Supermagnum/SDR-repeater/analog/vco/sch/README.md

# P2.7.1 xschem capture (VCO + D22 amp-cal + D21 LDO)

Generated by `gen_xschem.py` from `step2/out/range.json`, `ampcal/amp_common.py`, and `ldo/run_d21_vrana1.py` `ldo_body`.

## Hierarchy

| Cell | Role |
|---|---|
| `l2n0` | Tapped inductor lumped EM model |
| `vco_core` | XC pair + fixed MIM |
| `vco_bank` | 8-bit bank + trims + bypass |
| `vco_var` | AC-coupled svaricap_fx + bypass |
| `vco_tail_dac` | D22 OTA DAC + tail + D9 filter |
| `ampcal_det` | D22 peak det + SE comparator |
| `vrana1_ldo` | D21 LDO |
| `vco_sim_flat` | Flat VCO for netlist/sim export |

Exports: `exports/*.svg`, `exports/*.pdf`. Netlists: `netlists/`. Summaries: `out/summary_*.txt`.
