Supermagnum/SDR-repeater/reports/sch-rerun-2026-10-31.md

# VACASK SCH re-run before P2.7 — 2026-10-31

Pre-layout check of results that status-2026-10-30 only file-checked. Image `hpretl/iic-osic-tools:2026.10`, PDK `a49358cc`, VACASK `fb8cc20`.

| Block | Command | Result | Verdict |
|---|---|---|---|
| VCO range | `run_step3.py range` | All 15 cases cover; peak V_GS/V_GD ≤ 1.48 V | **pass** |
| VCO PSS root cause | A/B + parts | Off-state **bank** bypass MOS break PSS; tail and varactor OK | `summary_pss_bypass_parts.txt` |
| VCO PN (bank omitted) | `run_pnoise_nobank.py` | tt 3.65: −122.7 dBc/Hz @ 1 MHz (+6.7 dB); ss85 4.20: −119.4 (+3.4 dB) | **pass** — VCO layout may start |
| VCO PN (full MOS bank bypass) | PSS + ZOH transient | PSS abort; ZOH timestep-too-small | — |
| VCO PN (linear bank equiv) | `run_pnoise_banklin.py` + probes | PSS abort (full C/R/Rsh; C-only; bank-only; 0.1×C) | abandoned |
| VCO switch-noise bound | `run_bound_bank_switch.py` | tt 3.65 Δ = +0.591 dB (FAIL); ss85 Δ = +0.006 dB | **STOP** vs ≤0.5 dB |
| LO UHF tt | `lo/step3 corners uhf tt` | divide OK | **pass** |
| PLL 2 µs smoke | `run_p26s3.py tstop=2u` | start-up OK | **smoke pass** |
| UHF LO floor | `run_uhf_floor.py` | **full** ÷2+Johnson chain; −150.1 dBc/Hz @ LO | **pass at −150 limit** (optimistic: noisefmax 5 GHz) |

## UHF LO floor

Full UHF path (buffer + CML ÷2 + AC converter + Johnson ÷4 / retiming). Converges at noisefmax **5 GHz** only (50/20/10 GHz abort). LO-referred **−149.4 / −150.1 / −151.4 dBc/Hz** at 1–3 / 3–10 / 10–30 MHz. Recorded as meeting the −150 dBc/Hz limit; the truncated ÷2+converter figure (−155.7) was a partial-chain method and is not the floor used in totals. Totals: `summary_total.txt` (UHF −145.3 / −143.8 dBc/Hz at 36 MHz). Divider unchanged.

## VCO pnoise

| Bypass devices present | PSS |
|---|---|
| none | PASS |
| tail only | PASS |
| varactor only | PASS |
| bank only | FAIL |
| all (current schematic) | FAIL |

Bank-omitted PN is accepted for starting VCO layout. Linear off-state bank equivalent abandoned (PSS fails). Bound: bank-plate R noisy vs quiet + ρ = (2q·I_leak)/(4kT/R) from DC I_leak (`summary_bound_bank_switch.txt`) — tt 3.65 **FAIL** (+0.591 dB with ff/125 °C I_leak); ss85 PASS. **STOP** vs ≤0.5 dB. Post-layout PN: bank-omitted PEX + this bound until VACASK is fixed (`spec/p27-layout-notes.md`); method not cleared at tt. Draft issue (not posted): `reports/upstream-issues/vacask-pss-off-nmos-tank.md`. Dividers and PLL layout may start.
