Supermagnum/SDR-repeater/reports/status-2026-10-30.md

# Status audit and verify — 2026-10-30

Prompt 01. Tools: host Python 3 + container `hpretl/iic-osic-tools:2026.10`. Image PDK `/foss/pdks/ihp-sg13g2/COMMIT` = `a49358cc0b20635fcb53c0940505e3563763fc7a`. VACASK `fb8cc20`, ngspice 47. No design or spec edits except refreshing `analog/pll/p26/step2/out/summary_total.txt` from a re-run (see mismatches).

---

## Phase 0 — EM / process setup

| Step | Status in the spec | Files that prove it | Re-run OK? | Open points |
|---|---|---|---|---|
| Matched-mesh tank EM (L2n0) | Accepted 2026-10-20; Q 14.2 / 15.3 / 16.9 | `spec/provisional-tank-q.md`, `reports/phase2-review/p20-stage*.md` | not re-run (EM hours; stack pin unchanged) | — |
| Flicker / pnoise method | Validated | `analog/pn-validation/`, `reports/phase2-review/p20-flicker.md` | not re-run | — |

## Phase 1 — digital back end

| Step | Status in the spec | Files that prove it | Re-run OK? | Open points |
|---|---|---|---|---|
| `phase1l` sign-off | Signed off; area 339 617 / 340 000 µm² | `decisions.md` 2026-10-19; `rtl/digital/runs/`; `reports/phase1-review/` | not re-run (layout hours) | No area left; `rx_on`/`tx_on` expose deferred |
| cocotb / gate | Suites recorded pass | `rtl/digital/` | not re-run this session | — |

## Phase 2 — LO / synthesizer

| Step | Status in the spec | Files that prove it | Re-run OK? | Open points |
|---|---|---|---|---|
| P2.0 tank Q | Done, accepted | `spec/provisional-tank-q.md` | see Phase 0 | — |
| P2.1 D1–D7 | Accepted | `decisions.md` | N/A (decisions) | — |
| P2.2 system model | First run; later superseded by D19 | `analog/pll-model/` | model still runs; D19 values live in p26 | Spec still says “draft”; plan §3 more current |
| P2.3 VCO (D20 8-bit) | Schematic done; result review done | `analog/vco/step1–3/out/summary_*.txt`, `spec/vco-topology.md` §9 | SCH not re-run (VACASK hours); svaricap pin checked | Amplitude cal, supply pushing, HBT compare, real CML load |
| P2.4 LO dividers | Accepted 2026-10-21 | `analog/lo/step3/out/`, `spec/lo-divider-topology.md` §9 | SCH not re-run | Layout P2.7; UHF floor method |
| P2.5 PFD/CP/MMD/RTL | Complete, accepted | `analog/pll/step1–4/`, `rtl/afe/` | RTL re-run pass; SCH not re-run | — |
| P2.6 closed loop | Steps 1–4 done; **owner review next** | `analog/pll/p26/`, `spec/pll-topology.md` §13 | Models re-run pass; SCH closed-loop / LO UHF not re-run | Open points 1–4 in §13; no acceptance in `decisions.md` yet |
| P2.7 layout | Not started | — | — | Blocked on P2.6 acceptance |

## Board / host (existing)

| Step | Status in the spec | Files that prove it | Re-run OK? | Open points |
|---|---|---|---|---|
| VHF harmonic LPF | Decided; scripted | `tools/vhf_lpf_check.py`, `docs/rf-switches-and-filters.md` | **pass** this session | Layout parasitics not in script |
| RF switch survey | Survey | `docs/rf-switches-and-filters.md` | N/A | Parts not final; PDF not in repo (link only) |

---

## Step 2 — verify vs limits

Legend: **pass** = re-ran this session and meets limit (or within ≤ 0.5 dB / ≤ 2 % of recorded). **file-ok** = recorded `out/summary_*.txt` meets limit; transistor VACASK not re-run this session. **not-re-run** = blocked or not applicable yet. **fail** = none this session.

### Phase 2 LO / synthesizer

| Item | Limit | Recorded | This session | Verdict |
|---|---|---|---|---|
| Tank Q | — | 14.2 / 15.3 / 16.9 | files only | file-ok / not-re-run EM |
| VCO range 8-bit, 15 cases | covers 3.12–4.20 GHz ±3 % L | 2.77–4.55 GHz, all cover | `summary_8bit.txt` | file-ok |
| VCO band steps | even; V_tune window | 0.94–1.07×; 0.24–0.29 V | `summary_steps.txt` | file-ok |
| VCO PN @ 1 MHz | ≤ −116 / −115 | −124.4 … −119.9; +3.9 dB worst | same | file-ok |
| K_VCO | 14–47 MHz/V | 13.1–38.8 | same (bottom slightly under D8 floor) | file-ok (known from review) |
| Peak V_GS / V_GD | ≤ 1.5 V | ≤ 1.48 V | same | file-ok |
| Tail current | ≤ 4 mA | 3.4–4.0 mA | same | file-ok |
| LO dividers corners / MC | divide | all pass (ss −40 °C needs real swing); 100/100 | files | file-ok |
| UHF I/Q / VHF 8-phase / duty | image / HR / ≈25 % | σ 0.47°/0.77°; 0.17°/0.28°; 22.6–25.8 % | files | file-ok |
| Divider noise floor | ≤ −150 dBc/Hz | VHF −154.9/−154.0/−155.5; UHF ≈ −150 `[HAND]` | VHF file; **UHF no convergence** | VHF file-ok; UHF **not-re-run** (method) |
| LO / PLL current | ≤ 10 mA typ; PLL ≤ 1.8 mA | ≈ 9.65 mA; PLL ≈ 1.0 mA | files | file-ok |
| Loop D19 | 60 kHz / 55° | C1 30.8 pF, C2 465 pF, R1 22.9 kΩ, R3 108 kΩ, C3 3.1 pF | confirmed in `closed_loop.py` re-run | **pass** |
| Total PN duplex `[MODEL]` | ≤ −136 dBc/Hz | VHF worst −138.8 (+2.8); UHF −145.2 / −143.7 | `run_p26s2.py total` matches after refresh | **pass** |
| Wake | ≤ 150 µs | 83–120 µs; cal 38.8 µs | `closed_loop.py` full re-run: wake 83–120 µs | **pass** |
| V_tune after cal | 0.25–0.95 V | 0.34–0.82 V | `land` + closed loop | **pass** |
| PFD / CP | no dead zone; INL | ≤ 3.9 ps MC; ≤ 2.1 ps with bias | files | file-ok |
| CP noise FoM | accepted as-is | −203.8 … −205.6; 1/f 79–141 kHz | json inputs to total | file-ok (FoM used) |
| Bias / lock window / hold D19 | I_cp ±2 %; 5–12 ns; ≤ 10 mV | within 2 %; 5.5–10 ns; ≤ 7.6 mV | files | file-ok |
| AFE RTL cocotb | all pass; Σ-Δ bit-exact | recorded pass | `run_afe.py` all PASS | **pass** |
| MMD first 2/3 cell | ≥ 1.3 × 2.2 GHz ss | 2.9 GHz; 10/10 | files | file-ok |
| Closed loop step 3 | locks from power-on | locks, 5× filter, ≤ 7 ppm from 16 µs | `summary_s5.txt` | file-ok |
| Ref / frac spurs `[MODEL]` | ≤ −67 / −95 dBc | −109.3; −123 / −126 | `spurs.py` re-run identical | **pass** |

### Other

| Item | Limit | Recorded | This session | Verdict |
|---|---|---|---|---|
| Digital `phase1l` | signed off | 339 617 µm² | files / decisions | file-ok / not-re-run |
| VHF LPF | ~0.5 dB / ≥ 70 dB | 0.37–0.94; ≥ 70.6; MC ≥ 65.4 | script match | **pass** |

---

## Prompt 02 “Results to re-check” — disposition

| # | Item | Disposition |
|---|---|---|
| 1 | UHF LO-chain noise floor | **Cleared as unverified method limit**, not as a SCH pass. Still ≈ −150 `[HAND]`; transient noise does not converge. Closes “waiting for re-check” for prompt 06 gate: no tool update will fix it (IHP #1047 class / wontfix). Close open point 3 only via a new method (prompt 06 item 2(c)). |
| 2 | First KLayout LVS SVaricap | **not-re-run** — no layout yet; #861 / #753 open |
| 3 | First KLayout LVS `cap_rfcmim` | **not-re-run** — no layout; #512 open |
| 4 | Maximal DRC SVaricap `w=3.74u` | **not-re-run** — P2.7 |
| 5 | HBT local-mismatch MC | **not-re-run** — not used for LO core today; #1112 |
| 6 | Full-chip ngspice with IO | **not-re-run** — no pad-level deck yet; #921 |
| 7 | Magic stdcell spice mix | **not-re-run** — not used; #810 |
| 8 | VCO/PLL with `sg13_hv_svaricap_fx` | **pass (pin check)**: in image PDK, `rwellvw`/`rwellwvw`/`rwellnxvw` still 0; `dsubw` `vj=0.3357`; `svaricap_fixed()` regenerates `out/svaricap_fx.lib` with `v(2,4)` terms replaced by 0. Full VCO/PLL VACASK not re-run (runtime); prior SCH files remain the evidence. |

For prompt 06: **no failed re-run**. Unverified SCH rows are file-backed; the only open “result” that blocks a numeric claim is UHF LO floor, already called out as open point 3 / method change — not a gate stop for the P2.6 review summary.

---

## Mismatches (spec / files / this re-run)

1. **`analog/pll/p26/step2/out/summary_total.txt` was stale.** Committed copy used UHF LO floor −157 dBc/Hz and totals −146.6 / −144.6 (32 MHz). Spec §13 and the current `total` path use ≈ −150 and −145.2 / −143.7. **Refreshed this session** from `run_p26s2.py total`. VHF rows were already correct.
2. **`spec/phase2-plan.md` header** still reads “draft … Nothing in this plan has been designed…” while §3 shows P2.0–P2.6 progress. Finding only — not edited (prompt 01).
3. **K_VCO recorded 13.1 MHz/V** at the bottom vs D8 “14–47 MHz/V”. Already known from P2.3 review; still in the files.
4. **`docs/pe42820ds.pdf`** was untracked locally. Vendor datasheet should stay out of git; link remains in `docs/rf-switches-and-filters.md`.
5. **PCB KiCad** (`PCB/sdr-repeater/*.kicad_*`) dirty in the working tree — owner-owned; not touched.

---

## VACASK upstream (Codeberg, hand look)

Repo: https://codeberg.org/arpadbuermen/VACASK

| Topic | Finding |
|---|---|
| Svaricap / `v(2,4)` expression | No matching issue found. Gap remains IHP model conversion + local `_fx` draft (`reports/upstream-issues/ihp-svaricap-vacask-v24.md`), not a VACASK ticket. |
| Transient / timestep / stiff sims | Historical timestep demos (#1, #2); open **#83** Tolerance limitations. No fix that would make UHF LO noisy transient converge. |
| pnoise feature | Open **#20** “Enable Pnoise analysis” (feature request). Does not change the UHF floor situation for our existing pss/pnoise + transient path. |

---

## Environment note

Container PDK is shipped as a tree with `COMMIT` file (not a live `.git`). Pin matches `a49358cc…`.
