Supermagnum/SDR-repeater/decisions.md

# Decisions

Human decisions for the SG13G2 VHF/UHF RFIC. An entry is added only after a person approves it.

## 2026-10-17 — Phase 0 review

Approved:

- Container `hpretl/iic-osic-tools:2026.10`.
- PDK commit `a49358cc0b20635fcb53c0940505e3563763fc7a`, the commit named in that image. It contains the RF MOSFET LVS change (pull request 1246, merge `f7bca326`) and is 26 hours before `dev` `89d42ee`. `89d42ee` is not pinned. The two commits have diverged: 43 commits are only on `dev`, and 48 commits are only in the image, mostly the `sg13g2_stdcell_hv` library.
- KLayout DRC flag `--minimum_drc`.
- EM workflows `gds2palace` `v0.8.2` (`ed063dc9`) and `gds2openEMS` `v0.5.0` (`99d8bd18`). Stack-up XML is taken from the pinned PDK commit.
- CACE `fossi-foundation/cace` 2.13.0.
- cocotb 2.1.0 from the image. No project venv.
- Rejections: `efabless/cace`, `AliSahafi/Analog_OpenSource_ihp`, QUCS-COPEN.
- ngspice 47 experimental PSS is allowed. Phase-noise results stay lower confidence.
- Supply assumption replaced by regulated host rails, with buck ripple and spur tolerance required. See `spec/baseline-decisions.md`.
- PLL references 32 MHz and 36 MHz. Spur map: `spec/integer-boundary-spurs.md`.
- I2S slot width 16 or 32 bits, MSB-justified, 16-bit baseline.
- LinHT facts stay provisional. USB-A part numbers wait.

Recorded after those approvals, not a new topology decision: `SG13_Octagon_L2n0` L and Q at 2.4 GHz and 3.5 GHz are in `reports/phase0-review/em-l2n0.md`. That file is a regression baseline. It is not a pass or fail against a specification.

Not approved at that point: any analog topology, and any push.

## 2026-10-17 — Phase 0 EM review

Approved:

- Stay on PDK `a49358cc`. Do not follow `dev`. Reconsider the PDK pin only at a phase review gate.
- The image commit does contain the RF MOSFET LVS change. `rfmos_extraction.lvs` extracts `rfnmos`. `rfmos_model_mapping.lvs` is not in the image.
- Both EM solvers use the pinned-PDK openEMS stack-up `SG13G2_200um.xml`, sha256 `5d452943`. The Palace workflow XML in the same commit is a different stack and is not used. Hashes are in `reports/phase0-review/em-l2n0.md`.
- Matched mesh, shared port de-embedding, and a comparison to a compact model or IHP measured data are required before Phase 2. They are not a Phase 1 blocker. No compact model and no `L2n0` measured file were found in this PDK commit.
- Provisional tank Q is the openEMS value: 11.8 at 2.4 GHz and 14.9 at 3.5 GHz. See `spec/provisional-tank-q.md`.
- Phase 1 digital back end may start. Analog topology is still not approved.

## 2026-10-17 — Phase 1 review, not approved

The first Phase 1 submission was not approved. The resubmission is on `phase1/digital` and is waiting for review. It is not an approval and it is not a topology decision.

Recorded in `reports/phase1-review/summary.md`:

- SPI frame approved. Register map frozen at this gate, addresses `0x00` through `0x13`.
- I2S master by default, and the b14/b15 direction change, approved as a proposal. 16-bit slots at 500 kHz are the repeater recommendation. The 36 MHz three-clock BCLK cells miss the i.MX93 S12 pulse-width window. The K3 datasheet publishes no slave pulse-width limit.
- Proposed signoff junction temperature is 100 °C. The PDK liberty has no 85 °C or 100 °C corner. The 125 °C slow corner is reported from the post-CTS database.
- The 45 dB alias limit stays provisional pending Phase 3 modulator co-design.
- LinHT IQ stays provisional.
- Placed area is above the 0.25 mm² target. See the review for the measured core and cell area.
- The matched-mesh inductor study may run in parallel. It has not been started. Phase 2 has not been started and still needs approval.

## 2026-10-18 — Hold clock uncertainty
Setup uncertainty stays at CLOCK_UNCERTAINTY_CONSTRAINT (0.25 ns). Hold uncertainty is 0.05 ns
(`set_clock_uncertainty -hold 0.05`), because clocks are propagated after CTS and the
TCXO/VCTCXO reference jitter is in the picosecond range. The previous 0.25 ns on hold, plus
the 0.1 ns resizer margin and 5 % derate, drove 6,449 hold buffers.

## 2026-10-18 — SPI mode 0 and power-up reset
MISO changes on the SCLK falling edge; the host samples on the rising edge (mode 0).
Previously MISO changed on the rising edge, which would have shifted every read by one
bit on a real host. Board requirement: rst_n must be held low at power-up until the
supplies and the reference clock are stable (asynchronous reset, level-sensitive).

## 2026-10-18 — CACE version and maximum IQ rate
CACE: use 2.11.0, the version in hpretl/iic-osic-tools:2026.10 (manifest updated).
Maximum RFIC IQ sample rate: 500 kHz (25/50/100/200/500 kHz). README updated from 1 MHz /
32 MHz BCLK to 500 kHz / about 16 MHz BCLK. Matches the LinHT 500 kHz target, keeps BCLK
within the i.MX93 SAI slave limits, and keeps the Sigma-Delta oversampling ratio at 64/72.

## 2026-10-18 — I2S format: Philips (standard I2S)
Master and slave use Philips I2S: LRCLK low = left (I), high = right (Q), changing one bit
before each MSB; data and LRCLK change on the BCLK falling edge, sampled on the rising edge.
Previously data changed on the rising edge (the host's sampling edge) in both modes.
Reset: clk domain released through a 2-flop synchroniser; SCLK must stay idle >= 1 us after rst_n rises.
Test note: logic on gated clocks updates after clk's rising edge in RTL simulation, so
testbenches drive inputs on clk's falling edge.

## 2026-10-18 — Continuous I2S BCLK
BCLK runs without gaps at every rate: frame = 2 * slot * bit_cell reference clocks.
36 MHz / 500 kHz enabled (BCLK 18 MHz: over the 16 MHz repeater-backplane cap, which applies
to the 32 MHz repeater modules, but within the i.MX93 SAI slave limits for LinHT).
36 MHz / 200 kHz: no 50 % split exists (180 = 2*18*5); 40/60 duty, exactly on the i.MX93 limit.
Accepted and documented; LinHT should prefer 100 kHz or 500 kHz.

## 2026-10-18 — Frequency coverage 130–175 MHz + 400–480 MHz; duplexer confirmed

- **Decision:** the RFIC tunes 130–175 MHz and 400–480 MHz, covering amateur bands, land mobile and PMR446. This replaces the amateur-only baseline (README 11.1).
- **Owner input:** repeater sites share one antenna between RX and TX through a duplexer on 2 m and on 70 cm.
- **Norwegian offsets:** 600 kHz (2 m) and 2 MHz (70 cm), taken from the repeater list.
- **Limits:** derived in `spec/derived-limits.md` and replace the provisional ones.
- **Consequences, Phase 3 analog:**
  - harmonic-reject VHF mixer and/or preselector;
  - LO plan with a VCO at 3.12–4.20 GHz, ÷8 for UHF and ÷24 for VHF (as `band_sel` in the RTL);
  - analog anti-alias of ≥ 40 dB at ±8/9 MHz and ≥ 70 dB at ±32/36 MHz;
  - selectable TX reconstruction filter.
- **Consequences, system:**
  - the host picks the 32 or 36 MHz clock per channel by the harmonic table;
  - 500 kHz TX is for simplex use only.
- **Digital backend:** unchanged.

## 2026-10-18 — Area: calibration moved to the host, target ≤ 0.34 mm²

- **Metric.** Real cell area = `design__instance__area__stdcell` + `design__instance__area__macros` (no filler). Phase1i: 0.434 mm². The earlier 0.708 mm² figure included 0.274 mm² of filler cells. Checked by `tools/check_area.py` (limit 340 000 µm²).
- **Decision (a).** DC and IQ correction for RX and TX are done by the host software. The digital chain is linear, so host-side correction is equivalent. Removed: `iq_cal`, `dc_offset`, the TX calibration stage, and registers 0x04–0x07 and 0x0D–0x12 (now reserved, read 0). `BLOCK_PD[2:1]` and `CLK_GATE[2]` are reserved. `CHIP_ID` 0x11 → 0x12. All other addresses keep their numbers.
- **Other reductions.** `sample_fifo` depth 8 → 4. TX integrators and the shared `cic4` adders 40 → 28 bits (maximum value 32767 × 720 < 2²⁵). One RAM address generator in `fir_seq` (bit-identical: 0 mismatches over 120 000 random cycles against the old module). `relock_cnt` sized from `RELOCK_CYCLES`.
- **Not done.** 0.30 mm² is not reachable without removing functions. CIC1 narrowing (bypass path uses 16-bit input) and reserved-bit trimming were judged not worth the risk.
- **Tests.** `phase_cross_term` and `dc_retained_across_sleep` removed with the blocks they tested. `filter_response_limits` now also checks the duplex-offset (≥ 100 dB) and on-channel (≥ 65 dB) alias limits; `tx_image_and_noise` checks the bitstream noise at 600 kHz and 2 MHz against `spec/derived-limits.md`.

## 2026-10-19 — Timing-driven placement and post-route setup repair

- Phase1j missed setup by 0.050 ns (slow corner, 4 endpoints: SRAM `A_DOUT` → half-band MAC). The same path had +0.80 ns in phase1i; the difference is placement and routing, not the RTL. Everything else in phase1j passed (LVS, DRC, antenna, max-cap 0; gate-level 5/5; Magic 7 818, all inside the SRAM).
- Setup was never repaired with real routing loads (`RUN_POST_GRT_RESIZER_TIMING` false, `PL_TIMING_DRIVEN` false). Both are now on, with a 0.1 ns setup margin and a 0.1 ns post-route hold margin (keeps the 0.08 ns hold guard).

## 2026-10-19 — RF front end: SX1255-compatible drop-in, repeater RX default, phase-noise tool

- **Option P:** the RFIC is pin-compatible with the SX1255 (MLPQ-W 5 × 5 mm, 32 leads), so the LinHT can take it without a respin for UHF. The SPI frame is already identical (mode 0, write bit + 7-bit address + data). IQ uses the SX1255 "mode B2" I2S pins. Not register-compatible: the host driver changes.
- **LinHT Rev C facts (schematic, 2026-07-14):** 32 MHz TCXO; the 2× PE4312 attenuators are in the RX path, TX power is set inside the transceiver; the SX1255 TX output is used single-ended. IQ is 500 kSa/s, 16-bit I/Q as left/right audio (M17 project).
- **Reset:** the SX1255 RESET pin is active-high and floats in normal operation. The RFIC needs an internal pull-down and an on-chip power-on reset.
- **Repeater RX front end:** the 2× PE4312 attenuators are the default (system NF ≈ 8 dB); an external LNA is a module-designer option (≈ 5 dB). Limits re-derived in `spec/derived-limits.md` §8.
- **TX output:** −5 dBm nominal into the existing GRF5604 match; ≥ 30 dB analogue gain control after the reconstruction filter (digital scaling would break the duplex-noise budget).
- **Phase noise:** VACASK `pnoise` validated (`analog/pn-validation/`); use `pss_minpts` ≥ 8000 for close-in offsets.
- Requirements: `spec/rf-frontend.md` (draft for human review).

## 2026-10-19 — Interface pins, duplex module, five slots, VHF filter, 100 W parts
- **`ref_36`:** strap on SX1255 pin 11 (CLK_IN), sampled while RESET is active, internal pull-down: open = 32 MHz (LinHT unchanged), high = 36 MHz. Readable in a status bit. Changing it needs a reset, consistent with the static false path.
- **Backplane c2 (PTT) → RFIC DIO3:** hardware PTT gate with pull-down, ignored unless `ptt_pin_en` is set (default: SPI-only TX, as the SX1255 and the LinHT). **Backplane c1 (IRQ) ← RFIC DIO1:** active-low IRQ, enabled by register; open-drain buffer on the module. RTL change together with the other Option P pin-map changes (Phase 5).
- **LinHT I2S format confirmed** (read-only, `meta-linht-hardware` `sbc-mcm-imx93.dtsi`): `format = "i2s"`, SX1255 is bit-clock and frame master on both links. Matches the chip default.
- **Same-band repeater = one duplex module in one slot:** two RFICs, shared reference; RX RFIC is I2S master, TX RFIC is slave on the same port; TX RFIC chip select on b5 (SWR ADC then I²C); two front-panel ports to the cavity duplexer; no T/R switch. EEPROM types 0x0005 (2 m duplex), 0x0006 (70 cm duplex).
- **Five slots, A–E** (README is canonical): `iq_E` / `tx_E` and `module_id` 4 added in `zeromq-messages.md`, `ht-module-daemon.md` and `RF-modules.md`.
- **VHF harmonic filter covers 130–175 MHz (owner decision):** 7th-order elliptic-type ladder with traps at about 263 / 309 / 511 MHz, ≥ 70 dB from 256 MHz; values and part stress in `docs/rf-switches-and-filters.md`; check with `tools/vhf_lpf_check.py`.
- **100 W parts:** MACOM MSW2040-204 (symmetrical) for band switching, MSW2050-205 (asymmetrical) for T/R; 125 V reverse bias needed at VHF; orderable, quote needed. ATC 100B: 3 W dissipation limit; two in parallel (or 100C/100E) at the 100 W shunt positions until the ESR chart is read.

## 2026-10-19 — Pin-map RTL (block level)
- `ref_36` is latched while the reset synchroniser is in reset (pin-11 strap); `INFO[0]` reads it back.
- `CTRL[3]` (was reserved) enables the hardware PTT gate: in TX mode the core holds standby unless `ptt_pin` (DIO3) is high. Default off.
- `IRQ_EN` (0x14) masks FIFO overflow, FIFO underflow, clk_error and PLL-not-locked onto `irq_n` (DIO1), a registered active-low level. New input `pll_lock` from the analogue PLL.
- `INFO` (0x15, read only): latched `ref_36`, synchronised `ptt_pin` and `pll_lock`.
- CHIP_ID 0x12 → 0x13. New ports: `ptt_pin`, `pll_lock` (in), `irq_n` (out); SDC false paths added for them.
- Chip-top items unchanged in this block: active-high RESET with pull-down and power-on reset, I2S word select on DIO2, `clk_req` on DIO0.
- Tests: RTL suite 14/14 on Icarus (new `pinmap_ref36_ptt_irq`, also in the gate-level list); `master_frame_lengths` now resets after changing `ref_36`. `verilator -Wall` clean. Needs a new layout run (`phase1l`).

## 2026-10-19 — PLL spur limits; 100B capacitors at 100 W
- Spur limits in `spec/derived-limits.md` §9: duplex offset ≤ −95 dBc (25 W) / −88 dBc (5 W) for RX LO and TX; TX elsewhere −67 dBc design target (regulatory −57 dBc); RX elsewhere −84 dBc and adjacent channels −65 dBc as proposals to confirm against the applicable standard.
- Integer-boundary spurs on the duplex offset (**corrected the same day**: the first count divided the spur offset by N; division keeps the offset and only lowers the level). With both references: 2 of 161 2 m channels (144.0125, 144.025 MHz) and 5 of 801 70 cm channels (431.750, 431.875, 432.125, 432.250, 436.250 MHz). Whether the PLL meets the limit there is decided by the Phase 2 model (`spec/phase2-plan.md` P2.2).
- ATC 100B ESR read from the datasheet chart: two 100B in parallel at C3 and C5 of the VHF filter at 100 W; single parts elsewhere and at 5–20 W.

## 2026-10-19 — phase1l signed off; Phase 2 plan drafted
- `phase1l` (pin-map RTL): sign-off pass — setup +3.99 ns, hold +0.089 ns (guard 0.08), LVS match, antenna 0, KLayout DRC 0, Magic DRC 7 815 (unchanged, inside the SRAM, waived), real area 339 617 µm² of 340 000. Gate level 6/6. The digital back end has no area left.
- `spec/phase2-plan.md`: LO budgets (VCO ≤ −116 / −115 dBc/Hz at 1 MHz), loop proposal (100–150 kHz, MASH 1-1-1, fPFD = reference), steps P2.0–P2.7, decisions D1–D7 for the owner.

## 2026-10-19 — Phase 2 owner decisions D1–D7; P2.2 model
Accepted as proposed in `spec/phase2-plan.md` §5:
- D1 VCO core: NMOS cross-coupled (the validated case), SiGe HBT version as comparison.
- D2 one wide-range VCO with a 5–6-bit capacitor bank.
- D3 the Σ-Δ modulator goes in a separate small digital PLL block; the back end stays at 0.34 mm².
- D4 VHF LO: 8 phases (÷3, then 8-phase ÷8) for the harmonic-reject mixer.
- D5 loop bandwidth 100–150 kHz.
- D6 the integer-boundary channels must meet the spur limit in the PLL; host avoidance only if the model shows it cannot.
- D7 LO current ≤ 10 mA of the 25 mA RX budget.

P2.2 linear model (`analog/pll-model/`, all inputs `[PROP]`): passes at 150 kHz (lock 125 µs; 100 kHz needs 187 µs, so 150 kHz is chosen within D5). Duplex-offset phase noise −137.2 dBc/Hz (VHF) and −139.4 (UHF); the VCO term dominates and L(1 MHz) must stay ≤ −115 dBc/Hz. Boundary spurs on the hit channels pass if the raw spur is ≤ −35 dBc (VHF) / −20 dBc (UHF), so D6 holds on this model. Loop filter ≈ 400 pF.
- `phase1l`: IHP full KLayout DRC (maximum rule set, antenna, no density) 0 violations (2026-10-19). Phase 1 is complete pending the human review gate.

## 2026-10-19 — Analogue–digital interface (draft)
- `spec/analog-digital-interface.md`: the signed-off back end keeps its converter, `band_sel` and `pll_lock` interface; the analogue enables, RX/TX gain words, filter selects, PLL frequency word, frac-N Σ-Δ and VCO band calibration go in a new AFE/LO control block (D3) on the same SPI bus at 0x20–0x3F, MISO ORed at chip top.
- Proposed small back-end change for the next layout run: expose `rx_on` / `tx_on` so the enable sequencer follows the effective mode (PTT gate, duty cycling).

## 2026-10-19 — P2.0 stage 1 (EM tank Q)
- Palace (surface conductors) converged at 2 µm: L 1.672 nH, Q 19.70 at 3.65 GHz. openEMS not converged (Q 14.60 → 15.26 from 2 to 1 µm; extrapolated 15.5–15.9).
- The upstream L6n2 measured-vs-simulated data (gds2palace v0.8.2) shows this Palace setup (surface conductors, merged vias without fill-factor correction) reading Q 24 % high at 3.5 GHz; scaled, L2n0 Q ≈ 15.6–15.9, matching openEMS. Provisional design Q 14.9 kept until stage 2 (filled metals + via correction, openEMS 0.7 µm).

## 2026-10-20 — P2.0 EM result accepted (tank Q)
- Design tank Q and L of SG13_Octagon_L2n0 from P2.0 stage 2 (`reports/phase2-review/p20-stage2.md`): Palace, filled metals + via fill-factor correction, 1 µm (converged), de-embedded. Q 14.2 / 15.3 / 15.5 / 16.9 at 3.12 / 3.5 / 3.65 / 4.2 GHz; L 1.69 nH. Replaces the provisional 14.9 (`spec/provisional-tank-q.md`).
- openEMS 0.7 µm agrees within 1.6 % in Q; L differs by a constant 3 %, carried as ±3 % L uncertainty for VCO tuning (P2.3).
- Stage 3 not run (not needed for the decision). The flicker-region pnoise check remains open in P2.0.

## 2026-10-20 — VCO topology (P2.3), D8–D10
Accepted as proposed in `spec/vco-topology.md` §5, after a comparison with common industry practice:
- D8 capacitor bank 7 bits instead of D2's 5–6: KVCO 14–47 MHz/V instead of 29–94; at 94 MHz/V the loop-filter resistor noise failed the VHF duplex limit (P2.2 rerun: −135.3 against −136 dBc/Hz) unless the loop filter grew to about 950 pF. `VCO_BAND` becomes [6:0].
- D9 VCO tail: NMOS current source, RC-filtered bias (pole ≤ 10 kHz), tail capacitor 5–10 pF; class-C biasing evaluated as a variant in P2.3. New register `VCO_BIAS` (0x2C) for the tail-current DAC.
- D10 dedicated LDO for the VCO, voltage set by the LV device limits (about 1.0–1.2 V).
- Core as D1 (NMOS cross-coupled, HBT comparison); varactor `sg13_hv_svaricap`; CML buffer before the dividers. Next: device checks (`spec/vco-topology.md` §6).

## 2026-10-20 — VCO step 1 results; D11 varactor bias
- Step 1 device checks (`spec/vco-topology.md` §8): 1.5 V differential swing at a 1.1 V centre tap (LV oxide limit with 10 % margin); bank cell about 100 µm of switch per 60 fF with 200 kΩ bias resistors (bank keeps 0.89–0.97 of tank Q, +226 fF budget margin); tail LV NMOS ≥ 160/4 µm; L2n0 lumped model within 0.71 %.
- D11: **AC-coupled varactor** (option A): `sg13_hv_svaricap` behind coupling MIMs of about 5×, gates biased through ≥ 200 kΩ, so the steep part of the C–V curve falls in the 1.2 V charge-pump range. Option B (charge pump and loop filter on the 2.7–3.6 V supply) not chosen: about twice the loop-filter area.

## 2026-10-20 — P2.3 VCO result review
- Accepted: about 5 % more switched capacitance in the bank (`spec/vco-topology.md` §9, point 2), so the bottom edge keeps margin below 3.12 GHz at the MIM best-case corner with the ± 3 % inductance uncertainty. Step 2 sizing target 955 → 1003 fF; steps 2–3 to be rerun.
- Not chosen at this review: the 4 mA cap on the tail current (the bottom bands keep 5 mA; the LO current budget D7 is checked again with the dividers in P2.4) and an amplitude calibration. The remaining items of §9 (supply pushing, real buffer and divider load, HBT comparison, tapped-inductor EM) stay open.
- Rerun after the review (2026-10-20): range 2.90–4.41 GHz; bottom edge at the MIM best-case corner 3.036–3.047 GHz (73–84 MHz margin); phase noise unchanged within 1 dB, worst margin +3.6 dB (4.20 GHz, slow corner, 85 °C). P2.3 schematic phase closed; open points in `spec/vco-topology.md` §9.

## 2026-10-20 — P2.4 divider topology, D12–D14
- Topology as proposed in `spec/lo-divider-topology.md`: CML buffer after the VCO; UHF CML ÷2 then a Johnson ÷4 (quadrature); VHF CML ÷3 then a Johnson ÷8 (8 phases, D4); one chain powered per band.
- D12: the LO current budget stays ≤ 10 mA (D7); the **VCO tail current is capped at 4 mA** (this reverses the P2.3 review, where the cap was not chosen). Bottom-band phase noise about 2 dB worse, expected margin still about 6 dB; VCO step 3 to be rerun.
- D13: UHF LO as **four phases at 25 % duty**.
- D14: flip-flops after the first stage in **CMOS TSPC**; CML only if step 1 shows less than 1.3× speed margin at the slow corner, 1.08 V, 125 °C.

## 2026-10-20 — P2.4 step 2: divider start-up, D15
- Finding: with the dividers on while the VCO starts up, the CML ÷3 free-runs and at the slow corner stays there (VHF 4.20 GHz failed in the full chain; stand-alone `div3s` fails at 4.41 GHz with any clock ramp, also with 0.6–0.75 V final swing). Clock shape, duty cycle, load and latch current were ruled out (`div3x`).
- D15: **sequenced divider enable** — the AFE sequencer raises `en_lodiv` about 1 µs after `en_vco` and pulses it low again after a band change or a failed PLL lock; both chains. With the divider enabled after start-up the VHF slow 4.20 GHz case divides correctly (8 phases, errors ≤ 0.12°). Circuit-level removal of the free-running state was not chosen.

## 2026-10-20 — VCO rerun with the 4 mA cap; P2.4 step 2 done
- VCO step 3 rerun with D12 (`analog/vco/step3/out/summary_4ma.txt`): range and corners unchanged (2.90–4.44 GHz typical, bottom edge 3.040–3.050 GHz at the MIM best case); bottom-band phase noise 0.3–0.7 dB worse than with 5 mA, worst margin still +3.6 dB (4.20 GHz, slow, 85 °C).
- P2.4 step 2: all 8 cases (UHF / VHF, typical / slow, two frequencies) divide correctly with D15; phase errors ≤ 0.46° (UHF), ≤ 0.12° (VHF); UHF retiming output PMOS 2× for the 25 % duty (22.6–25.0 % at slow); LO current about 9.7–10.1 mA at VHF worst case, at the D7 limit.

## 2026-10-21 — P2.4 step 3: circuit fixes from corners and Monte Carlo
- VHF ÷3 could lock into a low-swing ÷2 mode (ff 125 °C; slow corner with mismatch). Fixed by a 1.5× regenerative pair and 0.5 V CML swing (reference tracking the swing); more latch current did not help.
- UHF counter failures traced to the CML-to-CMOS converter's duty (23–37 % at 1.92 GHz, slow); converter rebuilt as AC-coupled self-biased inverters (duty 47–52 %, slightly less current).
- Buffer middle stage AC-coupled and self-biased (bottom-band margin at 125 °C).
- Result: all corners divide (the ss −40 °C bottom-band case needs 0.33 V tank swing per side, the VCO gives about 0.43 V); 100/100 Monte Carlo samples; UHF raw image rejection 35.4–39.5 dB at 3σ; VHF phase σ ≤ 0.28°. LO total ≈ 9.65 mA typical, ≈ 10.3 mA at ff 1.32 V — for the result review. Noise floor still open.

## 2026-10-21 — D7 reading (LO current)
- Accepted (owner): D7 (LO ≤ 10 mA) is a **typical** figure, like the RX budget it is part of (≤ 25 mA against the SX1255's 18 mA typ, `spec/rf-frontend.md` §6). The LO meets it at typical (≈ 9.65 mA, VHF 4.20 GHz). The ±10 % supply corners are robustness checks; the LO runs from the on-chip regulator `VR_ANA1`, so the 1.32 V figure (≈ 10.3 mA) is recorded as a maximum, not held against D7. The margin depends on the PLL's hand estimate (1.5 mA) and is checked again with the real PLL in P2.5; above about 1.8 mA the LO buffer or converter has to give back current.

## 2026-10-21 — P2.4 step 3: noise floor
- Driven pss/pnoise on the divider edge path gave flat, corner-inverted results (−107 to −130 dBc/Hz) at both a floating and a driven node: method not usable for dynamic CMOS logic. Hand estimate used: σ ≈ 0.1 ps → ≈ −157 dBc/Hz (UHF, 480 MHz) and ≈ −161 dBc/Hz (VHF, 175 MHz) at the LO output, target ≤ −150. Simulation of the floor moves to P2.6.

## 2026-10-21 — P2.4 accepted; P2.5 topology proposed
- P2.4 (LO dividers and phase generation) accepted by the owner as in `spec/lo-divider-topology.md` §9. Carried forward: divider noise-floor simulation (P2.6), the −40 °C bottom-band swing margin (relies on the VCO's cold swing), layout (P2.7).
- P2.5 topology memo `spec/pll-topology.md` with proposals D16 (feedback divider clocked from the LO chain's first CML stage), D17 (MOS loop-filter capacitors C1/C2, MIM C3), D18 (charge-pump offset current and replica matching); estimated PLL current 0.8–1.3 mA.

## 2026-10-21 — P2.5 topology, D16–D18
Accepted as proposed (the owner accepted them as common industry practice):
- D16: the PLL's multi-modulus divider takes its clock from the LO chain's first CML stage (÷2 UHF / ÷3 VHF); MMD in CMOS. Σ-Δ quantisation noise +6 / +9.5 dB, still ≥ 17 dB below the total (`pll_model.py --presc`); the first divider stage runs whenever the PLL runs. Fallback: own CML prescaler (+1–1.5 mA).
- D17: loop-filter C1 and C2 as MOS capacitors, C3 as MIM (≈ 0.06 mm²).
- D18: charge pump with an offset current of about 5–10 % of I_cp and replica-feedback up/down matching.
Next: step 1 device and block checks (`analog/pll/step1/`).

## 2026-10-21 — P2.5 step 1 results
- Tuning window corrected to 0.25–0.95 V (one bank step is 0.45–0.52 V of V_tune).
- Charge pump: cascoded sources do not reach the window on 1.2 V; plain long-channel (L = 2 µm) sources do at typical and fast (slow 1.08 V: up side to 0.80–0.85 V → wider PMOS source in step 2, regulated supply). Replica amplifier must correct up to ±30 % mismatch.
- Loop-filter C1/C2 as complementary thin-oxide MOS pairs (within D17); leakage a few µA at 125 °C, reference spur ≤ −102 dBc (model).
- MMD first 2/3 cell in TSPC passes (÷3 to 2.9 GHz at the slow corner; 10/10 mismatch samples).

## 2026-10-22 — P2.5 step 2a: PFD and charge pump core
- Transistor-level PFD (static flip-flops, power-on reset) and charge pump (long-channel sources, current steering with matched complementary switch drivers, Miller-compensated replica loop, offset-current sink) pass at tt / ss / ff: no dead zone, INL ≤ 1 ps over a 4 ns range on the locked side, lock point 2.9–4.0 ns with a 10–16 µA offset current.
- Lessons from the eight runs: switch pairs must be driven by complementary signals of equal delay; an ideal fast replica amplifier makes the loop oscillate (needs Miller compensation); the PFD needs a power-on reset.

## 2026-10-25 — P2.5 step 2a done
- Replica amplifier and dummy-node buffer at transistor level as rail-to-rail symmetric transconductors; a matching offset-current source into the dummy node; all mirror devices built from unit fingers (ratios as finger counts).
- Result: INL 0.2–3.6 ps on the locked side at tt / ss / ff over 0.25–0.95 V, except slow corner at 0.95 V (19 ps; the up source runs short of headroom at 1.08 V). Recorded as the window limit at the slow corner (about 0.85 V); not fixed, since the calibration centres V_tune near 0.6 V and the pump supply is regulated. Bias currents of the amplifiers are still ideal (bias generator to come).

## 2026-10-25 — P2.5 step 2b: MMD structure
- The multi-modulus divider is a pulse-swallow divider (divide-by-4/5 prescaler from two 2/3 cells + program and swallow counters at ≤ 550 MHz) instead of a six-cell Vaucher chain with range extension: the chain mixed program bits of two ratios when the ratio changes every cycle and the chain length changes within the operating range. D16 (clocking from the LO chain's first stage) is unchanged. RTL `rtl/afe/mmd.sv`; every ratio 16–127 and 786 cycles with a new ratio each cycle pass.

## 2026-10-25 — P2.5 step 2c: Σ-Δ, lock detector, band calibration (RTL)
- Σ-Δ MASH 1-1-1 with dither, including the division of {N_INT, N_FRAC} by P (D16); bit-exact against the Python reference model.
- Lock detector with a sampling window of about 6.5 ns (covers the D18 locked UP pulse plus Σ-Δ wander).
- Band calibration counts the prescaler output (not the MMD output) for 128 reference cycles per step: 29 µs in total; with the 125 µs lock this is at the 150 µs wake budget (K = 64 is the reserve).

## 2026-10-25 — Repository contents
- All files needed to build the chip go on GitHub: schematics (xschem `.sch` with an SVG/PDF export each, from P2.7), netlists, simulation decks, run summaries (`out/summary_*.txt`), layouts (`.gds.gz`), DRC/LVS reports and rendered chip pictures (PNG/SVG from the GDS with KLayout). Regenerable bulk output (waveforms, raw data, build directories) stays out. A full-chip GDS too large for a normal commit goes to a GitHub Release.
- Chip art on the die: deferred until the owner has chosen the graphic (Phase 5).

## 2026-10-25 — P2.5 step 3: Monte Carlo, spurs, current
- Charge pump with full transistor mismatch (10 samples, tt 0.25 / 0.6 / 0.95 V and ss 0.6 V): INL ≤ 3.9 ps, lock point within ±0.09 ns, loop-gain spread ≤ 0.6 %.
- Boundary spur from the measured nonlinearity in a cycle-by-cycle PLL model with the real Σ-Δ sequence: ≤ −117 dBc VHF, ≤ −122 dBc UHF at RF against −95 dBc.
- PLL current ≈ 1.0 mA (0.43 mA schematic, rest estimated) of the 1.8 mA left in the LO budget.

## 2026-10-25 — P2.5 accepted; step 4
- P2.5 result review: accepted by the owner, with a step 4 before P2.6 for the blocks still ideal or missing: amplifier and I_cp bias generator, lock-detector window delay cell, V_tune hold switch.
- Found while designing the delay cell: the step-2c lock detector sampled DN only at the reference strobe and missed an early divider below ≈ 21 ns; now two-sided (DN sampled at divider + window, a second identical delay cell).
- Band calibration: first trial settles 64 reference cycles (hold switch), 30.5 µs in total; counting resolution corrected to 0.08–0.11 % at P = 3.

## 2026-10-25 — P2.5 step 4 results
- Bias generator (V_REF / R_B master current, I_cp DAC 25–200 µA, amplifier tails): I_cp within 2 % of V_REF / R_B over corners and ±10 % supply; start-up within 0.6 µs. First run's start-up circuit did not turn off (fixed).
- Window delay cell 5.5–10.0 ns over corners, MIM corners, R_B ±20 % and supply (allowed 5–12 ns).
- V_tune hold switch: time constant 0.4 µs, V_tune within 2.2 mV during the first count, leakage ≤ 8 nA at fast-hot; held voltage 0.50–0.64 V depending on corner.
- Pump linearity with the real bias as with ideal sources (INL ≤ 2.1 ps). P2.5 complete; next P2.6.

## 2026-10-25 — P2.6 step 1: D19, D20
Findings of the behavioural closed loop (`spec/pll-topology.md` §13): the P2.2 loop filter was sized with a 2π error (the built loop is about 42 kHz with 35° phase margin, not 150 kHz / 55°); a true 150 kHz loop fails the VHF phase noise at 600 kHz; with the 7-bit bank and the calibration as designed V_tune lands outside its window on 9–32 % of channels. Accepted by the owner as proposed:
- D19: loop filter, corrected design at 60 kHz, 55° actual (C1 30.8 pF, C2 465 pF, R1 22.9 kΩ, R3 108 kΩ, C3 3.1 pF; 499 pF). Model: VHF phase noise −137.0 dBc/Hz at 600 kHz with the planned VCO (−140 with the simulated one); wake 83–120 µs.
- D20: 8-bit capacitor bank, calibration counter on f_VCO / P, nearest-code rule (38.8 µs), V_tune window monitor. Model: V_tune lands in 0.34–0.82 V at all corners.
- The divider starts in phase with the reference when the hold is released (MMD `run`).

## 2026-10-25 — P2.6 step 2: noise from the circuits
- Charge-pump noise FoM −204 dBc/Hz (P2.2 assumed −218): half from the bias generator copied up by the I_cp DAC, half from the pump's sources. Accepted as it is (duplex-offset margin −0.8 dB, no in-band requirement); options recorded in `spec/pll-topology.md` §13.
- LO-chain floor by transient noise: VHF −154 dBc/Hz (P2.4 estimate −161); UHF does not converge, taken as about −150 dBc/Hz.
- Total phase noise at the duplex offset meets −136 dBc/Hz at all band edges; worst +2.8 dB at VHF 175 MHz.

## 2026-10-31 — P2.6 accepted

P2.6 (steps 1–4, `spec/pll-topology.md` §13; review `reports/phase2-review/p26-result-review.md`) accepted by the owner.

Before P2.7 layout:
1. Open point **2** first: start-up bypass on all VCO bias resistors, plus the wake sequence in the sequencer (`spec/analog-digital-interface.md` §6). One prompt-06 run.
2. Open point **1** next: V_tune window monitor comparators (D20). One prompt-06 run.
3. Open point **3** (UHF LO floor): one attempt with another method after (1) and (2). Does **not** block P2.7; must be closed or recorded as a known gap before the Phase 2 review gate.
4. Open point **4** (charge-pump in-band noise): no action unless an in-band requirement appears.

P2.7 may start with open IHP LVS issues #861, #753 and #512: document a workaround for each in the P2.7 notes and re-check when the PDK pin moves. Before the first P2.7 run, re-run the VACASK VCO, LO and PLL schematic results that prompt 01 only checked against their files (`reports/status-2026-10-30.md`).

## 2026-10-31 — Pre-P2.7 SCH re-run and open points 1–3

Open points 2, 1, then 3 closed (bypass; V_tune monitor option B 0.28/0.775 V; UHF LO floor **−150.1 dBc/Hz full chain** ÷2+Johnson at noisefmax 5 GHz — at the −150 limit, optimistic because noisefmax is only 5 GHz). VACASK SCH re-run (`reports/sch-rerun-2026-10-31.md`): VCO range, LO, PLL smoke, UHF floor pass. VCO PSS broken by off-state **bank** bypass MOS; bank-omitted PN (tt −122.7 / ss85 4.20 −119.4 dBc/Hz @ 1 MHz) accepted to start VCO layout. Linear off-state bank equivalent abandoned (PSS fails). Switch-noise bound vs bank bias R (`summary_bound_bank_switch.txt`): **closed 2026-11-01** under owner gate (positive margin everywhere; worst point ss85 4.20 moves < 0.5 dB). tt recorded as **+0.59 dB** worst-case bound (margin **+6.1 dB**); ss85 Δ = +0.006 dB, margin +3.4 dB. Draft VACASK issue (not posted): `reports/upstream-issues/vacask-pss-off-nmos-tank.md`. **P2.7:** layout may start; post-layout PN = bank-omitted PEX + this bound.

## 2026-11-01 — D21 VR_ANA1 filtered LO rail

Owner decision after the D10 LDO noise STOP (`analog/vco/ldo/out/summary_ldo_analyse.txt`, `summary_opt2_vrana1.txt`, `summary_d21_vrana1.txt`):

- **D21:** Pin 3 **VR_ANA1** is the filtered **VCO + LO + charge-pump** rail: one on-chip LDO → **R = 10 Ω** → pad → bond → board **100 nF**. VCO, LO dividers/buffer and charge pump are fed from the **pad** (chip side of the bond). **No Kelvin sense** — the LDO regulates its own output (before R). Set V_LDO so V_pad ≈ **1.2 V** at typical LO current (VHF 4.20 GHz ≈ 9.65 mA) → V_LDO ≈ **1.297 V** (IR ≈ 96.5 mV). **RX moves to VR_ANA2** (pin 25, with TX/DAC). Pins 12 and 14 stay n.c. (LinHT drop-in). **No option (1)** (no bare-LDO feedback-R cut).
- Supersedes the isolation reading of D10 only in so far as the VCO no longer has a private filtered node: the dedicated LDO remains, but its quiet node is the shared VR_ANA1 pad after R.
- Pad voltage [HAND]: UHF→VHF ΔV_pad ≈ **13.5 mV**; within VHF ≈ **1.5 mV**. Worst-case V_pad with ±5% LDO and ±20% R at I_max 10.3 mA ≈ **1.108 V** ≥ 1.08 V (PASS). Tighter ±5%/±30% still ≈ 1.098 V.
- Noise [SCH]: earlier S_v(pad) ≈ **9.5 nV/√Hz** was taken on an OP that **did not hold in transient** — mark that figure **UNVERIFIED**. After the compensation fix below, re-run: S_v(pad) @ 1 MHz, R=10 Ω, I=10 mA ≈ **3.0 nV/√Hz** (PASS vs ≤ 11); typ 9.65 mA ≈ **2.95 nV/√Hz**. `analog/vco/ldo/out/summary_ldo_verify.txt`.
- Stability [SCH]: open-loop DC polarity was already correct for the PMOS pass (mid↑→vg↑; VACASK W∠≈0° = NEG-FB in 1/(1+W)). Drift to Vin was **not** a second stable state — it was the Miller-to-mid compensation path. Fix: replace `cc(vg,mid)` with **Rz=500 Ω + Cg=100 pF to gnd**. Transient HOLD from OP; soft-start from 0 V and from Vin both settle ≈ 1.295 V. stb PM ≥ 60° with R=10/bond/100 nF (**64.4°**) and with C missing (**61.4°**). Load +1 mA and VBAT +0.3 V steps damped. Board 100 nF remains mandatory for the noise filter. **Cg area:** ≈ 0.0125 mm² MOS (8 fF/µm²) or ≈ 0.067 mm² MIM (1.5 fF/µm²) — prefer MOS; see `spec/p27-layout-notes.md`.

## 2026-11-02 — D22 VCO amplitude control

Accepted as proposed in `spec/vco-amplitude-cal.md` (option C), with two changes:

- **D22:** peak detector + comparator on the tank and a digital search over `VCO_BIAS`, run with the band calibration (**start-up bypass closed during the search**) and held during operation. Target **1.25 V ± 0.10 V** differential, hard limit **1.40 V**. Re-run with every band calibration (wake, band change, V_tune-monitor flag).
- `VCO_BIAS` DAC with an offset: **I_tail = 1.52 mA + code × 0.08 mA** (1.52–4.00 mA, 5 bits; D12 cap at code 31) instead of code/31 × 4 mA.
- Bottom bands: where 4 mA does not reach the target, the search ends at the top code and sets a **"target not reached"** flag; expected, not a fault (D12 unchanged).
- Interim until C is designed: option **A2** (per-band table, top bands derated for margin to 1.5 V).

## 2026-11-11 — D22 step 1c results

- Amplitude limit clarified: ≤ 1.40 V differential in steady state; ≤ 1.50 V for transients
  during the amplitude search (≈ 1 µs per step, calibration only). Step 1c peaks of
  1.402–1.448 V on four hot top-band cases accepted on that basis.
- VCO_BIAS DAC (V_DS-matched OTA, wide mirror) accepted: code 31 within ±3 % of 4.0 mA at all
  corners, INL ≤ 0.43 LSB, monotonic in MC; ss major-carry DNL 0.84 LSB noted.
- Bottom bands end at code 31 with tnr = 1 (0.85–1.09 V, above the LO minimum): expected.
- Detector phase noise: [HAND] ≈ 0 dB powered down; SCH check deferred to post-layout (PSS does
  not converge with the detector devices), like the bank-bypass bound.
- Interim A2 retired once the on-chip search runs on the single-ended comparator (step 1d).

## 2026-11-11 — P2.3 real LO load (open point 6) closed
- Accepted closed on: band shift ≤ 0.285 %, bottom margin 63.3 MHz (3.057 GHz), carries even,
  divider pull ≤ 55 ppm, kick-back ≤ −107 dBc, reverse isolation 67.8 dB [SCH]; ΔL(1 MHz)
  ≤ +0.14 dB buffer [SCH] + ≤ 0.3 dB dividers [HAND] ≤ 0.5 dB.
- PSS with the CML dividers attached does not converge in VACASK; confirmation by post-layout
  phase noise with the extracted load (P2.7), with the bank-switch and detector bounds.

## 2026-11-11 — HBT core comparison (D1): keep NMOS
- Owner confirms the NMOS core (D1 unchanged). HBT at 1.2 V / 4 mA: amplitude 0.99 V vs 1.16 V,
  L(1 MHz) ≈ equal by fair Leeson [HAND], band top 4.10 GHz misses 4.20 GHz [SCH]. The paper
  ≈ 5 dB gain needs ≈ 1.6 V swing and ≈ 1.8–2.5 V centre tap, which conflicts with D21 (1.2 V
  VR_ANA1) and exceeds BV_CEO margins [DS].
- VACASK VBIC PSS ≈ 35 dB optimistic against Leeson: not used for the decision. P2.3 open items
  closed; next is P2.7 layout.

## 2026-11-11 — D23 synthesizer floorplan
- D23: Option A of spec/p27-floorplan.md — tapped L2n0 in the NW corner next to pin 3
  (VR_ANA1, D21); VCO east of it; LO buffer and dividers south; PLL, loop filter and monitors
  NE; AFE digital SE. ≈ 0.50 mm² [HAND]. Chosen for the inductor-to-digital / charge-pump
  spacing (integer-boundary target ≤ −35 dBc VHF / −15 dBc UHF) and the short VR_ANA1 path.
- P2.7 sub-step order and pass numbers as in spec/p27-layout-notes.md.
- To add to the floorplan memo: a rough whole-die area tally (synthesizer, digital, RX, TX,
  LDOs, pads) against the package, so a squeeze shows before Phase 5.

## 2026-11-11 — P2.7.1 results
- xschem capture of VCO, D22 detector/comparator and D21 LDO accepted (3f116aa); LDO DC and
  D22 search reproduce from the xschem netlist.
- VCO range from the current deck misses range.json (25 Oct) — also with plain run_step2, so
  it is a deck change since then, not the xschem capture. Before P2.7.2: find the cause,
  re-baseline range.json from the current circuit, and re-run the 15-corner range and the
  band steps. Layout only if 3.12–4.20 GHz is still covered at every corner.
- Die size: the whole-die tally (spec/p27-floorplan.md §8) needs ≈ 3.5 mm²; a 1.6 × 1.6 mm
  core does not fit, ≈ 2.5 × 2.5 mm does and fits the QFN-32 5 × 5 mm package. Die outline
  decided in Phase 5 with refined RX/TX areas; P2.7 block layout proceeds.

## 2026-11-11 — P2.7.1b results; bank bypass sizing
- Cause of the VCO range shift: off-state capacitance of the start-up bypass switches on the
  bank plates (−14.5 MHz at code 0) and varactor bias (−3.4 MHz); PDK pinned a49358cc.
  range.json re-baselined (old kept as range_2026-10-25.json); 15 corners cover 3.12–4.20 GHz
  (top margin 39 MHz, bottom 186 MHz).
- Band steps fail with equal-size bank bypass switches (127→128: 1.06 V of V_tune). Fix: bank
  bypass switches sized in proportion to their bit (minimum width for the small bits), wake
  charging still ≥ 6–7 τ within 1 µs; then re-trim. D20 window unchanged.
- Amplitude +0.06 V against the archive noted; D22 sets the amplitude in operation.

## 2026-11-11 — P2.7.1c results
- Bank bypass switches binary-sized (W = max(0.15 µm, 5 µm × 2^(k−7))), re-trimmed: tt carries
  0.97–1.02×, steps ≤ 0.296 V of V_tune — accepted (inside D20's 0.23–0.30 V). 15 corners cover
  3.12–4.20 GHz (top margin 140 MHz, bottom 77 MHz), peak V_GS / V_GD ≤ 1.48 V.
- ss 85 °C carry 127→128 ratio 1.52: accepted only if the D20 landing with corner-specific steps
  keeps V_tune inside the window (checked at the start of P2.7.2).
- Amplitude +0.06 V against the archive: not from the bypass; D22 sets the amplitude. Open note.

## 2026-11-11 — P2.7.2 gate finding (no layout)
- Gate [SCH]+[MODEL] (`analog/vco/step3/out/summary_p272_gate.txt`): ss85 127→128 ratio 1.52,
  ΔV 0.542 V; ff−40 127→128 ratio 0.56, ΔV 0.117 V.
- D20 nearest landing with corner banks/holds: tt PASS (0.333–0.919 V); ss FAIL
  (0.206–0.860 vs 0.25–0.85); ff FAIL (0.456–0.962 vs 0.25–0.95). Layout blocked.
- Owner decision open: re-trim at ss85, amend D20 window/hold, or exclude edge channels.

## 2026-11-12 — D24 segmented capacitor bank
- P2.7.2 gate failed (analog/vco/step3/out/summary_p272_gate.txt): the 127→128 carry is
  corner-dependent (ratio 1.52 at ss 85 °C, 0.56 at ff −40 °C), so the D20 landing leaves the
  window at ss (0.206–0.860 V) and ff (up to 0.962 V). A trim at one corner cannot fix both.
- D24: the 8-bit bank becomes segmented — the 3 MSBs as 7 identical thermometer unit cells
  (32 LSB each) plus 5 binary LSB cells — with a 3→7 decoder in the AFE digital. 8-bit code,
  VCO_BAND register and D20 unchanged. Supersedes the "binary" in D8 for the MSBs.
- The D18 offset current is switched off during the V_tune hold, so the hold voltage sits
  closer to mid-window.
- The P2.7.2 gate (all carries at ss 85 °C / ff −40 °C, D20 landing inside the window at every
  corner) must pass before layout.

## 2026-11-12 — P2.7.2b gate finding (D24 implemented; no layout)
- D24 bank + offset-off hold implemented. Holds [SCH]: tt 0.577 / ss 0.512 / ff 0.649 V.
- tt steps: max 0.298 V PASS; 95→96 ratio 0.90 sole miss vs 0.94–1.07.
- Landing [MODEL] (`summary_p272b_gate.txt`): tt PASS (0.355–0.942 V); **ss FAIL**
  (max 0.882 vs 0.85); **ff FAIL** (max 0.997 vs 0.95). ss85 127→128 now ratio 1.01.
- Owner decision open: widen ss/ff high window slightly, host-exclude edge channels, or
  further bank/hold work. Layout still blocked.

## 2026-11-12 — P2.7.2b results; gate corners after D21
- D24 works: ss 85 °C 127→128 ratio 1.01 (was 1.52); RTL decoder and offset-off-in-hold pass.
- Remaining gate misses are high-side only (ss −32 mV, ff −47 mV). The gate corners still use
  1.08 / 1.32 V supplies; since D21 the VCO, LO and charge pump are on VR_ANA1 (≈ 1.2 V at the
  pad, worst ≥ 1.108 V, high end from the LDO tolerance). The gate is re-run with VR_ANA1
  corners: window edges (pump compliance) and hold voltages at those supplies.
- If it still fails: (a) a fixed signed bias on the calibration target to centre the landing
  in the window (varactor curvature), (b) a longer count (K = 512) for the final nearest-code
  decision only, wake ≤ 150 µs. No window widening, no channel exclusion.

## 2026-11-12 — P2.7.2c gate PASS (VR_ANA1 pad supplies)
- Pad corners [HAND]: ss 1.108 / tt 1.200 / ff 1.295 V (`summary_vrana1_pad_corners.txt`).
- Compliance 10 % [SCH]: tt 0.265–1.150, ss 0.202–1.050, ff 0.341–1.250 V.
- Holds offset-off [SCH]: tt 0.577 / ss 0.524 / ff 0.636 V.
- D20 landing [MODEL]: PASS all corners (tt 0.361–0.936, ss 0.244–0.897, ff 0.457–0.970 V).
  No cal-target bias, no K=512. Layout unblocked → P2.7.2 VCO layout.

## 2026-11-12 — P2.7.2c results; VR_ANA1 corners
- Gate re-run on VR_ANA1 pad supplies (ss 1.108 / tt 1.200 / ff 1.295 V): landing tt 0.361–0.936,
  ss 0.244–0.897, ff 0.457–0.970 V; 15 corners cover; D22 search passes. No target bias, no K=512.
- Window definition for the landing gate: the charge pump at the locked V_tune must keep
  INL ≤ 30 ps (boundary spur ≥ 10 dB inside −95 dBc), I_cp within 10 %, and the D18 lock point
  on the UP side — not only a 10 % current drop. Checked at the landing extremes before layout.
- Recorded results on 1.08 / 1.32 V for VR_ANA1 blocks stay valid as conservative bounds (the
  pad range lies inside); re-run with pad corners only post-layout.

## 2026-11-12 — P2.7.2 pump-linearity finding (no layout)
- Landing-extreme lin gate (`summary_p272_lin.txt`): INL / ΔI_cp / UP lock PASS everywhere.
- **FAIL:** ss 1.108 V / 85 °C / V_tune 0.897 V — VHF boundary spur **−102.9 dBc** [MODEL]
  vs ≤ −105 dBc (still 7.9 dB inside −95). Layout not started.
- Owner decision open: accept the −102.9 figure, improve the pump at ss high V_tune, or
  pull the ss landing high extreme down before layout.

## 2026-11-12 — P2.7.2 pump-linearity gate
- Accepted: boundary spur −102.9 dBc (VHF) at ss 1.108 V / 85 °C, V_tune 0.897 V (landing top
  extreme), INL 18.1 ps [SCH/MODEL] — 7.9 dB inside the −95 dBc limit. The 30 ps / −105 dBc gate
  was a margin target. All other cases ≤ −117.9 dBc; INL ≤ 3.1 ps; ΔI_cp ≤ 8.1 %; lock point UP.
- Re-check post-layout with pump mismatch at that point (target ≤ −100 dBc).
- VCO layout (P2.7.2) may start.

## 2026-11-12 — P2.7.2 layout finding
- Placement-only layout (d4284fc) not accepted for PEX: no partial tank PEX; P2.7.3 needs a
  routed, DRC- and LVS-clean VCO.
- DRC: metal-density violations waived at block level (fill at chip level, Phase 5). TV2.a on
  the EM inductor is not waived: replace with PDK-legal via arrays and confirm L / Q change
  < 1 % by EM. Cnt.b / M1.b / M5.b are fixed in the routed respin.
- P2.7.2 is split into smaller runs: (a) LVS flow (netgen IHP setup, full vco_top.sch hierarchy)
  proven on small cells, inductor via fix, area breakdown; (b) routed sub-blocks one per run
  (core + tank, D24 bank, tail / DAC / OTA, varactor, D22 detector), each DRC / LVS clean;
  (c) VCO top assembly, DRC / LVS clean.
- VCO island 0.4457 mm² against the D23 budget 0.15–0.20 mm²: (a) gives an area breakdown and a
  plan to meet the budget, or a finding for D23 and the die-size tally.

## 2026-11-12 — P2.7.2a result
- D23 amended: VCO island budget raised from 0.15–0.20 mm² to ≤ 0.30 mm² (P2.7.2a compact
  estimate 0.22–0.28 mm²). The tank / inductor is not redesigned. Die-size tally
  (spec/p27-floorplan.md §8) is updated to match and must still fit the die.
- Inductor via fix: ΔL ≤ 0.02 % accepted. The Q change (−3.3 to −3.8 %, one EM run) is not yet
  accepted: confirm with a second EM run and try wider via arrays. Accept if the remaining
  Q loss is < 2 %, or, if it is larger, if the bottom-band swing (ff, MIM worst, 85 °C) stays
  ≥ 0.54 V differential and the worst-corner VCO phase-noise margin stays positive, both with
  the new Q.
- LVS flow accepted for MOS cells (dac_unit). bank_unit (MIM + switch + resistors + bypass) and
  dac_unit DRC must be clean before P2.7.2b; use PDK pcells and via generators, not hand
  via stacks.

## 2026-11-12 — P2.7.2a2 result
- Area: VCO island ≤ 0.30 mm² and die re-total ≈ 3.6–3.7 mm² on ≈ 2.5 × 2.5 mm accepted.
- Order kept: bank_unit DRC / LVS clean and the inductor Q gate (2026-11-12 "P2.7.2a result")
  come before P2.7.2b. Finished in P2.7.2a3.
- If the finer-mesh EM does not finish within the run, the Q gate is decided by the swing /
  phase-noise check using the worst recorded Q loss (−3.8 %).

## 2026-11-12 — P2.7.2a3 result, inductor Q gate
- LVS flow proven on dac_unit and bank_unit (DRC clean, KLayout LVS and netgen topology clean).
  netgen property warnings (AS / AD / ng) are resolved or explained before sign-off; W / L / ng
  must be compared, not only topology.
- Inductor via fix accepted: ΔQ −3.5 to −3.6 % [EM, mesh1], ΔL negligible, |V_CT / V_diff| pass.
  Bottom-band swing at ff / MIM worst / 85 °C / 4 mA = 0.6435 V ≥ 0.54 V [SCH]. VCO phase-noise
  margin ≈ +3.3 dB [HAND, Leeson from ΔQ]; schematic PSS did not converge.
- The simulated phase-noise confirmation with the new Q moves to P2.7.3 (post-layout VCO PN).
  Wider via arrays are not pursued.
- Next: P2.7.2b, first routed sub-block (core + tank).

## 2026-11-12 — P2.7.2b core + tank, first attempt
- Not accepted: DRC (M1.b, M2.b, V1.a) and LVS fail; tn and tp are shorted, so the pair
  extracts as one W = 64 device. The D24 bank sub-block waits.
- Re-spin core + tank built bottom-up: the cross-coupled pair with dummies as its own cell,
  LVS clean first, then the inductor, tank capacitance and guard ring added one at a time
  with LVS after each.
- Area 0.107 mm² and the tank RC (C_add ≈ 15–25 fF / side, Rs ≈ 0.2 Ω [HAND]) accepted as
  reported.
- Metal current limits: take them from the IHP SG13G2 process specification if it gives
  them; otherwise [HAND] with the source stated.

## 2026-11-12 — P2.7.2b core + tank, re-spin
- Pair cell and stage a (L2n0 + centre tap) accepted: DRC, KLayout LVS and netgen clean.
- Stage b (fixed tank capacitance) and later not accepted: MINUS merged with TIE / gnd, right
  PLUS open, rhigh tied to gnd at both ends. Re-spin stage b, then c / d, before the D24 bank.
- MIM type follows the schematic: keep rfcmim if the design needs it; otherwise schematic and
  layout move to cmim (as in bank_unit), with a check that tank frequency and swing do not
  change.
- Inductor in LVS: use the PDK inductor recognition if the deck has it; otherwise pin-only, plus
  a scripted check that fab GDS and LVS GDS differ only in the inductor's own shapes.
- Current density [HAND]: 5 mA/µm on TM1 (no table found in the process specification); tank
  1.0 mA/µm, centre tap 0.50 mA/µm at 4 mA accepted.
- ng not extracted: accepted when total W matches and the finger count is checked in the
  layout.

## 2026-11-12 — P2.7.2b core + tank accepted
- Core + tank accepted: stages a–d DRC clean (density waived), KLayout LVS and netgen clean;
  pair 2 × W = 32; area 0.1102 mm² [GDS]; fab / LVS GDS differ only in l2n0_em [TOOL].
- Fixed tank capacitance stays rfcmim (its M1 shield is TIE; fx routed on M2, M1 drops only
  outside the shield).
- Open for P2.7.2c: the centre tap is not checked by LVS today (pin-only inductor, ct not
  extracted). The top assembly must make ct a labelled, LVS-checked pin.
- Next: P2.7.2b, D24 bank sub-block.

## 2026-11-12 — P2.7.2b D24 bank
- Bank connectivity, centroid order [0,1,2,D,3,4,5,6] and binary row accepted: DRC clean,
  KLayout LVS and netgen clean (property noise as core + tank). Decoder stays in AFE RTL.
- Before the next sub-block, a short bank fix run:
  - finger count: schematic and layout must agree (ng ≤ 100 per device, or the switch split),
    then re-check band range at the worst corner;
  - dummy cell in the empty centroid slot, tied to gnd and in the schematic;
  - area forecast for the remaining VCO sub-blocks against ≤ 0.30 mm² (core + tank + bank =
    0.2611 mm²): denser bank packing, or a D23 finding.
- P2.7.3 gate: extracted thermometer / binary boundary step ≤ ½ LSB from ideal and monotonic
  codes (today 0.69 LSB step [SCH / HAND]).

## 2026-11-12 — P2.7.2b bank fix
- Bank fix accepted: ng = 100 in schematic and layout; band range at least-margin corners
  pass (top +130 MHz, bottom +76 MHz [SCH]); centroid dummy tied to gnd; DRC, KLayout LVS and
  netgen clean; bank 0.1514 mm² [GDS].
- Island forecast ≈ 0.29 mm² of ≤ 0.30 mm² accepted, subject to the D9 50 pF filter capacitor
  being counted at its real type and area (checked first in the tail / DAC / OTA run).
- Full 15-corner band-coverage re-run moves to P2.7.3.

## 2026-11-12 — P2.7.2b D9 finding (tail blocked; no layout)
- D9 `cbf` is still an ideal 50 pF in `vco_tail_dac.sch`. As MIM (1.5 fF/µm² [PDK]): rfcmim
  bbox 0.03757 mm² [TOOL] → island ≈ 0.316 mm² > D23 ≤ 0.30 — does not fit.
- Thin-ox `moscap_n` 5×30/30 µm fits area (C≈53 pF @ 0.6 V; island ≈ 0.279 [HAND]) but fails
  the noise gate: VCO ΔL = **+0.516 dB @ 100 kHz**, +0.080 dB @ 1 MHz vs ideal [SCH]
  (pass was < 0.2 dB). Amp also fell 1.20 → 0.93 V. Schematic not changed; tail layout not
  started. Summary: `analog/vco/layout/p272b_tail/out/summary_d9_finding.txt`.
- Owner must choose before the next sub-block: (A) raise D23 VCO island to ≤ 0.34 mm² and
  keep MIM `cbf` (die §8 → ≈ 3.64–3.74 mm², still fits 2.5×2.5); (B) keep ≤ 0.30 and accept
  MOS with a relaxed 100 kHz gate; (C) smaller `cbf` / higher pole; (D) place the 50 pF MIM
  outside the VCO island.
