Supermagnum/SDR-repeater/analog/vco/layout/out/L_2n0_tapped.png

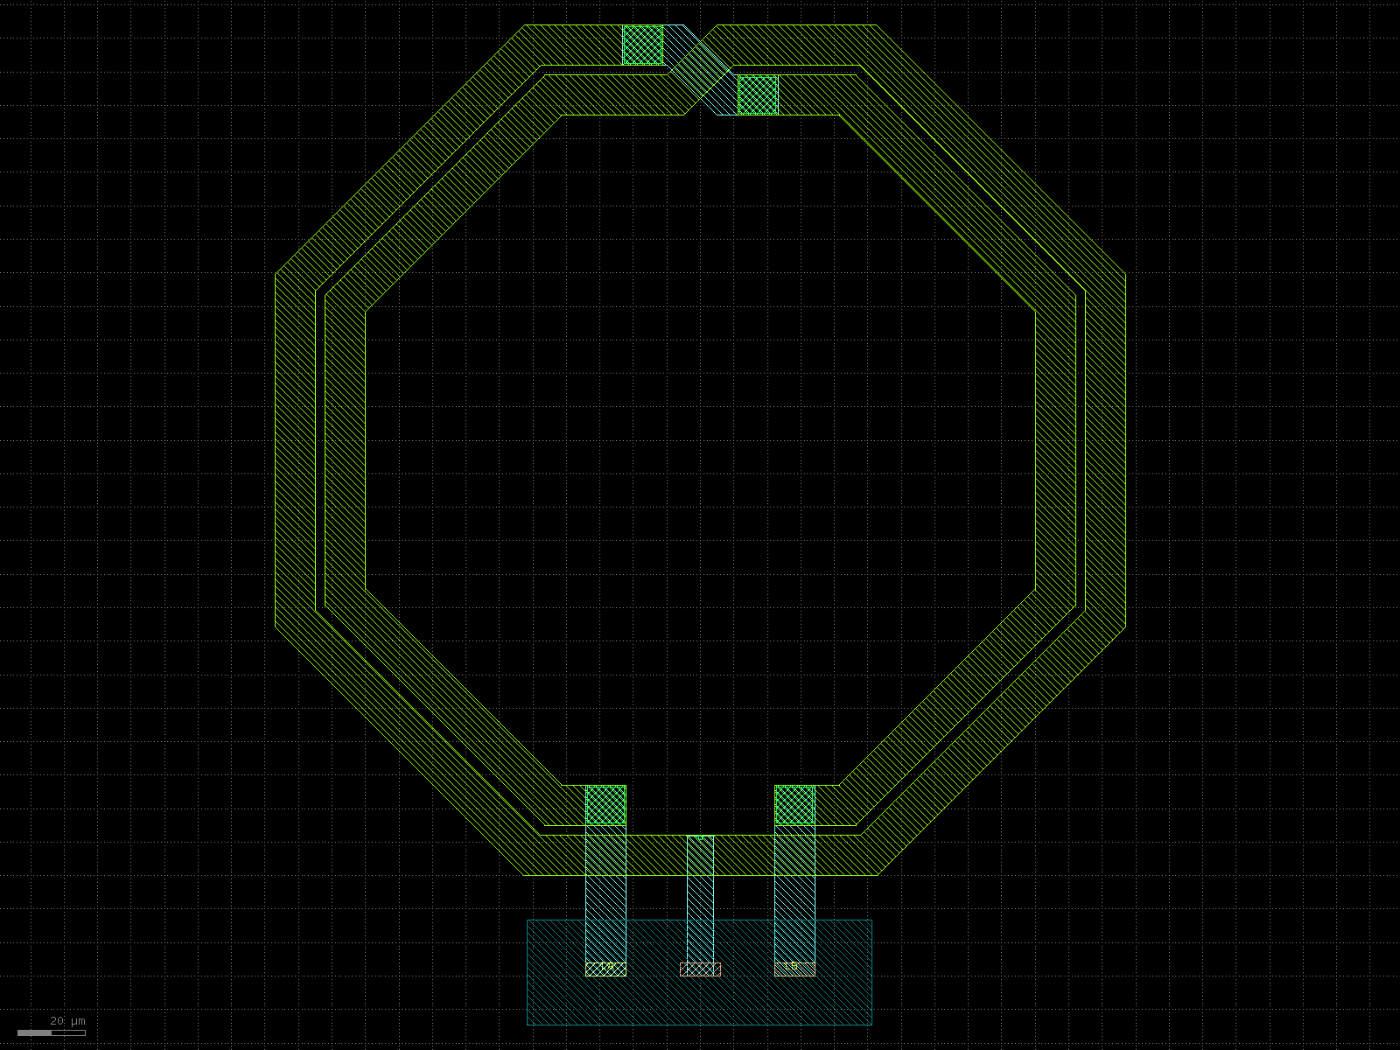
analog/vco/layout/out/L_2n0_tapped.png
