Supermagnum/SDR-repeater/analog/vco/layout/out/vco_bank.png

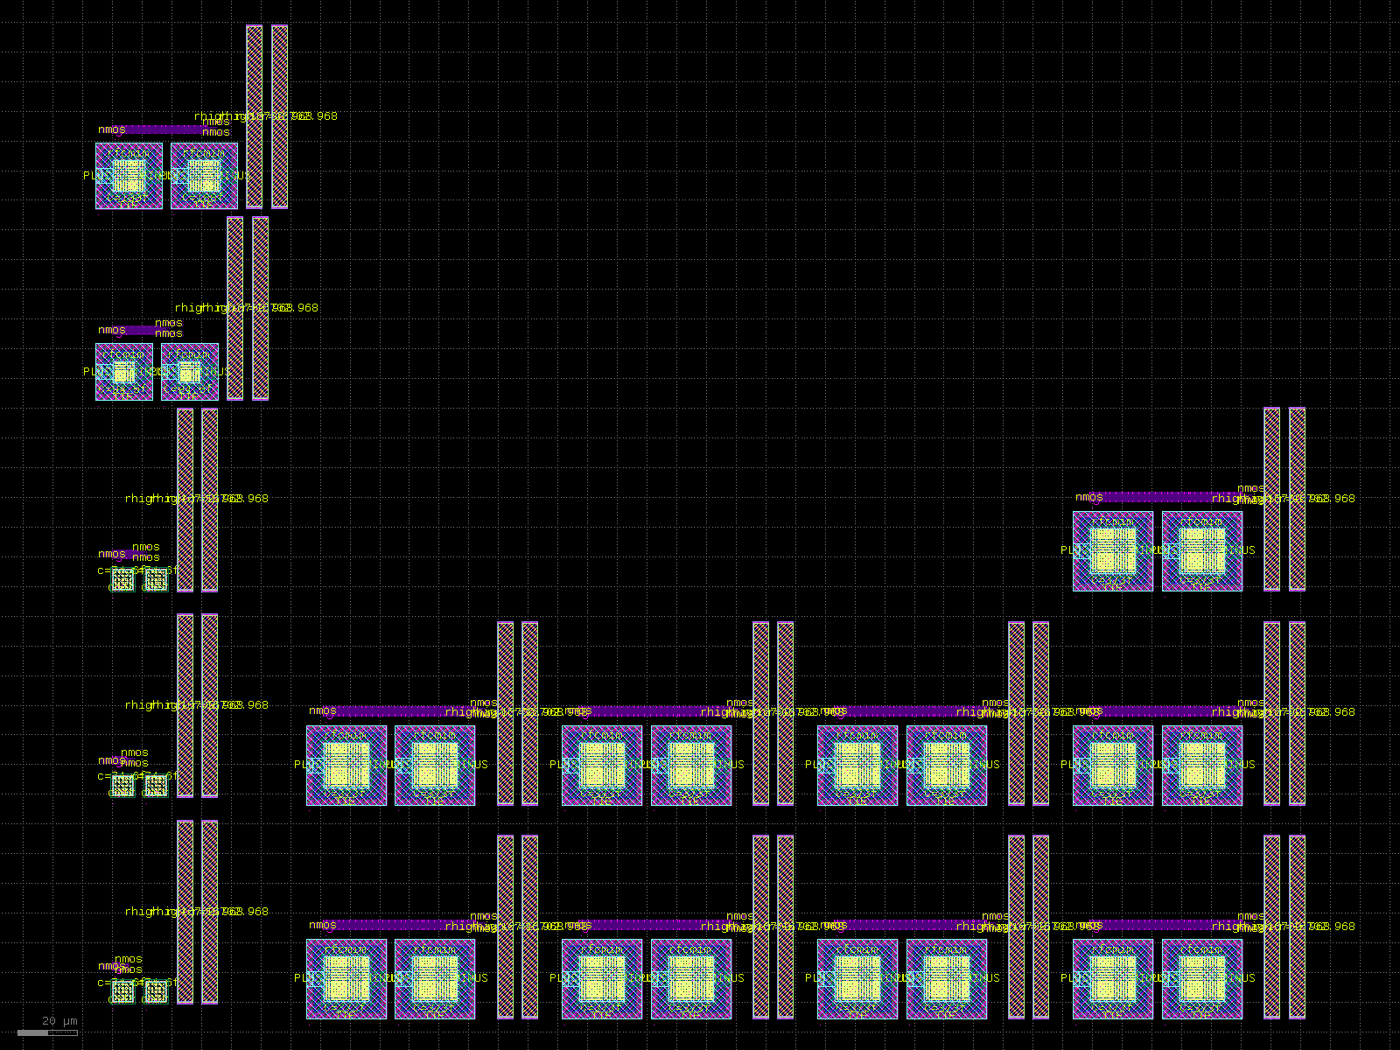
analog/vco/layout/out/vco_bank.png
