Supermagnum/SDR-repeater/analog/vco/layout/out/vco_core.png

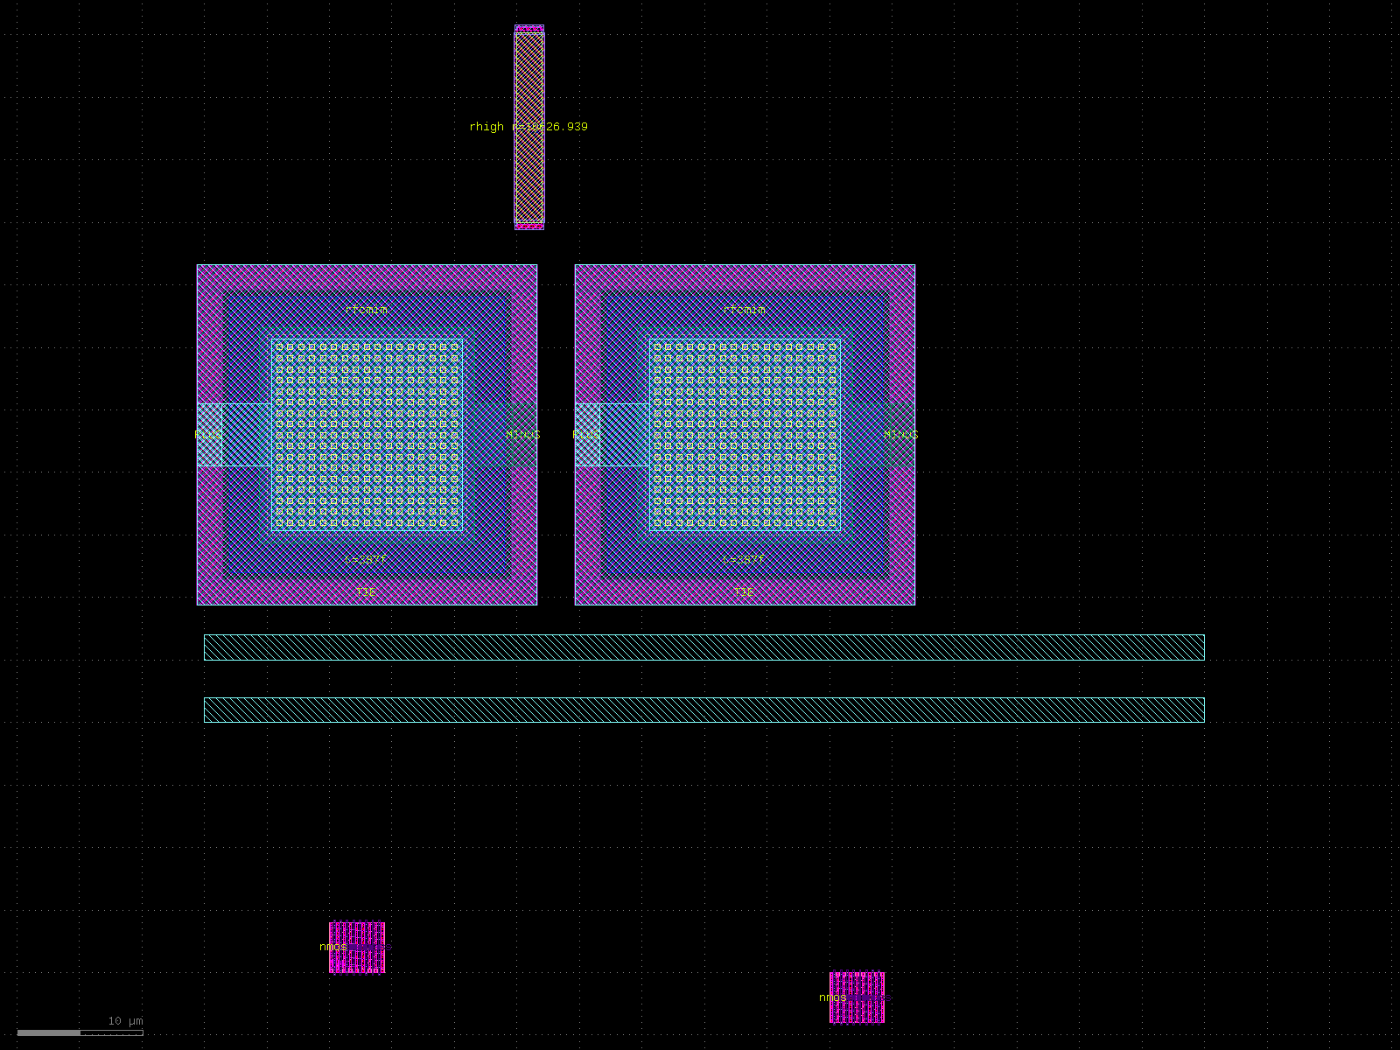
analog/vco/layout/out/vco_core.png
