Supermagnum/SDR-repeater/analog/vco/layout/out/vco_top.png

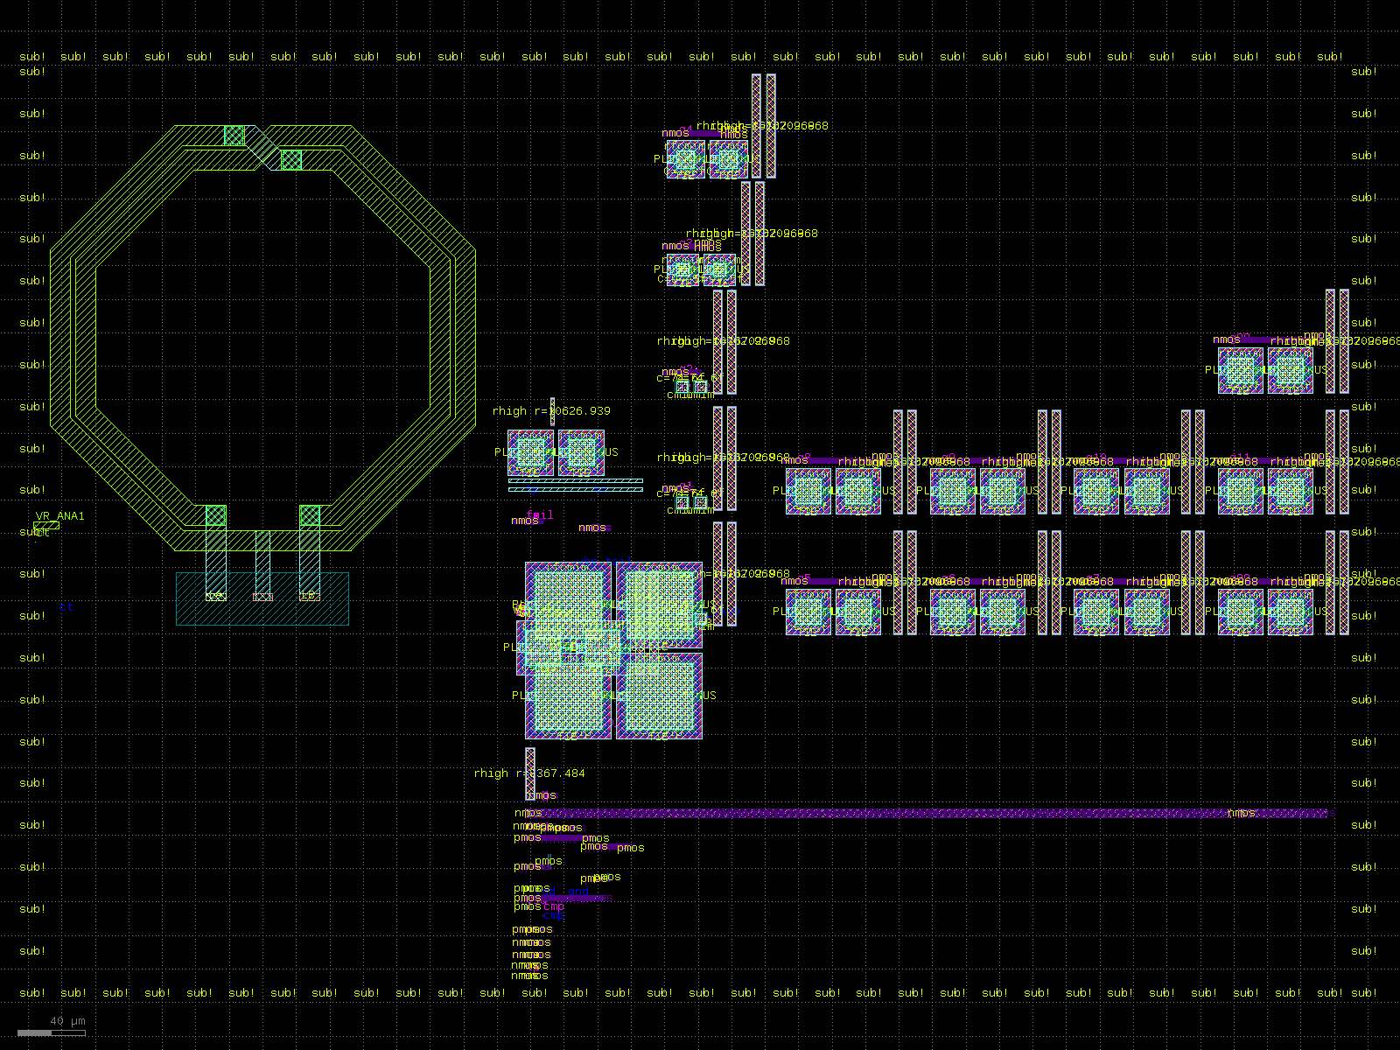
analog/vco/layout/out/vco_top.png
