Supermagnum/SDR-repeater/analog/vco/layout/p272b/out/vco_core_tank.png

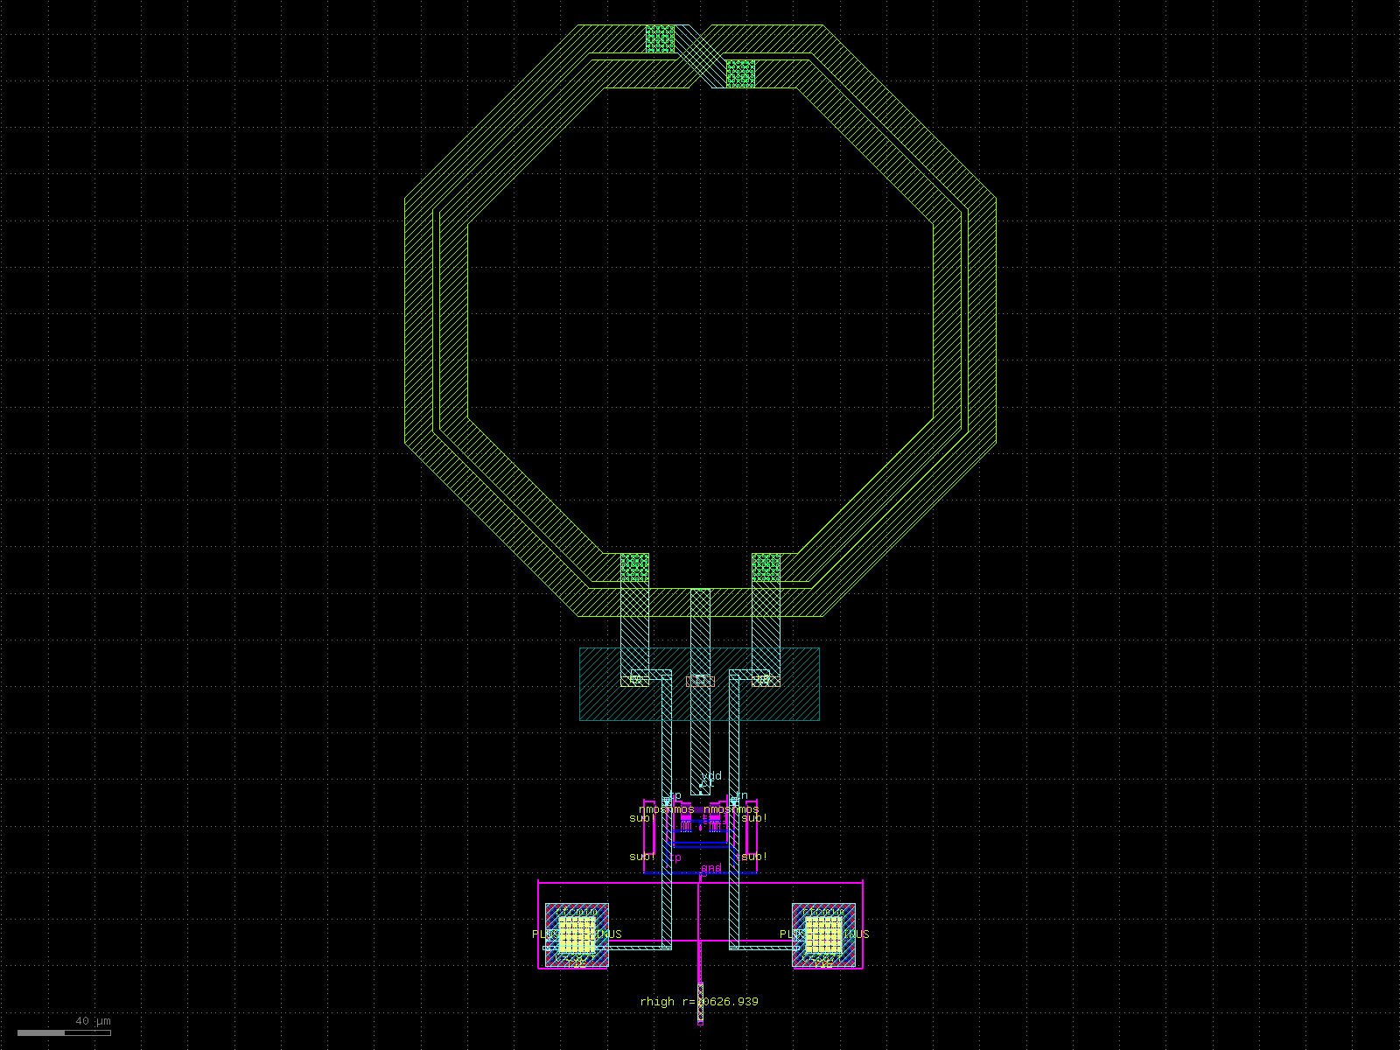
analog/vco/layout/p272b/out/vco_core_tank.png
