Supermagnum/SDR-repeater/analog/vco/layout/p272b/out/vco_xc_pair.png

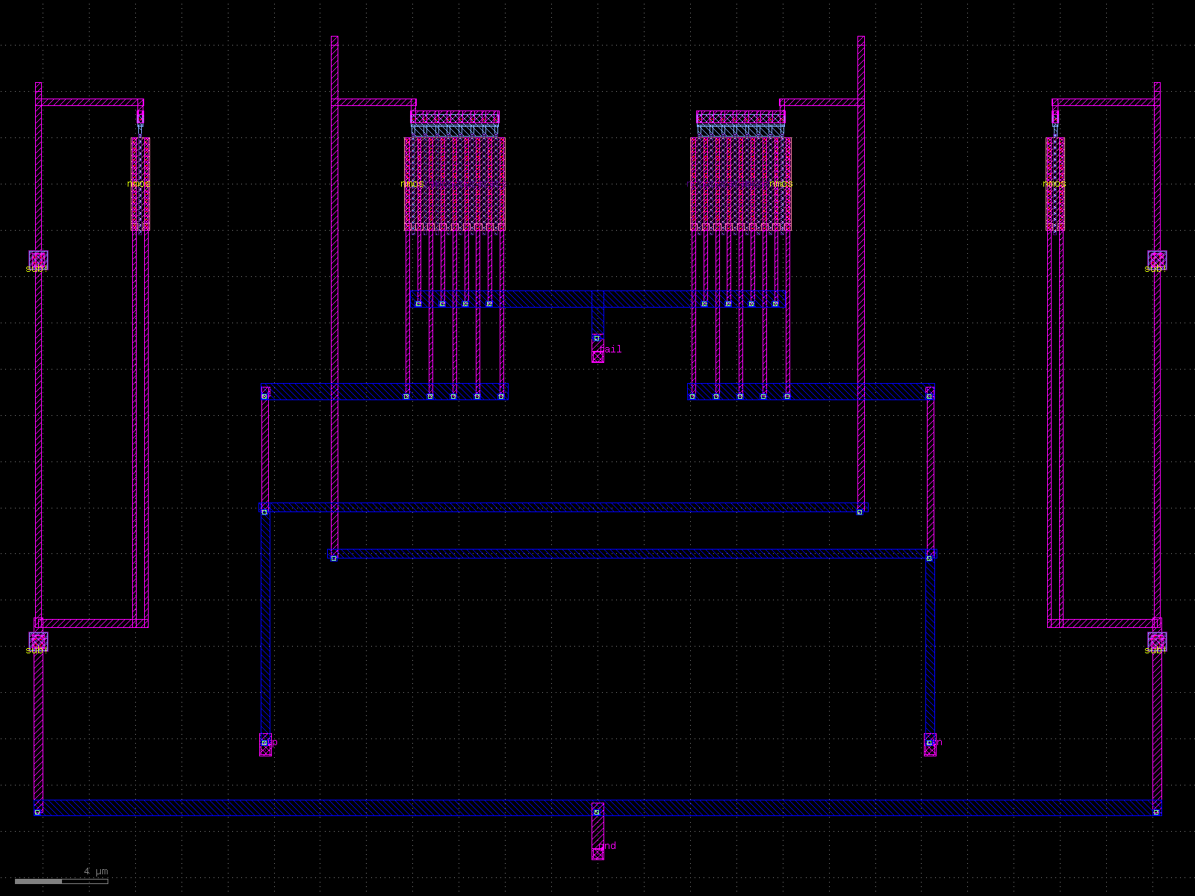
analog/vco/layout/p272b/out/vco_xc_pair.png
