Supermagnum/SDR-repeater/analog/vco/layout/p272b_bank/out/bank_cell_u0.png

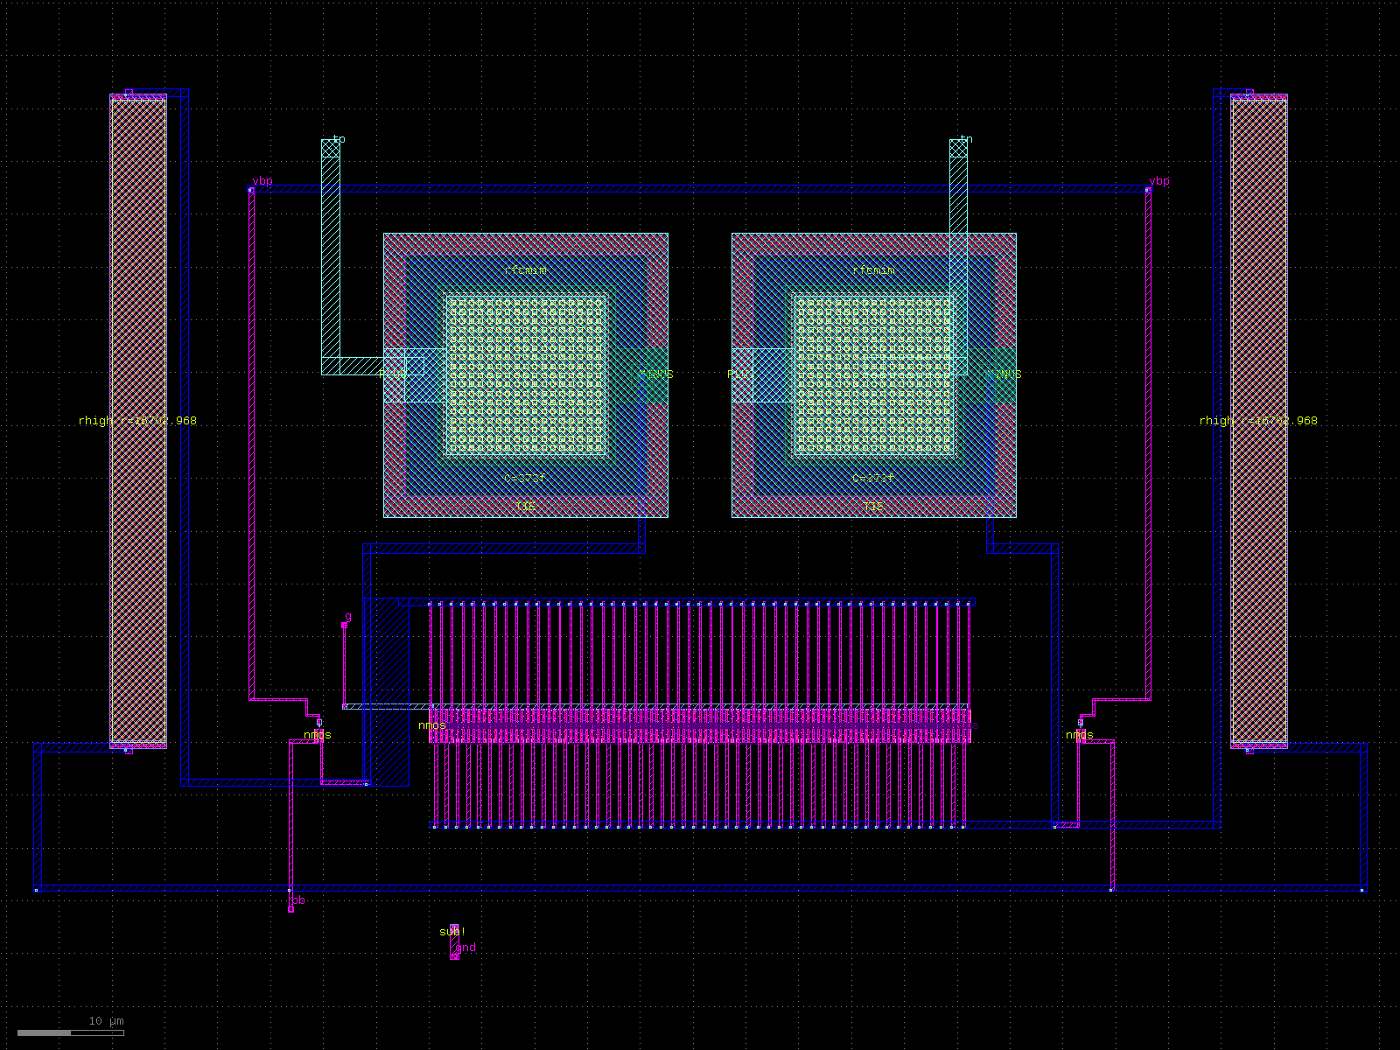
analog/vco/layout/p272b_bank/out/bank_cell_u0.png
