Supermagnum/SDR-repeater/analog/vco/layout/p272b_bank/out/vco_bank.png

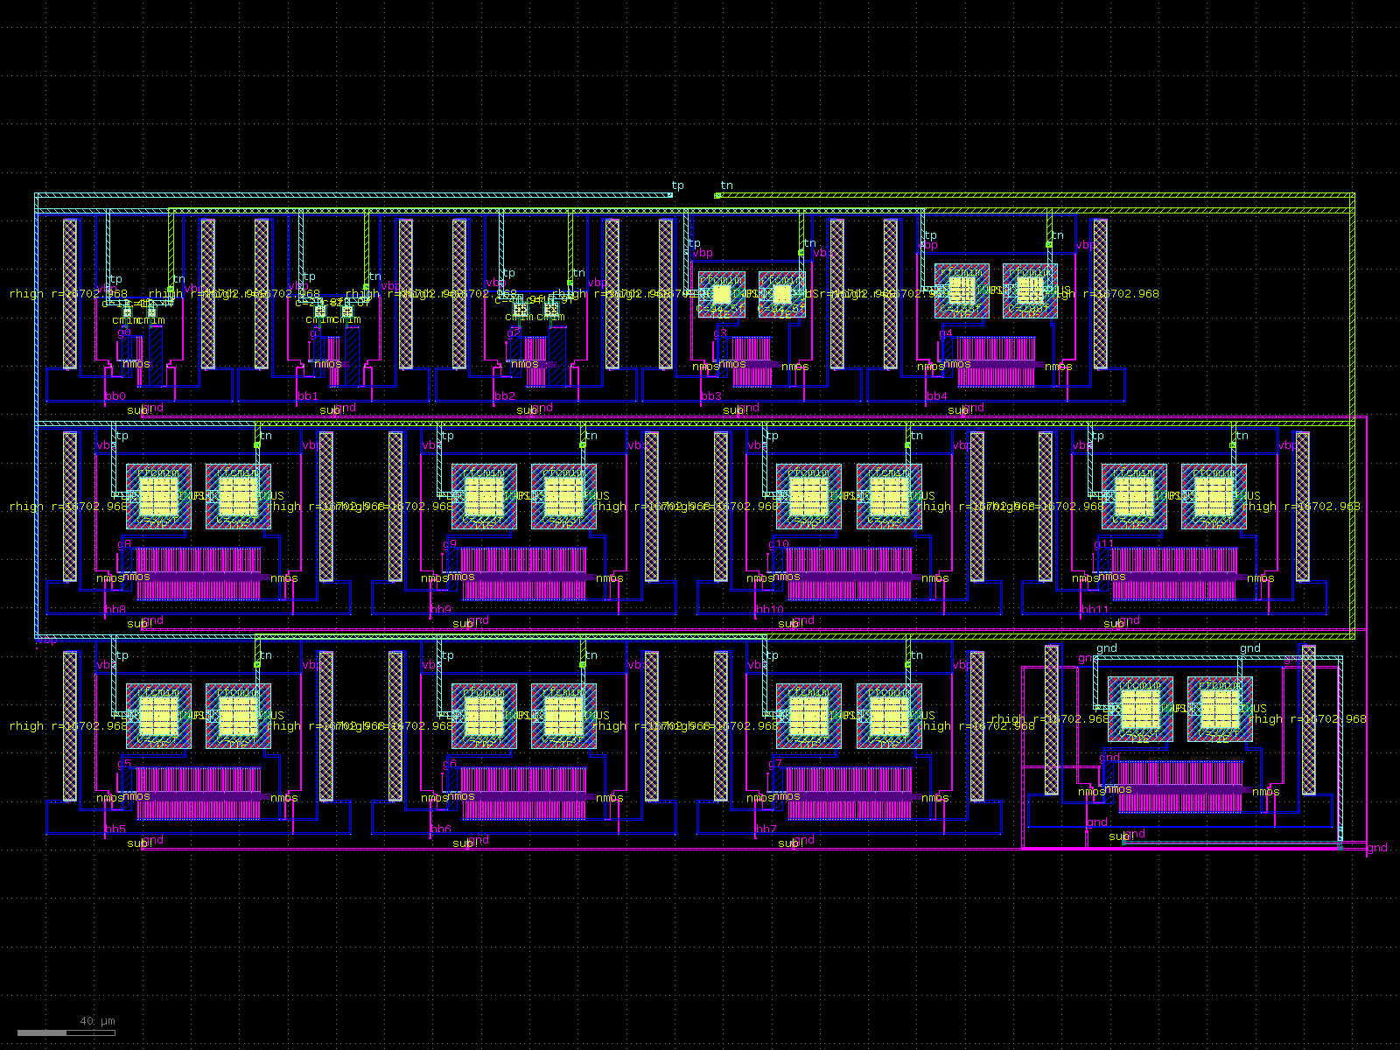
analog/vco/layout/p272b_bank/out/vco_bank.png
