Supermagnum/SDR-repeater/sim/em/sg13-octagon-l2n0/tapped/review/L_2n0_tapped_review.png

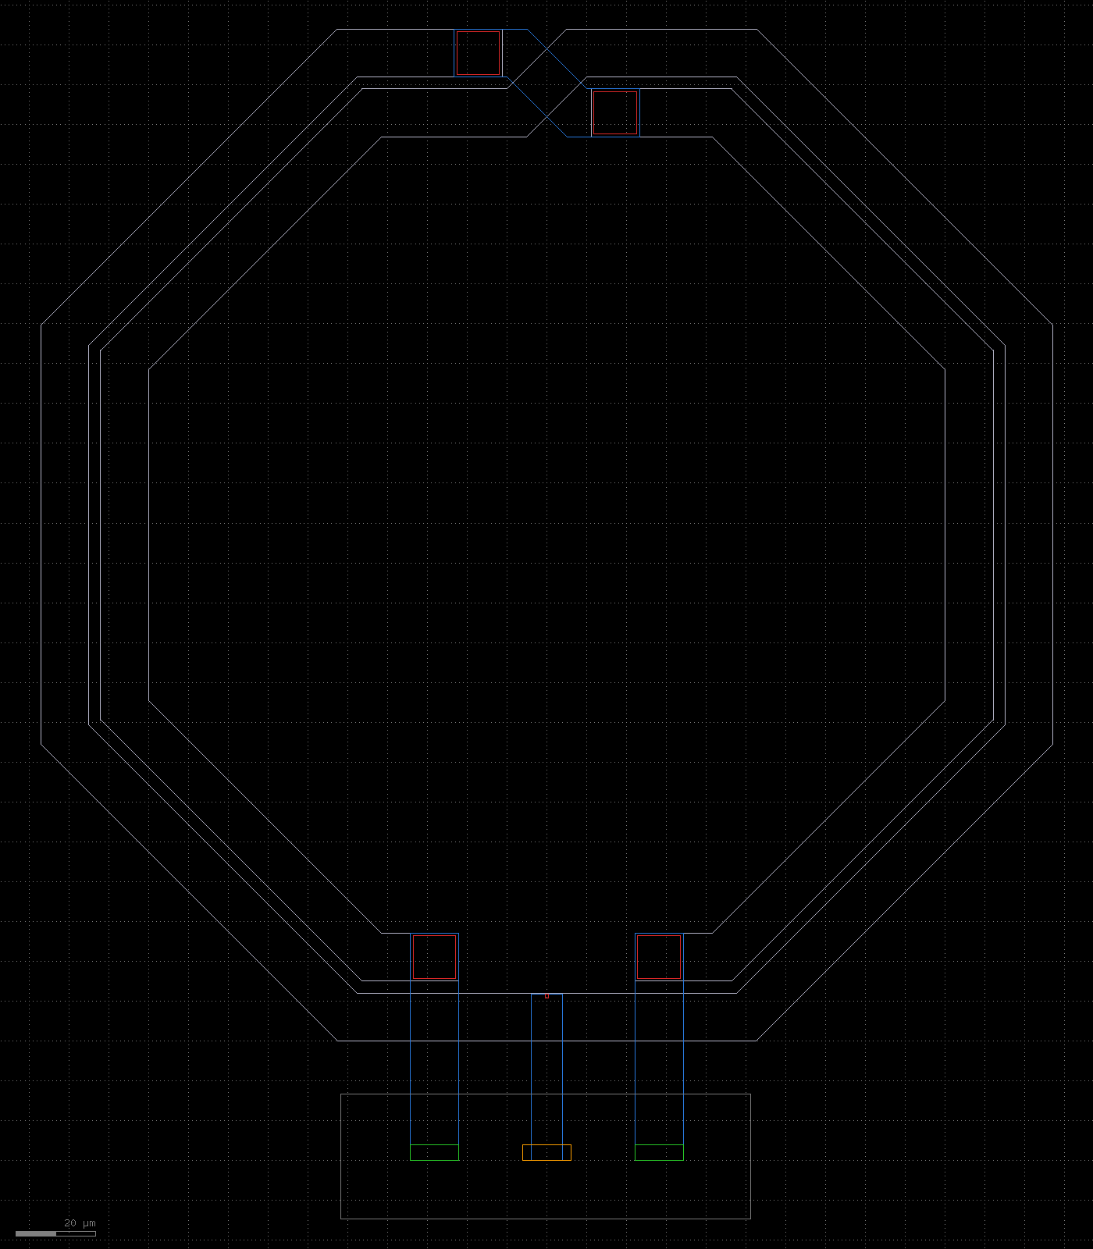
sim/em/sg13-octagon-l2n0/tapped/review/L_2n0_tapped_review.png
