Supermagnum/SDR-repeater/sim/em/sg13-octagon-l2n0/tapped/review/L_2n0_tapped_via_zoom.png

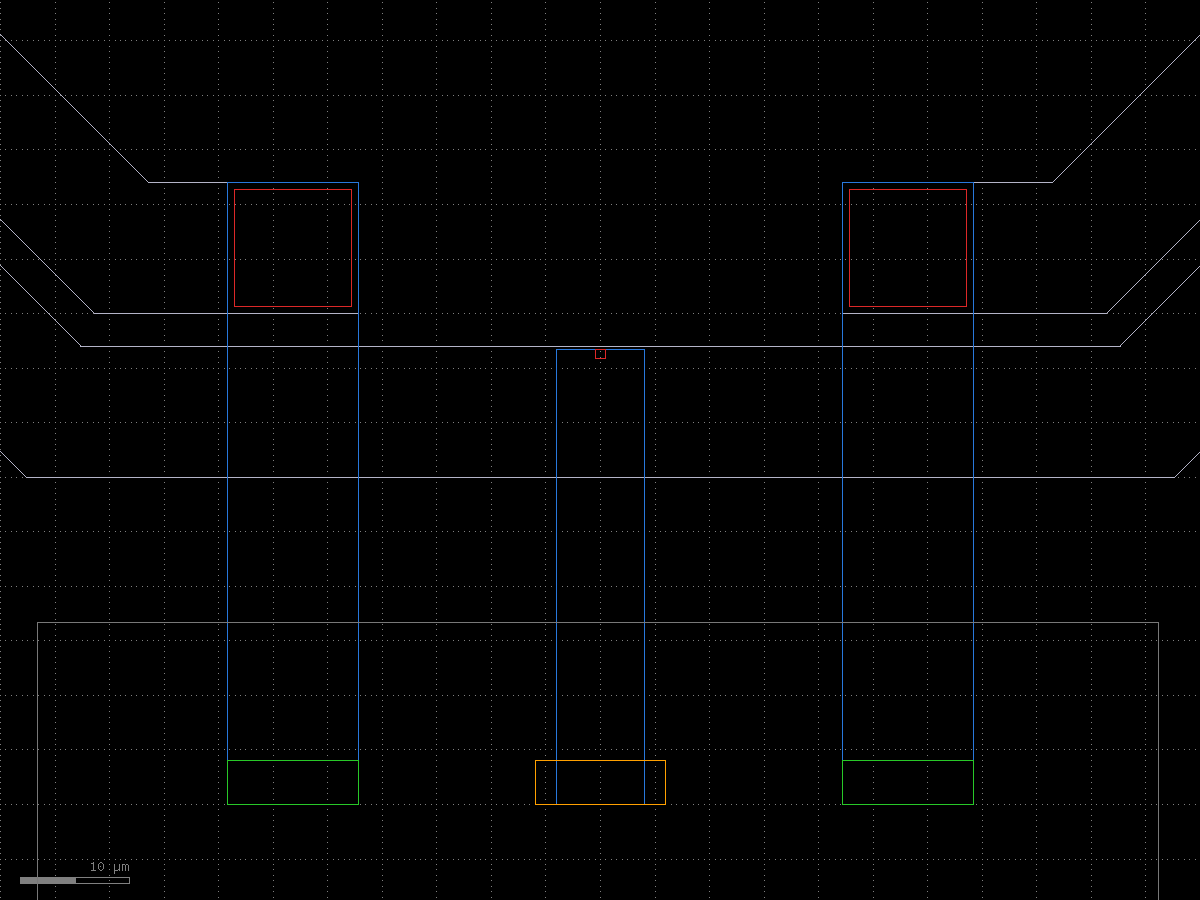
sim/em/sg13-octagon-l2n0/tapped/review/L_2n0_tapped_via_zoom.png
