Supermagnum/SDR-repeater/PCB/footprints-symbols/92_N-50-0-6_111_NY.step

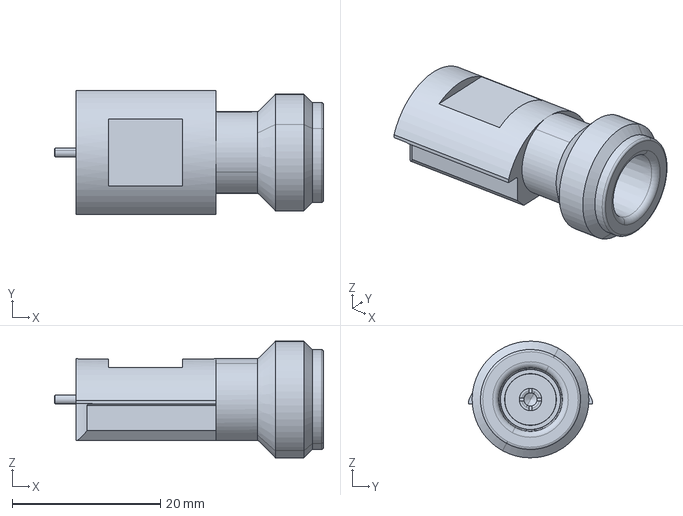
[picture p16: CAD file, 2026-10-25]
PCB/footprints-symbols/92_N-50-0-6_111_NY.step
36.3 x 16.7 x 15.7 mm
