Supermagnum/SDR-repeater/PCB/footprints-symbols/MLPQW-32_SEM.stl

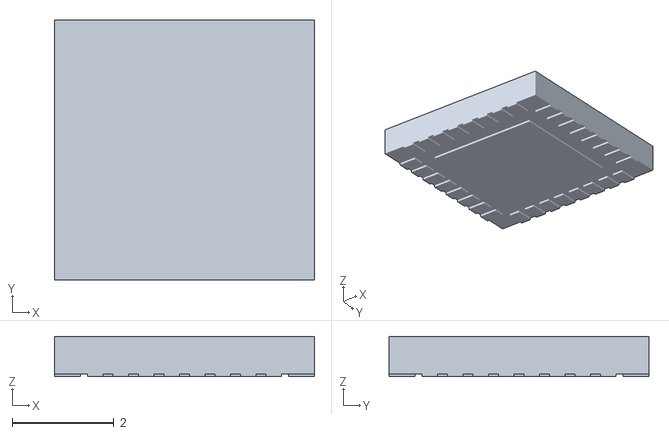
[picture p17: CAD file, 2026-10-25]
PCB/footprints-symbols/MLPQW-32_SEM.stl
5.11 x 5.11 x 0.79
