Supermagnum/SDR-repeater/PCB/footprints-symbols/86093968114755V1LF.step

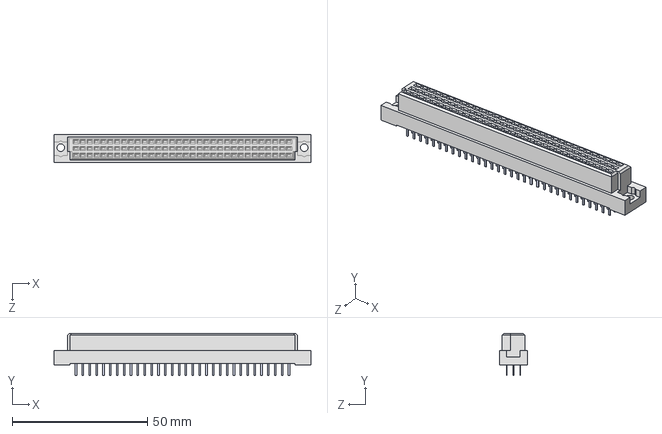
[picture p18: CAD file, 2026-10-25]
PCB/footprints-symbols/86093968114755V1LF.step
95.0 x 15.6 x 10.5 mm
