Supermagnum/SDR-repeater/PCB/footprints-symbols/86093967113755ELF.step

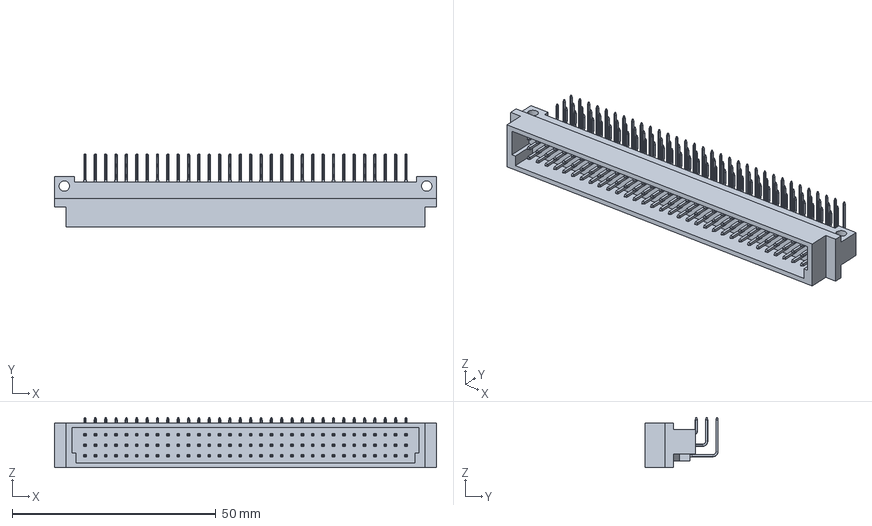
[picture p19: CAD file, 2026-10-25]
PCB/footprints-symbols/86093967113755ELF.step
93.7 x 18.0 x 12.4 mm
