Supermagnum/SDR-repeater/analog/pll/step2/README.md

# P2.5 step 2 — PLL schematics

Step 2 has three parts (`spec/pll-topology.md` §7): (a) PFD and charge pump, (b) the multi-modulus divider, (c) Σ-Δ, lock detector and calibration as RTL.

## Part a: PFD and charge pump (`run_step2.py`)

Transistor-level PFD (static master-slave flip-flops with asynchronous reset, reset delay NAND + 5 inverters) and charge pump (long-channel sources, current steering into a dummy node held at V_tune, replica branch with a Miller-compensated amplifier that matches up and down at V_tune). The amplifier and the dummy-node follower are behavioural for now. The output is held at V_tune by an ideal source; its averaged current gives the net charge per reference cycle against the REF–DIV phase offset.

```bash
cd /foss/designs/analog/pll/step2
mkdir -p out && python3 -u run_step2.py | tee out/summary_a.txt     # 3 corners x 3 V_tune x 9 offsets (81 runs)
python3 -u run_step2.py tt                                          # one corner first, as a trial
python3 -u run_step2.py icp=200                                     # other pump current (µA, default 100)
```

| Result | Pass |
|---|---|
| Q / I_cp against dt | linear, slope (pump gain) 1 ± 5 % over 0.25–0.95 V |
| Offset at dt = 0 | small (residual mismatch × reset pulse); ≪ the D18 offset current's effect |
| Dead zone | ±3 ps still gives the right sign |
| Reset pulse | 100–300 ps at every corner (both switches fully on) |
| Replica error | vr within a few mV of V_tune |

First run (typical, 2026-10-21): no dead zone (±3 ps resolved), but **offset +131 / +143 ps at dt = 0** (V_tune 0.6 / 0.95 V), gain 1.14–1.16, reset pulse 606–643 ps (too long), replica 16–20 mV off; at 0.25 V the replica loop ran to the rail (+937 mV) and the result is void. Causes and second-run fixes:
- the output switch and the dummy switch of each pair were driven one inverter delay apart, so the source floated on every UP edge and dumped its charge into the output → each pair now driven by an inverter and a matched always-on transmission gate (complementary, equal delay);
- the behavioural transconductor could drive the PMOS gate outside the supply → clamped 60 dB voltage amplifier;
- reset delay chain shortened (NAND + 3 inverters, no load capacitors).

Second run (typical): stalled — one simulation over 10 minutes. With 60 dB and 0.5 pF the ideal replica loop crossed over near 400 GHz and forced tiny time steps. Third run: amplifier 30 V/V, 20 pF on the replica node (loop crossover about 300 MHz, DC loop gain still about 8000).

Third run (typical): no dead zone, but gain 0.70 / 0.81 / 0.38 and offsets −368 / −303 / +183 ps at V_tune 0.25 / 0.6 / 0.95 V; the up current in particular is far too small and non-monotonic at 0.95 V; reset pulse UP 380 / DN 450 ps; replica 15–75 mV off. Fourth run: a DC check with UP / DN forced (`dc`), which prints the output current, the main and replica source currents (zero-volt probes), the PMOS gate and the replica node — to find which branch is wrong; UP and DN now buffered before the switch drivers (equal loads on the PFD outputs).

```bash
python3 -u run_step2.py dc tt | tee out/summary_dc_tt.txt     # 12 operating points, seconds
python3 -u run_step2.py tt | tee out/summary_a_tt4.txt
```

Fourth run, DC check (typical): **the static pump is correct** — up and down match within 0.1 % at all three V_tune, main = replica, currents 98–111 µA (+13 % slope over the window), replica node within 4 mV. So the transient errors are dynamic. Fifth run: the transient also prints min / mean / max of pg, vr, nb, pz, nz and the four source currents at dt = 0, to see which node moves.

Fifth run (typical): **the replica loop oscillates** — pg swings 0.2–1.19 V every cycle, replica and main up currents peak at 7–9 mA, the main up source node pz goes from −0.7 to +1.6 V; gain 0.36–0.55, offsets −275 … +307 ps. The PFD is now balanced (reset pulse 285 / 285 ps). Cause: the ideal fast amplifier. Sixth run: two-stage Miller compensation (transconductor 10 µS with gain 100 and clamped output, 2 pF from pg to vr; crossover ≈ 0.8 MHz, second pole ≈ 7 MHz).

Sixth run (typical): **the replica loop is stable** (pg steady within 1 mV, replica within 2 mV of V_tune), no dead zone, PFD balanced (285 / 285 ps). Remaining: offset at dt = 0 of −20 / +22 / +54 ps (V_tune 0.25 / 0.6 / 0.95 V) and an up-side slope about 15 % above the DC up current (down side matches its DC current). Both matter only if the pump works on both sides of zero; with the D18 offset current it works on the UP side only. Seventh run: all three corners as before, and `lin` — the pump with the 8 % offset current (an NMOS sink mirrored from the pump bias) over dt = 1.0–3.5 ns around its locked point, giving the lock point and the INL:

```bash
python3 -u run_step2.py ss ff | tee out/summary_a_ssff.txt    # 54 runs
python3 -u run_step2.py lin | tee out/summary_lin.txt          # 3 corners x 3 V_tune x 6 offsets (54 runs)
```

Seventh run:
- **Slow and fast corners (no offset current): pass** — no dead zone, replica loop steady (pg within 2 mV; replica 1–2 mV off V_tune, ff 0.6 V +20 mV), offsets −50 … +75 ps, gains 1.10–1.27, reset pulse 451 ps (ss) / 188 ps (ff).
- **Linearity with the offset current: INL ≤ 0.6 ps** (≤ 0.03 % of the ±1 ns range) at tt, ff and ss 0.6 V — the pump is linear on the UP side. But the lock point came out at 0.75–1.05 ns instead of 2.2 ns: the 0.08-sized sink gave about 3.5 µA, not 8 µA. And two slow-corner cases (0.25 and partly 0.95 V) had DN stuck high for the whole run — the PFD's static latches started from an undefined operating point.

Eighth run: power-on reset for the PFD (rst forced for the first 1.5 ns), offset sink sized 0.2 with a current probe (reported), offsets up to 5 ns:

```bash
python3 -u run_step2.py lin | tee out/summary_lin2.txt      # 3 corners x 3 V_tune x 8 offsets (72 runs)
```

Eighth run: **all corners pass** — INL ≤ 1.0 ps over dt 1–5 ns, lock point 2.9–4.0 ns, offset current 10–16 µA; the power-on reset removed the stuck-PFD cases. Summary in `spec/pll-topology.md` §8. Next: transistor-level replica amplifier and dummy-node follower.

Ninth run: **transistor-level amplifiers** (default; option `ideal` keeps the behavioural ones):
- replica amplifier and dummy-node buffer are rail-to-rail-input transconductors (NMOS pair with PMOS mirror and PMOS pair with NMOS mirror on one output; covers 0.25–0.95 V on 1.08–1.32 V); replica: 2 µA tails, Miller 5 pF; buffer: unity gain, 10 µA tails, 10 pF on the dummy node;
- with the offset current, the dummy node receives −I_off on average when locked; a matching PMOS source from pg into the dummy node cancels it, so the buffer only handles the difference;
- bias currents of the two amplifiers are still ideal references (the bias generator is its own block).

```bash
python3 -u run_step2.py dc tt | tee out/summary9_dc.txt       # static check, seconds
python3 -u run_step2.py tt | tee out/summary9_tt.txt          # 27 runs
python3 -u run_step2.py lin | tee out/summary9_lin.txt        # 72 runs, all corners
```

Ninth run (transistor amplifiers): typical without offset current fine at 0.25 / 0.6 V (offset −9 / +24 ps, replica within 6 mV), but **at 0.95 V the replica sat 147 mV low**; with the offset current the **INL grew to 20–95 ps** (slopes 0.80–1.09). Causes: the simple transconductor took its output from the input-pair drains, so with the output near 0.49 V and the input near 0.95 V the NMOS pair had no drain voltage left; and the dummy buffer (10 µA) could not hold the dummy node. Tenth run: symmetric transconductors (each pair's currents mirrored to the output, so the output range is independent of the input common mode), the dummy buffer with mirror gain 3 (about 30 µA), and the dummy-node voltage printed in the linearity table. The DC check's single-state rows (UP only, DN only) put the full 100 µA on the dummy node permanently, which no small buffer holds — only its "both" and "none" rows and the replica columns are meaningful there.

```bash
python3 -u run_step2.py dc tt | tee out/summary10_dc.txt
python3 -u run_step2.py lin | tee out/summary10_lin.txt
```

Tenth run: **replica fixed** (within 4 mV at 0.25–0.95 V); **INL ≤ 1.8 ps in 7 of 9 cases** (tt / ss / ff at 0.25 and 0.6 V, ff 0.95 V), but 47 ps (tt 0.95 V) and 16 ps (ss 0.95 V). The dummy node sits 20–118 mV above V_tune in all cases (118 mV at tt 0.95 V, i.e. at 1.07 V, where the PMOS source runs short of drain voltage while steered to the dummy). The average current into the dummy node is only a few µA, so this is not overload. Eleventh run: a DC check of the buffer alone (`buf`: both switches to the dummy, with and without the offset pair; dummy voltage, buffer current, offset currents):

```bash
python3 -u run_step2.py buf | tee out/summary11_buf.txt     # 24 operating points, seconds
```

Eleventh run (`buf`): **found it** — the buffer itself is fine (dummy within 1–38 mV of V_tune and almost no output current without the offset pair), but the offset source into the dummy node gives 26–44 µA instead of about 13 µA, so the buffer has to sink 30–40 µA, saturates, and the dummy node rises 60–150 mV. The offset sink gave 10–16 µA instead of about 20 µA. Mirrors between devices of very different width (480 µm vs 58 µm, 60 µm vs 12 µm, each one gate finger) did not keep their ratio. Twelfth run: every mirror device built from gate fingers of one width per type (NMOS 1.5 µm, PMOS 6 µm), ratios as finger counts; both offset devices 10 % of their main source.

```bash
python3 -u run_step2.py buf | tee out/summary12_buf.txt
python3 -u run_step2.py lin | tee out/summary12_lin.txt
```
