Supermagnum/SDR-repeater/analog/pll/p26/step4/README.md

# P2.6 step 4 — spurs with the final loop

`python3 spurs.py | tee out/summary.txt` (numpy, scipy; runs anywhere). Reference spur from the D18 offset current and
leakage through the D19 filter; fractional boundary spur from the pump nonlinearity (step-3 model); integer-boundary
spur budget for layout. Results in `spec/pll-topology.md` §13.
