Supermagnum/SDR-repeater/analog/pll/step4/out/summary_p272_lin.txt

# P2.7.2 — pump linearity at landing extremes (VR_ANA1) [SCH]+[MODEL]

Q(dt) 1–5 ns, offset on, bias generator, I_cp 100 µA. ΔI_cp = (slope / slope_mid − 1). Spur from pll_behav (D19 60 kHz loop) [MODEL].

Pass: INL ≤ 30 ps; |ΔI_cp| ≤ 10 %; lock > 0 (UP side); spur ≤ −105 dBc at RF.

| Corner | V_DD | T | V_tune | INL (ps) | Lock (ns) | Slope | ΔI_cp (%) | Spur VHF/UHF (dBc) | PASS |
|---|---|---|---|---|---|---|---|---|---|
| ss | 1.108 | 85 | 0.244 | 1.3 | 2.71 | 0.926 | -8.1 | -122.2/-125.9 | PASS |
| ss | 1.108 | 85 | 0.897 | 18.1 | 3.10 | 0.944 | -6.3 | -102.9/-126.8 | FAIL spur -102.9/-126.8 |
| ss | 1.108 | 85 | 0.524 mid | 0.4 | 2.73 | 1.008 | +0.0 | -124.7/-126.0 | ref |
| tt | 1.200 | 27 | 0.361 | 0.1 | 2.75 | 0.988 | -6.0 | -125.8/-126.0 | PASS |
| tt | 1.200 | 27 | 0.936 | 1.0 | 3.03 | 1.034 | -1.7 | -127.3/-125.9 | PASS |
| tt | 1.200 | 27 | 0.577 mid | 0.2 | 2.75 | 1.051 | +0.0 | -125.3/-126.0 | ref |
| ff | 1.295 | -40 | 0.457 | 0.1 | 2.77 | 1.041 | -5.2 | -126.5/-126.0 | PASS |
| ff | 1.295 | -40 | 0.970 | 3.1 | 2.98 | 1.115 | +1.6 | -117.9/-125.9 | PASS |
| ff | 1.295 | -40 | 0.636 mid | 0.3 | 2.77 | 1.098 | +0.0 | -125.2/-126.0 | ref |

## Verdict

FAIL — finding; no layout.

- ss @ 0.897 V: INL=18.1 ps, ΔI_cp=-6.3 %, lock=3.10 ns, spur=-102.9/-126.8 dBc

## Finding (P2.7.2 / no layout)

Only failure: **ss 1.108 V / 85 °C / V_tune 0.897 V** (ss landing high extreme).

| Check | Result | Limit | Tag |
|---|---|---|---|
| INL | 18.1 ps | ≤ 30 ps | [SCH] PASS |
| ΔI_cp vs mid | −6.3 % | ≤ 10 % | [SCH] PASS |
| Lock point | 3.10 ns (UP) | > 0 | [SCH] PASS |
| Boundary spur VHF | **−102.9 dBc** | ≤ −105 dBc | [MODEL] **FAIL** (−2.1 dB) |
| Boundary spur UHF | −126.8 dBc | ≤ −105 dBc | [MODEL] PASS |

Against the absolute −95 dBc duplex limit the VHF spur still has **7.9 dB** margin; it misses the owner gate (−105 = 10 dB inside −95) by 2.1 dB. All other landing extremes (ss low, tt both, ff both) PASS. Layout blocked.
