Supermagnum/SDR-repeater/analog/vco/step2/out/summary_range_d24.txt

## Sizing (bank scale and fixed capacitor, two passes)

pass 1: LSB 3.75 fF, fixed 0 fF -> code 0 5.885 GHz (430 fF), code 255 3.725 GHz (1074 fF), switched 643 fF
pass 2: LSB 5.85 fF, fixed 182 fF -> code 0 4.438 GHz (757 fF), code 255 2.899 GHz (1773 fF), switched 1017 fF
result: LSB 5.77 fF (on-state), fixed 193 fF differential, varactor 20 fingers

## Bank trim (d24, equal steps at the carries)

pass 1: bin1: carry 11.22 / LSB 10.44 MHz -> trim 1.0000 -> 0.9655; bin2: carry 12.60 / LSB 10.24 MHz -> trim 1.0000 -> 0.9468; bin3: carry 15.22 / LSB 10.00 MHz -> trim 1.0000 -> 0.9394; bin4: carry 20.04 / LSB 9.49 MHz -> trim 1.0000 -> 0.9352; unit: carry 27.89 / LSB 8.68 MHz -> trim 1.0000 -> 0.9343

pass 2: bin1: carry 11.03 / LSB 10.95 MHz -> trim 0.9655 -> 0.9622; bin2: carry 10.79 / LSB 10.83 MHz -> trim 0.9468 -> 0.9475; bin3: carry 10.61 / LSB 10.52 MHz -> trim 0.9394 -> 0.9384; bin4: carry 10.07 / LSB 9.97 MHz -> trim 0.9352 -> 0.9347; unit: carry 9.43 / LSB 9.06 MHz -> trim 0.9343 -> 0.9332

## Sizing (bank scale and fixed capacitor, two passes)

pass 1: LSB 5.77 fF, fixed 193 fF -> code 0 4.504 GHz (734 fF), code 255 2.988 GHz (1669 fF), switched 934 fF
result: LSB 6.19 fF (on-state), fixed 192 fF differential, varactor 20 fingers

## Bank trim (d24, equal steps at the carries)

pass 1: bin1: carry 11.21 / LSB 11.17 MHz -> trim 0.9622 -> 0.9607; bin2: carry 11.02 / LSB 11.07 MHz -> trim 0.9475 -> 0.9487; bin3: carry 10.63 / LSB 10.69 MHz -> trim 0.9384 -> 0.9390; bin4: carry 9.81 / LSB 10.16 MHz -> trim 0.9347 -> 0.9368; unit: carry 8.66 / LSB 9.12 MHz -> trim 0.9332 -> 0.9347

## Tuning range and swing (noiseless transient, 60 ns, last 20 ns measured)

I_tail 3.5 mA, VDD_VCO 1.1 V. Peak V_GS / V_GD of the core against 1.5 V.

| Code | V_tune | f (GHz) | Diff. amplitude (V) | Peak V_GS | Peak V_GD | Tail min | Drain min |
|---|---|---|---|---|---|---|---|
| 0 | 0.30 | 4.4060 | 1.362 | 1.37 | 1.36 | 0.44 | 0.44 |
| 0 | 0.65 | 4.4205 | 1.363 | 1.37 | 1.36 | 0.44 | 0.44 |
| 0 | 1.00 | 4.4325 | 1.369 | 1.37 | 1.37 | 0.44 | 0.44 |
| 64 | 0.30 | 3.8255 | 1.188 | 1.22 | 1.19 | 0.47 | 0.51 |
| 64 | 0.65 | 3.8355 | 1.190 | 1.22 | 1.19 | 0.47 | 0.51 |
| 64 | 1.00 | 3.8435 | 1.194 | 1.23 | 1.19 | 0.47 | 0.51 |
| 128 | 0.30 | 3.4252 | 1.053 | 1.13 | 1.05 | 0.49 | 0.56 |
| 128 | 0.65 | 3.4325 | 1.055 | 1.13 | 1.05 | 0.49 | 0.56 |
| 128 | 1.00 | 3.4386 | 1.058 | 1.13 | 1.06 | 0.49 | 0.56 |
| 192 | 0.30 | 3.1266 | 0.939 | 1.06 | 0.94 | 0.49 | 0.61 |
| 192 | 0.65 | 3.1327 | 0.941 | 1.06 | 0.94 | 0.49 | 0.61 |
| 192 | 1.00 | 3.1377 | 0.944 | 1.06 | 0.94 | 0.49 | 0.61 |
| 255 | 0.30 | 2.8964 | 0.839 | 1.01 | 0.84 | 0.49 | 0.66 |
| 255 | 0.65 | 2.9014 | 0.841 | 1.01 | 0.84 | 0.49 | 0.65 |
| 255 | 1.00 | 2.9054 | 0.844 | 1.01 | 0.84 | 0.49 | 0.65 |

Range: 2.905-4.406 GHz (needed 3.12-4.20, design 3.00-4.37 GHz): covers the band.
KVCO at code 0: 38.0 MHz/V (needed about 14-47 MHz/V over the range, D8)
KVCO at code 128: 19.1 MHz/V (needed about 14-47 MHz/V over the range, D8)
KVCO at code 255: 12.8 MHz/V (needed about 14-47 MHz/V over the range, D8)

Band for pnoise: code 91 at V_tune 0.65 V -> 3.6495 GHz (target 3.65 GHz)
Tail current for 1.3 V: 4.00 mA -> 1.198 V, 3.6447 GHz, peak V_GS 1.24 / V_GD 1.20 V

Tail current per band for about 1.3 V (VCO_BIAS): code 0: 3.3 mA, code 64: 3.8 mA, code 128: 4.0 mA, code 192: 4.0 mA, code 255: 4.0 mA
