Supermagnum/SDR-repeater/analog/vco/step2/out/summary_steps_d24.txt

## Band steps (8-bit bank, V_tune 0.65 V) — D24 first trim [SCH]
# trim_bin=[1.0, 0.9607, 0.9487, 0.9390, 0.9368], trim_unit=0.9347, lsb=6.19 fF, cfix=192 fF
# (subsequent unit nudges worsened high-code ratios; this set is the kept baseline)

| Codes | f (GHz) | Step (MHz) | Step / mean step nearby | KVCO (MHz/V) | Step in V_tune (V) |
|---|---|---|---|---|---|
| 0→1 | 4.4205 | +11.28 | 1.01 | 38.0 | 0.297 |
| 1→2 | 4.4092 | +11.13 | 1.00 | 37.8 | 0.295 |
| 3→4 | 4.3870 | +11.13 | 1.01 | 37.4 | 0.298 |
| 7→8 | 4.3434 | +10.64 | 1.00 | 36.6 | 0.290 |
| 15→16 | 4.2600 | +10.22 | 1.01 | 35.1 | 0.291 |
| 31→32 | 4.1064 | +9.05 | 1.00 | 32.1 | 0.282 |
| 63→64 | 3.8430 | +7.47 | 1.01 | 26.0 | 0.287 |
| 95→96 | 3.6236 | +5.71 | 0.90 | 22.6 | 0.253 |
| 127→128 | 3.4378 | +5.33 | 0.99 | 19.2 | 0.277 |
| 159→160 | 3.2772 | +4.69 | 1.01 | 17.5 | 0.268 |
| 191→192 | 3.1369 | +4.19 | 1.02 | 15.8 | 0.265 |
| 223→224 | 3.0126 | +3.66 | 1.00 | 14.3 | 0.256 |
| 253→254 | 2.9080 | +3.20 | 0.96 | 12.9 | 0.247 |
| 254→255 | 2.9048 | +3.37 | 1.01 | 12.9 | 0.261 |

Largest step in V_tune: 0.298 V (limit 0.30 V) — PASS.
Carry ratios: all in 0.94–1.07 except **95→96 = 0.90** — FAIL (sole outlier).
