Supermagnum/SDR-repeater/analog/vco/step2/out/summary_range.txt

## Sizing (bank scale and fixed capacitor, two passes)

pass 1: LSB 3.75 fF, fixed 0 fF -> code 0 5.906 GHz (427 fF), code 255 3.725 GHz (1074 fF), switched 646 fF
pass 2: LSB 5.82 fF, fixed 186 fF -> code 0 4.440 GHz (756 fF), code 255 2.896 GHz (1776 fF), switched 1020 fF
result: LSB 5.72 fF (on-state), fixed 200 fF differential, varactor 20 fingers

## Bank trim (equal steps at the carries)

pass 1: bit 1: carry 11.13 / LSB 10.35 MHz -> trim 1.0000 -> 0.9650; bit 2: carry 12.42 / LSB 10.22 MHz -> trim 1.0000 -> 0.9505; bit 3: carry 15.05 / LSB 9.84 MHz -> trim 1.0000 -> 0.9396; bit 4: carry 19.73 / LSB 9.37 MHz -> trim 1.0000 -> 0.9364; bit 5: carry 27.58 / LSB 8.43 MHz -> trim 1.0000 -> 0.9347; bit 6: carry 40.22 / LSB 7.29 MHz -> trim 1.0000 -> 0.9319; bit 7: carry 60.89 / LSB 5.11 MHz -> trim 1.0000 -> 0.9197

pass 2: bit 1: carry 10.91 / LSB 10.97 MHz -> trim 0.9650 -> 0.9674; bit 2: carry 10.90 / LSB 10.77 MHz -> trim 0.9505 -> 0.9477; bit 3: carry 10.43 / LSB 10.54 MHz -> trim 0.9396 -> 0.9409; bit 4: carry 10.01 / LSB 9.88 MHz -> trim 0.9364 -> 0.9357; bit 5: carry 9.04 / LSB 9.07 MHz -> trim 0.9347 -> 0.9348; bit 6: carry 6.74 / LSB 7.82 MHz -> trim 0.9319 -> 0.9340; bit 7: carry 2.01 / LSB 4.91 MHz -> trim 0.9197 -> 0.9236

## Sizing (bank scale and fixed capacitor, two passes)

pass 1: LSB 5.72 fF, fixed 200 fF -> code 0 4.509 GHz (733 fF), code 255 2.995 GHz (1662 fF), switched 929 fF
result: LSB 6.18 fF (on-state), fixed 198 fF differential, varactor 20 fingers

## Bank trim (equal steps at the carries)

pass 1: bit 1: carry 11.18 / LSB 11.22 MHz -> trim 0.9674 -> 0.9692; bit 2: carry 10.83 / LSB 11.04 MHz -> trim 0.9477 -> 0.9523; bit 3: carry 10.36 / LSB 10.72 MHz -> trim 0.9409 -> 0.9451; bit 4: carry 9.23 / LSB 10.06 MHz -> trim 0.9357 -> 0.9408; bit 5: carry 7.81 / LSB 9.09 MHz -> trim 0.9348 -> 0.9392; bit 6: carry 6.56 / LSB 7.19 MHz -> trim 0.9340 -> 0.9353; bit 7: carry 2.94 / LSB 5.42 MHz -> trim 0.9236 -> 0.9272

## Tuning range and swing (noiseless transient, 60 ns, last 20 ns measured)

I_tail 3.5 mA, VDD_VCO 1.1 V. Peak V_GS / V_GD of the core against 1.5 V.

| Code | V_tune | f (GHz) | Diff. amplitude (V) | Peak V_GS | Peak V_GD | Tail min | Drain min |
|---|---|---|---|---|---|---|---|
| 0 | 0.30 | 4.4042 | 1.343 | 1.35 | 1.34 | 0.44 | 0.45 |
| 0 | 0.65 | 4.4188 | 1.344 | 1.35 | 1.34 | 0.44 | 0.45 |
| 0 | 1.00 | 4.4309 | 1.349 | 1.35 | 1.35 | 0.44 | 0.44 |
| 64 | 0.30 | 3.8235 | 1.156 | 1.20 | 1.16 | 0.48 | 0.52 |
| 64 | 0.65 | 3.8338 | 1.158 | 1.20 | 1.16 | 0.48 | 0.52 |
| 64 | 1.00 | 3.8422 | 1.161 | 1.20 | 1.16 | 0.48 | 0.52 |
| 128 | 0.30 | 3.4222 | 0.961 | 1.07 | 0.96 | 0.49 | 0.60 |
| 128 | 0.65 | 3.4300 | 0.963 | 1.07 | 0.96 | 0.49 | 0.60 |
| 128 | 1.00 | 3.4359 | 0.966 | 1.07 | 0.97 | 0.49 | 0.60 |
| 192 | 0.30 | 3.1239 | 0.856 | 1.02 | 0.86 | 0.49 | 0.65 |
| 192 | 0.65 | 3.1300 | 0.858 | 1.02 | 0.86 | 0.49 | 0.65 |
| 192 | 1.00 | 3.1350 | 0.860 | 1.02 | 0.86 | 0.49 | 0.65 |
| 255 | 0.30 | 2.8935 | 0.770 | 0.98 | 0.77 | 0.48 | 0.69 |
| 255 | 0.65 | 2.8985 | 0.772 | 0.98 | 0.77 | 0.48 | 0.69 |
| 255 | 1.00 | 2.9026 | 0.774 | 0.98 | 0.77 | 0.48 | 0.69 |

Range: 2.903-4.404 GHz (needed 3.12-4.20, design 3.00-4.37 GHz): covers the band.
KVCO at code 0: 38.1 MHz/V (needed about 14-47 MHz/V over the range, D8)
KVCO at code 128: 19.5 MHz/V (needed about 14-47 MHz/V over the range, D8)
KVCO at code 255: 12.9 MHz/V (needed about 14-47 MHz/V over the range, D8)

Band for pnoise: code 90 at V_tune 0.65 V -> 3.6535 GHz (target 3.65 GHz)
Tail current for 1.3 V: 4.00 mA -> 1.173 V, 3.6494 GHz, peak V_GS 1.22 / V_GD 1.17 V

Tail current per band for about 1.3 V (VCO_BIAS): code 0: 3.4 mA, code 64: 3.9 mA, code 128: 4.0 mA, code 192: 4.0 mA, code 255: 4.0 mA
