Supermagnum/SDR-repeater/analog/vco/step2/out/summary_steps.txt

## Band steps (8-bit bank, V_tune 0.65 V)

| Codes | f (GHz) | Step (MHz) | Step / mean step nearby | KVCO (MHz/V) | Step in V_tune (V) |
|---|---|---|---|---|---|
| 0→1 | 4.4188 | +11.28 | 1.01 | 38.1 | 0.296 |
| 1→2 | 4.4075 | +11.24 | 1.01 | 38.0 | 0.296 |
| 3→4 | 4.3852 | +11.07 | 1.00 | 37.6 | 0.294 |
| 7→8 | 4.3415 | +10.75 | 1.00 | 36.9 | 0.292 |
| 15→16 | 4.2580 | +10.10 | 1.00 | 35.5 | 0.285 |
| 31→32 | 4.1044 | +8.84 | 0.97 | 32.6 | 0.271 |
| 63→64 | 3.8410 | +7.25 | 0.97 | 26.9 | 0.270 |
| 127→128 | 3.4354 | +5.35 | 1.00 | 19.6 | 0.273 |
| 191→192 | 3.1342 | +4.22 | 1.02 | 16.0 | 0.265 |
| 253→254 | 2.9050 | +3.21 | 0.97 | 13.0 | 0.247 |
| 254→255 | 2.9018 | +3.29 | 1.01 | 13.0 | 0.253 |

Largest step in V_tune: 0.296 V (window 0.7 V). A negative step or a ratio far from 1 is a bank non-monotonicity.
