Supermagnum/SDR-repeater/analog/vco/step2/out/summary_8bit.txt

## Sizing (bank scale and fixed capacitor, two passes)

pass 1: LSB 3.75 fF, fixed 0 fF -> code 0 5.925 GHz (425 fF), code 255 3.726 GHz (1073 fF), switched 649 fF
pass 2: LSB 5.80 fF, fixed 190 fF -> code 0 4.442 GHz (755 fF), code 255 2.898 GHz (1774 fF), switched 1018 fF
result: LSB 5.71 fF (on-state), fixed 203 fF differential, varactor 20 fingers

## Tuning range and swing (noiseless transient, 60 ns, last 20 ns measured)

I_tail 3.5 mA, VDD_VCO 1.1 V. Peak V_GS / V_GD of the core against 1.5 V.

| Code | V_tune | f (GHz) | Diff. amplitude (V) | Peak V_GS | Peak V_GD | Tail min | Drain min |
|---|---|---|---|---|---|---|---|
| 0 | 0.30 | 4.4082 | 1.344 | 1.35 | 1.34 | 0.44 | 0.45 |
| 0 | 0.65 | 4.4230 | 1.345 | 1.35 | 1.35 | 0.44 | 0.45 |
| 0 | 1.00 | 4.4352 | 1.350 | 1.36 | 1.35 | 0.44 | 0.44 |
| 64 | 0.30 | 3.8298 | 1.158 | 1.20 | 1.16 | 0.48 | 0.52 |
| 64 | 0.65 | 3.8400 | 1.159 | 1.20 | 1.16 | 0.48 | 0.52 |
| 64 | 1.00 | 3.8485 | 1.163 | 1.20 | 1.16 | 0.48 | 0.52 |
| 128 | 0.30 | 3.4234 | 0.962 | 1.07 | 0.96 | 0.49 | 0.60 |
| 128 | 0.65 | 3.4312 | 0.963 | 1.07 | 0.96 | 0.49 | 0.60 |
| 128 | 1.00 | 3.4375 | 0.966 | 1.07 | 0.97 | 0.49 | 0.60 |
| 192 | 0.30 | 3.1278 | 0.858 | 1.02 | 0.86 | 0.49 | 0.65 |
| 192 | 0.65 | 3.1339 | 0.859 | 1.02 | 0.86 | 0.49 | 0.65 |
| 192 | 1.00 | 3.1389 | 0.862 | 1.02 | 0.86 | 0.49 | 0.65 |
| 255 | 0.30 | 2.9011 | 0.773 | 0.98 | 0.77 | 0.48 | 0.69 |
| 255 | 0.65 | 2.9062 | 0.775 | 0.98 | 0.77 | 0.48 | 0.69 |
| 255 | 1.00 | 2.9103 | 0.777 | 0.98 | 0.78 | 0.48 | 0.69 |

Range: 2.910-4.408 GHz (needed 3.12-4.20, design 3.00-4.37 GHz): covers the band.
KVCO at code 0: 38.6 MHz/V (needed about 14-47 MHz/V over the range, D8)
KVCO at code 128: 20.2 MHz/V (needed about 14-47 MHz/V over the range, D8)
KVCO at code 255: 13.1 MHz/V (needed about 14-47 MHz/V over the range, D8)

Band for pnoise: code 91 at V_tune 0.65 V -> 3.6560 GHz (target 3.65 GHz)
Tail current for 1.3 V: 4.00 mA -> 1.174 V, 3.6517 GHz, peak V_GS 1.22 / V_GD 1.17 V

Tail current per band for about 1.3 V (VCO_BIAS): code 0: 3.4 mA, code 64: 3.9 mA, code 128: 4.0 mA, code 192: 4.0 mA, code 255: 4.0 mA
