Supermagnum/SDR-repeater/analog/pll/step4/out/summary_lin.txt

# P2.5 step 4 — bias generator, window delay cell, hold switch

## Pump linearity with the bias generator [SCH]

Step-3 check (offset pair on, I_cp code 3 = 100 µA) with the DAC, the four amplifier tails and the master current from the bias generator instead of ideal sources. Step 3 nominal: INL 0.6 / 0.4 / 2.0 / 0.7 ps, lock point 2.76 / 2.76 / 3.05 / 2.75 ns.

| Corner | V_tune | INL (ps) | Lock point (ns) | Slope | Offset current (µA) | nb min / mean / max (V) | Supply (mA) |
|---|---|---|---|---|---|---|---|
| tt | 0.25 | 0.5 | 2.75 | 0.943 | 9.5 | 0.363 / 0.364 / 0.364 | 0.43 |
| tt | 0.6 | 0.3 | 2.76 | 1.055 | 10.8 | 0.362 / 0.364 / 0.364 | 0.47 |
| tt | 0.95 | 2.1 | 3.05 | 1.028 | 11.8 | 0.362 / 0.364 / 0.364 | 0.45 |
| ss | 0.6 | 0.6 | 2.76 | 1.016 | 10.6 | 0.372 / 0.374 / 0.374 | 0.45 |
| ff | 0.6 | 0.1 | 2.77 | 1.091 | 11.0 | 0.341 / 0.342 / 0.342 | 0.50 |
