Supermagnum/SDR-repeater/analog/lo/step1/out/summary_cmlx.txt

# P2.4 step 1 — divider speed checks

## CML ÷2 / ÷3 at the operating frequencies: variants [SCH]

Window that must divide: ÷2 2.9–5.0 GHz (UHF 3.2–3.84 GHz × margin), ÷3 2.9–5.7 GHz (VHF 3.12–4.41 GHz × 1.3). 0.5 mA per latch nominal, widths 10 µm per mA. Current is the measured average supply current.

| Corner | Divider | Variant | Supply current (mA) | Window | Pattern (GHz) |
|---|---|---|---|---|---|
| ss (1.08 V, 125 °C) | ÷2 | base, 0.27 V clock | 1.0 | fails | 2- 2.5- 2.9- 3.2- 3.5- 3.84- 4.2- 4.41- 5+ 5.7+ 6.5+ 8+ |
| ss (1.08 V, 125 °C) | ÷2 | 0.5 V clock | 1.0 | **OK** | 2+ 2.5+ 2.9+ 3.2+ 3.5+ 3.84+ 4.2+ 4.41+ 5+ 5.7+ 6.5+ 8+ |
| ss (1.08 V, 125 °C) | ÷2 | 0.5 V clock, latch pair 2× | 1.0 | **OK** | 2+ 2.5+ 2.9+ 3.2+ 3.5+ 3.84+ 4.2+ 4.41+ 5+ 5.7+ 6.5+ 8+ |
| ss (1.08 V, 125 °C) | ÷2 | tail-less, 0.5 V clock, latch pair 2× | 0.6 | fails | 2- 2.5- 2.9- 3.2- 3.5- 3.84- 4.2- 4.41- 5- 5.7- 6.5- 8- |
| ss (1.08 V, 125 °C) | ÷3 | base, 0.27 V clock | 2.5 | fails | 2- 2.5- 2.9- 3.2- 3.5- 3.84- 4.2- 4.41- 5- 5.7+ 6.5+ 8- |
| ss (1.08 V, 125 °C) | ÷3 | 0.5 V clock | 2.5 | **OK** | 2+ 2.5+ 2.9+ 3.2+ 3.5+ 3.84+ 4.2+ 4.41+ 5+ 5.7+ 6.5+ 8- |
| ss (1.08 V, 125 °C) | ÷3 | 0.5 V clock, latch pair 2× | 2.5 | **OK** | 2+ 2.5+ 2.9+ 3.2+ 3.5+ 3.84+ 4.2+ 4.41+ 5+ 5.7+ 6.5+ 8- |
| ss (1.08 V, 125 °C) | ÷3 | tail-less, 0.5 V clock, latch pair 2× | 1.7 | fails | 2- 2.5- 2.9- 3.2- 3.5- 3.84- 4.2- 4.41- 5- 5.7- 6.5- 8- |
| tt (1.2 V, 27 °C) | ÷2 | base, 0.27 V clock | 1.0 | **OK** | 2+ 2.5+ 2.9+ 3.2+ 3.5+ 3.84+ 4.2+ 4.41+ 5+ 5.7+ 6.5+ 8+ |
| tt (1.2 V, 27 °C) | ÷2 | 0.5 V clock | 1.0 | **OK** | 2+ 2.5+ 2.9+ 3.2+ 3.5+ 3.84+ 4.2+ 4.41+ 5+ 5.7+ 6.5+ 8+ |
| tt (1.2 V, 27 °C) | ÷2 | 0.5 V clock, latch pair 2× | 1.0 | **OK** | 2+ 2.5+ 2.9+ 3.2+ 3.5+ 3.84+ 4.2+ 4.41+ 5+ 5.7+ 6.5+ 8+ |
| tt (1.2 V, 27 °C) | ÷2 | tail-less, 0.5 V clock, latch pair 2× | 0.9 | **OK** | 2+ 2.5+ 2.9+ 3.2+ 3.5+ 3.84+ 4.2+ 4.41+ 5+ 5.7+ 6.5+ 8+ |
| tt (1.2 V, 27 °C) | ÷3 | base, 0.27 V clock | 2.5 | **OK** | 2+ 2.5+ 2.9+ 3.2+ 3.5+ 3.84+ 4.2+ 4.41+ 5+ 5.7+ 6.5+ 8+ |
| tt (1.2 V, 27 °C) | ÷3 | 0.5 V clock | 2.5 | **OK** | 2+ 2.5+ 2.9+ 3.2+ 3.5+ 3.84+ 4.2+ 4.41+ 5+ 5.7+ 6.5+ 8+ |
| tt (1.2 V, 27 °C) | ÷3 | 0.5 V clock, latch pair 2× | 2.5 | **OK** | 2+ 2.5+ 2.9+ 3.2+ 3.5+ 3.84+ 4.2+ 4.41+ 5+ 5.7+ 6.5+ 8- |
| tt (1.2 V, 27 °C) | ÷3 | tail-less, 0.5 V clock, latch pair 2× | 2.3 | **OK** | 2- 2.5+ 2.9+ 3.2+ 3.5+ 3.84+ 4.2+ 4.41+ 5+ 5.7+ 6.5+ 8- |
