Supermagnum/SDR-repeater/analog/lo/step2/out/summary_uhf_ss_pq2.txt

# P2.4 step 2 — VCO buffer and divider chains with the VCO

VCO sizing from step 2: LSB 11.47 fF, fixed 204 fF; tail cap 4 mA.
CML divider enabled at 35 ns (D15); UHF retiming output PMOS x2.

## UHF, ss (1.08 V, 125 °C), VCO target 3.20 GHz (code 87, 4.00 mA), 100 ns

Stages: buffer ckp-ckn 3.210 GHz (3.210), 1.03 V; CML divider out 1.605 GHz (1.605), 0.28 V; converter x_o2 1.605 GHz (1.605), 0.43 V; clock x_clk 1.605 GHz (1.605), 0.58 V; counter x_q1 0.401 GHz (0.401), 0.73 V.
Clock skew (ckn falling - ckp rising): -10.1 ps (period 312 ps); ckp duty 46.9 %.
VCO 3.2102 GHz. Buffer output: 0.52 / 0.52 V per side (need ≥ 0.5 × 0.90), common mode 0.53 V.
Currents: buffer 0.51 mA, CML divider 1.00 mA, converter 0.59 mA, CMOS logic 0.22 mA.

| Output | Node | f (MHz) | Expected (MHz) | Duty (%) | Phase (°) | Ideal (°) | Error (°) |
|---|---|---|---|---|---|---|---|
| I+ | x_p0 | 401.27 | 401.27 | 25.0 (ideal 25) | 0.0 | 0 | +0.00 |
| Q+ | x_p1 | 401.27 | 401.27 | 24.8 (ideal 25) | 89.9 | 90 | -0.07 |
| I- | x_p2 | 401.27 | 401.27 | 24.7 (ideal 25) | 179.6 | 180 | -0.37 |
| Q- | x_p3 | 401.27 | 401.27 | 24.8 (ideal 25) | 269.7 | 270 | -0.26 |

## UHF, ss (1.08 V, 125 °C), VCO target 3.84 GHz (code 32, 3.93 mA), 90 ns

Stages: buffer ckp-ckn 3.846 GHz (3.846), 1.08 V; CML divider out 1.923 GHz (1.923), 0.27 V; converter x_o2 1.923 GHz (1.923), 0.43 V; clock x_clk 1.923 GHz (1.923), 0.57 V; counter x_q1 0.481 GHz (0.481), 0.68 V.
Clock skew (ckn falling - ckp rising): -4.1 ps (period 260 ps); ckp duty 48.4 %.
VCO 3.8461 GHz. Buffer output: 0.54 / 0.54 V per side (need ≥ 0.5 × 0.90), common mode 0.54 V.
Currents: buffer 0.62 mA, CML divider 1.00 mA, converter 0.62 mA, CMOS logic 0.25 mA.

| Output | Node | f (MHz) | Expected (MHz) | Duty (%) | Phase (°) | Ideal (°) | Error (°) |
|---|---|---|---|---|---|---|---|
| I+ | x_p0 | 480.76 | 480.76 | 23.5 (ideal 25) | 0.0 | 0 | +0.00 |
| Q+ | x_p1 | 480.77 | 480.76 | 23.3 (ideal 25) | 89.9 | 90 | -0.10 |
| I- | x_p2 | 480.77 | 480.76 | 22.6 (ideal 25) | 179.5 | 180 | -0.54 |
| Q- | x_p3 | 480.76 | 480.76 | 23.7 (ideal 25) | 269.6 | 270 | -0.45 |
