Supermagnum/SDR-repeater/analog/lo/step2/out/summary_vhf_b2_4.txt

# P2.4 step 2 — VCO buffer and divider chains with the VCO

VCO sizing from step 2: LSB 11.47 fF, fixed 204 fF; tail cap 4 mA.
CML divider enabled at 35 ns (D15); UHF retiming output PMOS x2; buffer 3 inverters per side, last 4/8 um.

## VHF, tt (1.2 V, 27 °C), VCO target 3.12 GHz (code 97, 4.00 mA), 194 ns

Stages: buffer ckp-ckn 3.127 GHz (3.127), 1.28 V; CML divider out 1.042 GHz (1.042), 0.38 V; converter x_o2 1.042 GHz (1.042), 0.51 V; clock x_clk 1.042 GHz (1.042), 0.64 V; counter x_q1 0.130 GHz (0.130), 0.71 V.
Clock skew (ckn falling - ckp rising): -4.2 ps (period 320 ps); ckp duty 48.7 %.
VCO 3.1270 GHz. Buffer output: 0.64 / 0.64 V per side (need ≥ 0.5 × 1.00), common mode 0.61 V.
Currents: buffer 1.00 mA, CML divider 2.48 mA, converter 0.57 mA, CMOS logic 0.25 mA.

| Output | Node | f (MHz) | Expected (MHz) | Duty (%) | Phase (°) | Ideal (°) | Error (°) |
|---|---|---|---|---|---|---|---|
| 0° | x_r1 | 130.29 | 130.29 | 49.4 (ideal 50) | 0.0 | 0 | +0.00 |
| 180° | x_r1b | 130.29 | 130.29 | 49.7 (ideal 50) | 180.0 | 180 | -0.01 |
| 45° | x_r2 | 130.29 | 130.29 | 49.0 (ideal 50) | 45.0 | 45 | +0.03 |
| 225° | x_r2b | 130.29 | 130.29 | 50.1 (ideal 50) | 225.0 | 225 | -0.04 |
| 90° | x_r3 | 130.29 | 130.29 | 49.1 (ideal 50) | 90.1 | 90 | +0.06 |
| 270° | x_r3b | 130.29 | 130.29 | 50.0 (ideal 50) | 269.9 | 270 | -0.07 |
| 135° | x_r4 | 130.29 | 130.29 | 49.2 (ideal 50) | 135.0 | 135 | +0.03 |
| 315° | x_r4b | 130.29 | 130.29 | 49.9 (ideal 50) | 315.0 | 315 | -0.03 |

## VHF, tt (1.2 V, 27 °C), VCO target 4.20 GHz (code 11, 3.59 mA), 154 ns

Stages: buffer ckp-ckn 4.205 GHz (4.204), 1.29 V; CML divider out 1.402 GHz (1.401), 0.38 V; converter x_o2 1.402 GHz (1.401), 0.51 V; clock x_clk 1.402 GHz (1.401), 0.64 V; counter x_q1 0.175 GHz (0.175), 0.71 V.
Clock skew (ckn falling - ckp rising): -4.5 ps (period 238 ps); ckp duty 48.0 %.
VCO 4.2045 GHz. Buffer output: 0.65 / 0.65 V per side (need ≥ 0.5 × 1.00), common mode 0.61 V.
Currents: buffer 1.25 mA, CML divider 2.49 mA, converter 0.70 mA, CMOS logic 0.36 mA.

| Output | Node | f (MHz) | Expected (MHz) | Duty (%) | Phase (°) | Ideal (°) | Error (°) |
|---|---|---|---|---|---|---|---|
| 0° | x_r1 | 175.19 | 175.19 | 49.9 (ideal 50) | 0.0 | 0 | +0.00 |
| 180° | x_r1b | 175.19 | 175.19 | 49.1 (ideal 50) | 180.0 | 180 | -0.01 |
| 45° | x_r2 | 175.19 | 175.19 | 49.9 (ideal 50) | 45.0 | 45 | +0.04 |
| 225° | x_r2b | 175.19 | 175.19 | 49.1 (ideal 50) | 225.0 | 225 | -0.05 |
| 90° | x_r3 | 175.19 | 175.19 | 49.0 (ideal 50) | 90.1 | 90 | +0.08 |
| 270° | x_r3b | 175.19 | 175.19 | 50.1 (ideal 50) | 269.9 | 270 | -0.09 |
| 135° | x_r4 | 175.19 | 175.19 | 48.9 (ideal 50) | 135.0 | 135 | +0.04 |
| 315° | x_r4b | 175.19 | 175.19 | 50.1 (ideal 50) | 315.0 | 315 | -0.03 |

## VHF, ss (1.08 V, 125 °C), VCO target 3.12 GHz (code 97, 4.00 mA), 194 ns

Stages: buffer ckp-ckn 3.124 GHz (3.124), 1.11 V; CML divider out 1.041 GHz (1.041), 0.32 V; converter x_o2 1.041 GHz (1.041), 0.46 V; clock x_clk 1.041 GHz (1.041), 0.58 V; counter x_q1 0.130 GHz (0.130), 0.64 V.
Clock skew (ckn falling - ckp rising): +4.5 ps (period 320 ps); ckp duty 51.3 %.
VCO 3.1242 GHz. Buffer output: 0.56 / 0.56 V per side (need ≥ 0.5 × 0.90), common mode 0.54 V.
Currents: buffer 0.74 mA, CML divider 2.50 mA, converter 0.55 mA, CMOS logic 0.22 mA.

| Output | Node | f (MHz) | Expected (MHz) | Duty (%) | Phase (°) | Ideal (°) | Error (°) |
|---|---|---|---|---|---|---|---|
| 0° | x_r1 | 130.18 | 130.18 | 49.0 (ideal 50) | 0.0 | 0 | +0.00 |
| 180° | x_r1b | 130.18 | 130.18 | 49.8 (ideal 50) | 180.0 | 180 | -0.01 |
| 45° | x_r2 | 130.18 | 130.18 | 48.9 (ideal 50) | 45.0 | 45 | +0.04 |
| 225° | x_r2b | 130.18 | 130.18 | 49.9 (ideal 50) | 224.9 | 225 | -0.05 |
| 90° | x_r3 | 130.18 | 130.18 | 48.9 (ideal 50) | 90.1 | 90 | +0.09 |
| 270° | x_r3b | 130.18 | 130.18 | 49.9 (ideal 50) | 269.9 | 270 | -0.10 |
| 135° | x_r4 | 130.18 | 130.18 | 48.9 (ideal 50) | 135.0 | 135 | +0.04 |
| 315° | x_r4b | 130.18 | 130.18 | 49.8 (ideal 50) | 315.0 | 315 | -0.04 |

## VHF, ss (1.08 V, 125 °C), VCO target 4.20 GHz (code 11, 3.59 mA), 154 ns

Stages: buffer ckp-ckn 4.210 GHz (4.210), 1.06 V; CML divider out 1.403 GHz (1.403), 0.31 V; converter x_o2 1.403 GHz (1.403), 0.45 V; clock x_clk 1.404 GHz (1.403), 0.58 V; counter x_q1 0.175 GHz (0.175), 0.64 V.
Clock skew (ckn falling - ckp rising): -4.3 ps (period 238 ps); ckp duty 48.1 %.
VCO 4.2105 GHz. Buffer output: 0.53 / 0.53 V per side (need ≥ 0.5 × 0.90), common mode 0.54 V.
Currents: buffer 1.00 mA, CML divider 2.49 mA, converter 0.63 mA, CMOS logic 0.30 mA.

| Output | Node | f (MHz) | Expected (MHz) | Duty (%) | Phase (°) | Ideal (°) | Error (°) |
|---|---|---|---|---|---|---|---|
| 0° | x_r1 | 175.44 | 175.44 | 49.7 (ideal 50) | 0.0 | 0 | +0.00 |
| 180° | x_r1b | 175.44 | 175.44 | 48.8 (ideal 50) | 180.0 | 180 | -0.01 |
| 45° | x_r2 | 175.44 | 175.44 | 49.6 (ideal 50) | 45.1 | 45 | +0.06 |
| 225° | x_r2b | 175.44 | 175.44 | 48.9 (ideal 50) | 224.9 | 225 | -0.06 |
| 90° | x_r3 | 175.44 | 175.44 | 48.8 (ideal 50) | 90.1 | 90 | +0.11 |
| 270° | x_r3b | 175.44 | 175.44 | 49.7 (ideal 50) | 269.9 | 270 | -0.12 |
| 135° | x_r4 | 175.44 | 175.44 | 48.8 (ideal 50) | 135.1 | 135 | +0.05 |
| 315° | x_r4b | 175.44 | 175.44 | 49.7 (ideal 50) | 315.0 | 315 | -0.04 |
