Supermagnum/SDR-repeater/analog/lo/step2/out/summary_vhf_ss_bufm.txt

# P2.4 step 2 — VCO buffer and divider chains with the VCO

VCO sizing from step 2: LSB 11.47 fF, fixed 204 fF; tail cap 4 mA.
CML divider enabled at 35 ns (D15); UHF retiming output PMOS x2; buffer 3 inverters per side.

## VHF, ss (1.08 V, 125 °C), VCO target 3.12 GHz (code 97, 4.00 mA), 194 ns

Stages: buffer ckp-ckn 3.124 GHz (3.124), 1.12 V; CML divider out 1.041 GHz (1.041), 0.32 V; converter x_o2 1.041 GHz (1.041), 0.46 V; clock x_clk 1.041 GHz (1.041), 0.58 V; counter x_q1 0.130 GHz (0.130), 0.64 V.
Clock skew (ckn falling - ckp rising): +13.0 ps (period 320 ps); ckp duty 54.0 %.
VCO 3.1243 GHz. Buffer output: 0.56 / 0.56 V per side (need ≥ 0.5 × 0.90), common mode 0.55 V.
Currents: buffer 0.82 mA, CML divider 2.50 mA, converter 0.55 mA, CMOS logic 0.22 mA.

| Output | Node | f (MHz) | Expected (MHz) | Duty (%) | Phase (°) | Ideal (°) | Error (°) |
|---|---|---|---|---|---|---|---|
| 0° | x_r1 | 130.18 | 130.18 | 49.0 (ideal 50) | 0.0 | 0 | +0.00 |
| 180° | x_r1b | 130.18 | 130.18 | 49.8 (ideal 50) | 180.0 | 180 | -0.01 |
| 45° | x_r2 | 130.18 | 130.18 | 48.9 (ideal 50) | 45.0 | 45 | +0.04 |
| 225° | x_r2b | 130.18 | 130.18 | 49.8 (ideal 50) | 224.9 | 225 | -0.05 |
| 90° | x_r3 | 130.18 | 130.18 | 48.9 (ideal 50) | 90.1 | 90 | +0.09 |
| 270° | x_r3b | 130.18 | 130.18 | 49.9 (ideal 50) | 269.9 | 270 | -0.10 |
| 135° | x_r4 | 130.18 | 130.18 | 48.9 (ideal 50) | 135.0 | 135 | +0.04 |
| 315° | x_r4b | 130.18 | 130.18 | 49.8 (ideal 50) | 315.0 | 315 | -0.04 |
