Supermagnum/SDR-repeater/analog/lo/step2/out/summary_vhf_ss_en35.txt

# P2.4 step 2 — VCO buffer and divider chains with the VCO

VCO sizing from step 2: LSB 11.47 fF, fixed 204 fF; tail cap 4 mA.

## VHF, ss (1.08 V, 125 °C), VCO target 4.20 GHz (code 11, 3.59 mA), 154 ns

Stages: buffer ckp-ckn 4.210 GHz (4.210), 0.94 V; CML divider out 1.403 GHz (1.403), 0.31 V; converter x_o2 1.403 GHz (1.403), 0.45 V; clock x_clk 1.403 GHz (1.403), 0.58 V; counter x_q1 0.175 GHz (0.175), 0.64 V.
Clock skew (ckn falling - ckp rising): -6.2 ps (period 238 ps); ckp duty 47.3 %.
VCO 4.2102 GHz. Buffer output: 0.47 / 0.47 V per side (need ≥ 0.5 × 0.90), common mode 0.52 V.
Currents: buffer 0.77 mA, CML divider 2.51 mA, converter 0.63 mA, CMOS logic 0.30 mA.

| Output | Node | f (MHz) | Expected (MHz) | Duty (%) | Phase (°) | Ideal (°) | Error (°) |
|---|---|---|---|---|---|---|---|
| 0° | x_r1 | 175.43 | 175.43 | 49.6 (ideal 50) | 0.0 | 0 | +0.00 |
| 180° | x_r1b | 175.43 | 175.43 | 48.7 (ideal 50) | 180.0 | 180 | -0.01 |
| 45° | x_r2 | 175.43 | 175.43 | 49.4 (ideal 50) | 45.1 | 45 | +0.06 |
| 225° | x_r2b | 175.43 | 175.43 | 48.9 (ideal 50) | 224.9 | 225 | -0.06 |
| 90° | x_r3 | 175.43 | 175.43 | 48.7 (ideal 50) | 90.1 | 90 | +0.11 |
| 270° | x_r3b | 175.43 | 175.43 | 49.6 (ideal 50) | 269.9 | 270 | -0.12 |
| 135° | x_r4 | 175.43 | 175.43 | 48.7 (ideal 50) | 135.1 | 135 | +0.05 |
| 315° | x_r4b | 175.43 | 175.43 | 49.5 (ideal 50) | 315.0 | 315 | -0.04 |
