Supermagnum/SDR-repeater/analog/lo/step3/out/summary_ffhot.txt

# P2.4 step 3 — LO chains across corners, Monte Carlo

Chain as step 2 final: buffer 3 inverters per side, last 4/8 um; UHF retiming output PMOS x2; CML enable at 2 ns.

## Corners and temperature [SCH]

Ideal tank source with the lowest VCO swing (per side): 3.12 GHz 0.27 V, 4.20 GHz 0.52 V. Systematic errors only (no mismatch).

| Band | Corner | V_DD | T (°C) | VCO (GHz) | Divides | Max phase error (°) | Duty (%) | Buffer per side (V) | ckp duty (%) / skew (ps) | First wrong stage | Chain current (mA): buffer / CML / converter / logic = total |
|---|---|---|---|---|---|---|---|---|---|---|---|
| VHF | ff-hot | 1.32 | 125 | 3.12 | yes | 0.05 | 48.9–50.8 (ideal 50) | 0.69 | 50.7 / +2.0 | none | 1.37 / 2.48 / 0.63 / 0.27 = 4.76 |
<!-- vhf ff-hot 4.20: buffer 4.200/4.200 GHz 1.39 V; CML 2.100/1.400 GHz 0.10 V; converter 14.127/1.400 GHz 0.00 V; counter 7.111/0.175 GHz 0.00 V -->
| VHF | ff-hot | 1.32 | 125 | 4.20 | **NO** | nan | nan–nan (ideal 50) | 0.69 | 50.4 / +1.2 | CML | 1.60 / 2.47 / 0.30 / 0.06 = 4.44 |
