Supermagnum/SDR-repeater/analog/lo/step3/out/summary_ffhot_nk_k=1.5.txt

# P2.4 step 3 — LO chains across corners, Monte Carlo

Chain as step 2 final: buffer 3 inverters per side, last 4/8 um; UHF retiming output PMOS x2; CML enable at 2 ns.

Options: CML 0.5 mA per latch, swing 0.4 V, pair ratio 1.5; TSPC size 2; buffer AC-coupled middle stage; start-up pulse off; clock driver x1.

## Corners and temperature [SCH]

Ideal tank source with the lowest VCO swing (per side): 3.12 GHz 0.27 V, 4.20 GHz 0.52 V. Systematic errors only (no mismatch).

| Band | Corner | V_DD | T (°C) | VCO (GHz) | Divides | Max phase error (°) | Duty (%) | Buffer per side (V) | ckp duty (%) / skew (ps) | First wrong stage | Chain current (mA): buffer / CML / converter / logic = total |
|---|---|---|---|---|---|---|---|---|---|---|---|
| VHF | ff-hot | 1.32 | 125 | 3.12 | yes | 0.05 | 48.8–50.8 (ideal 50) | 0.68 | 49.8 / -0.8 | none | 1.34 / 2.48 / 0.63 / 0.28 = 4.72 |
| VHF | ff-hot | 1.32 | 125 | 4.20 | yes | 0.06 | 48.5–51.0 (ideal 50) | 0.69 | 49.6 / -0.8 | none | 1.54 / 2.47 / 0.72 / 0.40 = 5.14 |
