Supermagnum/SDR-repeater/analog/lo/step3/out/summary_mc.txt

# P2.4 step 3 — LO chains across corners, Monte Carlo

Chain as step 2 final: buffer 3 inverters per side, last 4/8 um; UHF retiming output PMOS x2; CML enable at 2 ns.

## Monte Carlo, 25 samples per case [SCH]

Mismatch on every LO transistor (V_T, beta, W, L; PDK values), top frequency of each band (largest error in degrees). Phase error of each output against its ideal position, relative to the first output; duty cycle per output. UHF image rejection from the I/Q quadrature error alone (gain matched): IRR = 10 log10((1 + cos e) / (1 - cos e)), at the 3-sigma error.

### UHF, tt (1.2 V, 27 °C), VCO 3.84 GHz: 25 of 25 samples divide correctly

| Output | Phase error mean (°) | sigma (°) | max abs (°) | Duty mean (%) | sigma (%) |
|---|---|---|---|---|---|
| I+ | +0.00 | 0.00 | 0.00 | 25.4 | 0.19 |
| Q+ | -0.05 | 0.50 | 1.08 | 24.5 | 0.16 |
| I- | -0.14 | 0.45 | 1.04 | 25.0 | 0.25 |
| Q- | -0.15 | 0.34 | 0.88 | 24.7 | 0.19 |

Quadrature error (Q+ vs I+): mean -0.05°, sigma 0.50° -> IRR at mean + 3 sigma (1.54°): **37.4 dB** (target ≥ 40 dB after host calibration, so before calibration this is the raw value)

Largest phase sigma: 0.50° (2.9 ps)

### UHF, ss (1.08 V, 125 °C), VCO 3.84 GHz: 16 of 25 samples divide correctly

| Output | Phase error mean (°) | sigma (°) | max abs (°) | Duty mean (%) | sigma (%) |
|---|---|---|---|---|---|
| I+ | +0.00 | 0.00 | 0.00 | 23.3 | 1.78 |
| Q+ | -0.15 | 1.07 | 3.13 | 22.6 | 1.37 |
| I- | -0.54 | 0.85 | 2.11 | 22.7 | 1.38 |
| Q- | -0.77 | 1.06 | 3.52 | 23.5 | 1.19 |

Quadrature error (Q+ vs I+): mean -0.15°, sigma 1.07° -> IRR at mean + 3 sigma (3.36°): **30.6 dB** (target ≥ 40 dB after host calibration, so before calibration this is the raw value)

Largest phase sigma: 1.07° (6.2 ps)

### VHF, tt (1.2 V, 27 °C), VCO 4.20 GHz: 25 of 25 samples divide correctly

| Output | Phase error mean (°) | sigma (°) | max abs (°) | Duty mean (%) | sigma (%) |
|---|---|---|---|---|---|
| 0° | +0.00 | 0.00 | 0.00 | 48.2 | 0.11 |
| 180° | +0.00 | 0.15 | 0.30 | 50.7 | 0.11 |
| 45° | +0.04 | 0.13 | 0.34 | 48.3 | 0.09 |
| 225° | -0.07 | 0.14 | 0.29 | 50.6 | 0.11 |
| 90° | +0.04 | 0.16 | 0.30 | 49.3 | 0.10 |
| 270° | -0.08 | 0.14 | 0.32 | 49.5 | 0.08 |
| 135° | +0.03 | 0.13 | 0.39 | 50.4 | 0.09 |
| 315° | -0.03 | 0.13 | 0.27 | 48.5 | 0.10 |

Largest phase sigma: 0.16° (2.6 ps)

### VHF, ss (1.08 V, 125 °C), VCO 4.20 GHz: 22 of 25 samples divide correctly

| Output | Phase error mean (°) | sigma (°) | max abs (°) | Duty mean (%) | sigma (%) |
|---|---|---|---|---|---|
| 0° | +0.00 | 0.00 | 0.00 | 47.9 | 0.09 |
| 180° | -0.00 | 0.25 | 0.46 | 50.6 | 0.12 |
| 45° | +0.05 | 0.21 | 0.54 | 48.4 | 0.12 |
| 225° | -0.12 | 0.21 | 0.47 | 50.1 | 0.12 |
| 90° | +0.06 | 0.28 | 0.53 | 49.6 | 0.17 |
| 270° | -0.10 | 0.23 | 0.49 | 48.9 | 0.13 |
| 135° | +0.03 | 0.22 | 0.63 | 50.7 | 0.14 |
| 315° | -0.03 | 0.24 | 0.45 | 47.9 | 0.11 |

Largest phase sigma: 0.28° (4.4 ps)
