Supermagnum/SDR-repeater/analog/lo/step3/out/summary_mc_vhf_i=0.65.txt

# P2.4 step 3 — LO chains across corners, Monte Carlo

Chain as step 2 final: buffer 3 inverters per side, last 4/8 um; UHF retiming output PMOS x2; CML enable at 2 ns.

Options: CML 0.65 mA per latch, swing 0.4 V, pair ratio 1; TSPC size 2; buffer as step 2; start-up pulse on.

## Monte Carlo, 8 samples per case [SCH]

Mismatch on every LO transistor (V_T, beta, W, L; PDK values), top frequency of each band (largest error in degrees). Phase error of each output against its ideal position, relative to the first output; duty cycle per output. UHF image rejection from the I/Q quadrature error alone (gain matched): IRR = 10 log10((1 + cos e) / (1 - cos e)), at the 3-sigma error.

  sample 1 (vhf ss) fails at: CML; ckp duty 46.9 %, skew -2.4 ps; buffer 4.200/4.200 GHz 0.92 V; CML 2.100/1.400 GHz 0.08 V; converter 14.404/1.400 GHz 0.00 V; counter 12.085/0.175 GHz 0.00 V
  sample 2 (vhf ss) fails at: CML; ckp duty 48.1 %, skew -18.8 ps; buffer 4.200/4.200 GHz 0.90 V; CML 1.781/1.400 GHz 0.21 V; converter 9.976/1.400 GHz 0.00 V; counter 9.838/0.175 GHz 0.00 V
  sample 6 (vhf ss) fails at: CML; ckp duty 47.8 %, skew +2.6 ps; buffer 4.200/4.200 GHz 0.91 V; CML 2.100/1.400 GHz 0.15 V; converter 13.225/1.400 GHz 0.00 V; counter 11.333/0.175 GHz 0.00 V
### VHF, ss (1.08 V, 125 °C), VCO 4.20 GHz: 5 of 8 samples divide correctly

| Output | Phase error mean (°) | sigma (°) | max abs (°) | Duty mean (%) | sigma (%) |
|---|---|---|---|---|---|
| 0° | +0.00 | 0.00 | 0.00 | 49.7 | 0.97 |
| 180° | -0.15 | 0.15 | 0.35 | 48.8 | 0.93 |
| 45° | -0.05 | 0.18 | 0.25 | 49.0 | 0.96 |
| 225° | -0.19 | 0.07 | 0.25 | 49.5 | 1.02 |
| 90° | -0.07 | 0.34 | 0.48 | 48.4 | 0.43 |
| 270° | -0.13 | 0.24 | 0.49 | 50.1 | 0.47 |
| 135° | -0.01 | 0.21 | 0.34 | 48.3 | 0.42 |
| 315° | -0.08 | 0.25 | 0.32 | 50.2 | 0.55 |

Largest phase sigma: 0.34° (5.4 ps)
