Supermagnum/SDR-repeater/analog/pll/step2/out/summary_a_ssff.txt

# P2.5 step 2a — PFD and charge pump

I_cp 100 µA, reference 36 MHz. Q/I_cp is the net charge per reference cycle divided by I_cp, in ps (ideal: equal to the phase offset dt; positive = net up). Sign check at |dt| = 3 ps for the dead zone.

## ss (1.08 V, 125 °C)

| V_tune (V) | -200 ps | -50 ps | -10 ps | -3 ps | +0 ps | +3 ps | +10 ps | +50 ps | +200 ps | Offset at 0 (ps) | Gain (slope / I_cp) | Dead zone | Reset pulse UP / DN (ps) | Replica error (mV) |
|---|---|---|---|---|---|---|---|---|---|---|---|---|---|---|
| 0.25 | -177.3 | -24.0 | +21.5 | +29.7 | +33.2 | +36.8 | +45.2 | +96.2 | +269.3 | +33.21 | 1.122 | none (±3 ps resolved) | 451 / 451 | -1.96 |
| 0.6 | -151.6 | +13.7 | +62.8 | +71.6 | +75.5 | +79.3 | +88.4 | +143.4 | +329.9 | +75.45 | 1.209 | none (±3 ps resolved) | 451 / 451 | -2.06 |
| 0.95 | -179.6 | -13.6 | +34.7 | +43.3 | +47.0 | +50.7 | +59.6 | +112.7 | +294.3 | +46.99 | 1.189 | none (±3 ps resolved) | 451 / 451 | -2.42 |

Node voltages (V) and source currents (µA) at dt = 0 over the last 10 cycles, min / mean / max:

| V_tune | pg | vr | nb | pz | nz | main up | main down | replica up | replica down |
|---|---|---|---|---|---|---|---|---|---|
| 0.25 | 0.373 / 0.373 / 0.374 | 0.248 / 0.248 / 0.249 | 0.288 / 0.291 / 0.291 | 0.701 / 0.704 / 0.747 | 0.165 / 0.230 / 0.238 | 0.3 / 97.6 / 194.0 | 8.7 / 97.4 / 232.1 | 94.6 / 97.3 / 100.8 | 80.5 / 97.3 / 106.2 |
| 0.6 | 0.366 / 0.366 / 0.367 | 0.598 / 0.598 / 0.599 | 0.289 / 0.291 / 0.292 | 0.738 / 0.741 / 0.787 | 0.298 / 0.457 / 0.494 | 0.2 / 105.5 / 199.0 | 0.0 / 105.2 / 232.6 | 102.4 / 105.2 / 108.9 | 98.1 / 105.3 / 111.9 |
| 0.95 | 0.349 / 0.349 / 0.351 | 0.947 / 0.948 / 0.949 | 0.289 / 0.291 / 0.292 | 0.973 / 0.974 / 0.984 | 0.330 / 0.491 / 0.533 | 0.1 / 105.2 / 183.4 | 0.1 / 106.2 / 229.3 | 103.5 / 106.2 / 110.1 | 99.5 / 106.2 / 112.7 |

## ff (1.32 V, -40 °C)

| V_tune (V) | -200 ps | -50 ps | -10 ps | -3 ps | +0 ps | +3 ps | +10 ps | +50 ps | +200 ps | Offset at 0 (ps) | Gain (slope / I_cp) | Dead zone | Reset pulse UP / DN (ps) | Replica error (mV) |
|---|---|---|---|---|---|---|---|---|---|---|---|---|---|---|
| 0.25 | -252.3 | -106.1 | -61.8 | -53.4 | -49.7 | -45.9 | -36.5 | +16.8 | +185.1 | -49.69 | 1.101 | none (±3 ps resolved) | 188 / 187 | -0.99 |
| 0.6 | -247.2 | -79.7 | -29.0 | -19.2 | -14.9 | -10.5 | +0.2 | +61.7 | +255.3 | -14.90 | 1.266 | none (±3 ps resolved) | 188 / 187 | +20.31 |
| 0.95 | -212.0 | -36.9 | +16.1 | +25.9 | +30.2 | +34.6 | +45.0 | +102.5 | +282.3 | +30.19 | 1.245 | none (±3 ps resolved) | 188 / 187 | -1.34 |

Node voltages (V) and source currents (µA) at dt = 0 over the last 10 cycles, min / mean / max:

| V_tune | pg | vr | nb | pz | nz | main up | main down | replica up | replica down |
|---|---|---|---|---|---|---|---|---|---|
| 0.25 | 0.655 / 0.655 / 0.656 | 0.249 / 0.249 / 0.250 | 0.273 / 0.273 / 0.274 | 0.695 / 0.697 / 0.730 | 0.207 / 0.242 / 0.251 | 0.2 / 99.0 / 313.4 | 3.1 / 98.4 / 239.9 | 95.2 / 98.4 / 103.6 | 87.4 / 98.4 / 106.0 |
| 0.6 | 0.645 / 0.645 / 0.646 | 0.620 / 0.625 / 0.630 | 0.272 / 0.273 / 0.274 | 0.733 / 0.735 / 0.773 | 0.485 / 0.572 / 0.593 | 3.9 / 114.1 / 325.7 | 3.1 / 112.9 / 252.6 | 109.8 / 113.4 / 119.3 | 103.1 / 113.5 / 127.6 |
| 0.95 | 0.641 / 0.641 / 0.642 | 0.949 / 0.949 / 0.949 | 0.272 / 0.273 / 0.274 | 0.963 / 0.969 / 0.999 | 0.617 / 0.711 / 0.759 | 0.1 / 118.1 / 296.6 | 0.7 / 117.8 / 229.9 | 109.1 / 117.6 / 129.5 | 112.0 / 117.6 / 127.7 |
