Supermagnum/SDR-repeater/analog/pll/step2/out/summary_a_tt6.txt

# P2.5 step 2a — PFD and charge pump

I_cp 100 µA, reference 36 MHz. Q/I_cp is the net charge per reference cycle divided by I_cp, in ps (ideal: equal to the phase offset dt; positive = net up). Sign check at |dt| = 3 ps for the dead zone.

## tt (1.2 V, 27 °C)

| V_tune (V) | -200 ps | -50 ps | -10 ps | -3 ps | +0 ps | +3 ps | +10 ps | +50 ps | +200 ps | Offset at 0 (ps) | Gain (slope / I_cp) | Dead zone | Reset pulse UP / DN (ps) | Replica error (mV) |
|---|---|---|---|---|---|---|---|---|---|---|---|---|---|---|
| 0.25 | -225.0 | -76.9 | -31.7 | -23.3 | -19.7 | -16.0 | -7.1 | +46.2 | +216.0 | -19.69 | 1.110 | none (±3 ps resolved) | 285 / 285 | -1.61 |
| 0.6 | -207.3 | -42.3 | +8.1 | +17.5 | +21.5 | +25.7 | +35.6 | +95.0 | +283.8 | +21.53 | 1.236 | none (±3 ps resolved) | 285 / 285 | -1.75 |
| 0.95 | -176.1 | -8.9 | +41.1 | +50.0 | +53.9 | +57.8 | +67.0 | +121.4 | +293.6 | +53.89 | 1.182 | none (±3 ps resolved) | 285 / 284 | -1.84 |

Node voltages (V) and source currents (µA) at dt = 0 over the last 10 cycles, min / mean / max:

| V_tune | pg | vr | nb | pz | nz | main up | main down | replica up | replica down |
|---|---|---|---|---|---|---|---|---|---|
| 0.25 | 0.498 / 0.498 / 0.499 | 0.248 / 0.248 / 0.249 | 0.287 / 0.288 / 0.288 | 0.704 / 0.707 / 0.742 | 0.182 / 0.238 / 0.246 | 0.8 / 98.3 / 245.7 | 8.0 / 97.9 / 238.1 | 95.0 / 97.8 / 101.8 | 85.8 / 97.8 / 104.9 |
| 0.6 | 0.490 / 0.490 / 0.491 | 0.598 / 0.598 / 0.599 | 0.286 / 0.288 / 0.288 | 0.741 / 0.743 / 0.781 | 0.417 / 0.536 / 0.565 | 0.2 / 109.5 / 254.6 | 0.2 / 109.2 / 234.3 | 106.0 / 109.1 / 113.4 | 101.1 / 109.1 / 118.6 |
| 0.95 | 0.487 / 0.487 / 0.487 | 0.948 / 0.948 / 0.949 | 0.286 / 0.288 / 0.289 | 0.966 / 0.972 / 1.001 | 0.475 / 0.594 / 0.640 | 0.0 / 111.1 / 229.2 | 0.2 / 111.0 / 217.1 | 105.3 / 110.9 / 118.5 | 104.8 / 110.9 / 119.3 |
