Supermagnum/SDR-repeater/analog/pll/step2/out/summary_lin2.txt

# P2.5 step 2a — PFD and charge pump

## Linearity around the locked point, with the 8 % offset current (D18) [SCH]

Q / I_cp in ps per reference cycle against the UP lead dt; lock point = where Q = 0; INL = largest deviation from the straight-line fit, in ps of phase (and as % of the ±1 ns range).

| Corner | V_tune | 1 ns | 1.5 ns | 2 ns | 2.5 ns | 3 ns | 3.5 ns | 4 ns | 5 ns | Lock point (ns) | Slope | INL (ps) | Offset current (µA) |
|---|---|---|---|---|---|---|---|---|---|---|---|---|---|
| tt | 0.25 | -2124 | -1634 | -1145 | -656 | -167 | +323 | +812 | +1790 | 3.17 | 0.979 | 0.4 (0.02 %) | 11.3 |
| tt | 0.6 | -2472 | -1926 | -1380 | -835 | -289 | +256 | +801 | +1892 | 3.27 | 1.091 | 0.4 (0.02 %) | 13.1 |
| tt | 0.95 | -2861 | -2306 | -1752 | -1197 | -642 | -88 | +467 | +1576 | 3.58 | 1.109 | 0.0 (0.00 %) | 14.6 |
| ss | 0.25 | -2484 | -1996 | -1508 | -1021 | -534 | -47 | +440 | +1413 | 3.55 | 0.974 | 0.9 (0.05 %) | 12.8 |
| ss | 0.6 | -2824 | -2296 | -1769 | -1243 | -716 | -190 | +337 | +1390 | 3.68 | 1.053 | 0.8 (0.04 %) | 14.5 |
| ss | 0.95 | -3211 | -2683 | -2156 | -1628 | -1101 | -574 | -47 | +1007 | 4.04 | 1.054 | 1.0 (0.05 %) | 15.7 |
| ff | 0.25 | -1848 | -1356 | -864 | -372 | +120 | +612 | +1104 | +2088 | 2.88 | 0.984 | 0.2 (0.01 %) | 10.2 |
| ff | 0.6 | -2202 | -1638 | -1075 | -511 | +52 | +616 | +1179 | +2306 | 2.95 | 1.127 | 0.2 (0.01 %) | 12.1 |
| ff | 0.95 | -2573 | -1985 | -1397 | -809 | -221 | +368 | +956 | +2132 | 3.19 | 1.176 | 0.0 (0.00 %) | 13.7 |
