Supermagnum/SDR-repeater/analog/pll/step3/out/summary_mc.txt

# P2.5 step 3 — charge-pump Monte Carlo, spurs, current

## Charge-pump Monte Carlo, 10 samples per case [SCH]

Q(dt) at dt = 1-5 ns with the offset current; INL = largest deviation from the straight line (ps). Transistor mismatch on every device of PFD, pump and amplifiers.

| Corner | V_tune | Nominal INL (ps) | INL mean / max (ps) | Lock point mean / min / max (ns) | Slope mean / sigma | Offset current mean / sigma (µA) | Supply current (mA) |
|---|---|---|---|---|---|---|---|
| tt | 0.25 | 0.6 | 0.6 / 0.6 | 2.76 / 2.69 / 2.84 | 0.946 / 0.005 | 9.6 / 0.1 | 0.39 |
| tt | 0.6 | 0.4 | 0.4 / 0.5 | 2.76 / 2.70 / 2.83 | 1.059 / 0.005 | 10.9 / 0.1 | 0.43 |
| tt | 0.95 | 2.0 | 2.2 / 3.9 | 3.05 / 2.96 / 3.13 | 1.031 / 0.006 | 11.8 / 0.2 | 0.41 |
| ss | 0.6 | 0.7 | 0.7 / 0.7 | 2.75 / 2.68 / 2.83 | 1.021 / 0.004 | 10.7 / 0.1 | 0.41 |
