Supermagnum/SDR-repeater/analog/vco/layout/p272b/out/summary_assemble_c.txt

# P2.7.2b re-spin stage c — vco_core_tank DRC / LVS

## DRC
- violated: none
- density (waived): none
- hard: none → PASS

## KLayout LVS
- layout: `vco_core_tank_lvs.gds` (inductor black-box; spiral stripped if _lvs)
- PASS
- extracted: `/foss/designs/analog/vco/layout/p272b/out/lvs_vco_core_tank_c/vco_core_tank_lvs_extracted.cir`
```
* Extracted by KLayout with SG13G2 LVS runset on : 12/11/2026 15:10

.SUBCKT vco_core_tank gnd tail tn tp
M$1 gnd gnd gnd gnd sg13_lv_nmos L=0.13u W=8u AS=2.72p AD=2.72p PS=17.36u
+ PD=17.36u rfmode=0
M$2 tp tn tail gnd sg13_lv_nmos L=0.13u W=32u AS=6.68p AD=6.68p PS=39.34u
+ PD=39.34u rfmode=0
M$10 tn tp tail gnd sg13_lv_nmos L=0.13u W=32u AS=6.68p AD=6.68p PS=39.34u
+ PD=39.34u rfmode=0
R$19 gnd \$9 gnd rhigh w=2u l=15.2u ps=0u b=0 m=1
C$20 tp \$9 gnd rfcmim w=16u l=16u A=256p P=64u m=1 wfeed=5u
C$21 tn \$9 gnd rfcmim w=16u l=16u A=256p P=64u m=1 wfeed=5u
.ENDS vco_core_tank
```

## netgen
- PASS
- note: rfcmim↔cap_rfcmim rename for netgen setup [PDK]
  Final result: 
  Circuits match uniquely.
  Property errors were found.

## Summary stage c
- DRC hard: PASS
- KLayout LVS: PASS
- netgen: PASS
