Supermagnum/SDR-repeater/analog/vco/layout/p272a/out/summary_proof_build.txt

# P2.7.2a2 LVS proof cells

dac_unit bbox (-10.56,-3.36;34.36,14.45)
wrote /foss/designs/analog/vco/layout/p272a/out/dac_unit.gds
bank_unit bbox (-27.4,-20.58;68.89,66.515)
  via_stack M1→M5 @ x=26.41,45.81; switch ng=2 W=10.32
wrote /foss/designs/analog/vco/layout/p272a/out/bank_unit.gds
