Supermagnum/SDR-repeater/analog/pll/p26/step2/out/summary_uhf_floor.txt

# P2.6 open point 3 — UHF LO floor [SCH]

**Method:** full UHF LO chain — buffer + CML ÷2 + AC converter + Johnson ÷4 / retiming
(same deck as `analog/lo/step3` UHF). Ideal tank 3.84 GHz → measure Q+ (`x_p0`) at 480 MHz.
Noiseless warm-up, then ZOH transient noise (same flow as VHF). Target ≤ −150 dBc/Hz at the LO.

**Result (tt, 1 µs, noisefmax stepped 50/20/10/5 GHz):** converges at **5 GHz** noise BW
(50/20/10 GHz abort with “timestep too small”). 432 edges; rms jitter 189 fs;
noiseless numerical floor ≪ −200 dBc/Hz.

| Stage | Noise BW | Edges | RMS jitter (fs) | L@LO 1–3 MHz | L@LO 3–10 MHz | L@LO 10–30 MHz |
|---|---|---|---|---|---|---|
| full UHF chain (÷2 + Johnson) | 5 GHz | 432 | 189 | −149.4 | **−150.1** | −151.4 |

**PASS:** LO-referred floor −150.1 dBc/Hz ≤ −150. Open point 3 closed with the full chain.
Deck: `try_full_uhf_floor.py` / `run_uhf_floor.py`; totals in `summary_total.txt`.
