Supermagnum/SDR-repeater/analog/pll/p26/step3/out/summary_s5.txt

# P2.6 step 3 — transistor-level closed loop

VCO 3.456 GHz = 3 x 32 x 36 MHz, band code 125; I_cp 100 µA; loop filter D19 scaled 5 x (C1 1.232 pF, C2 18.61 pF, R1 114 kΩ, R3 539 kΩ, C3 123 fF); 20 µs from power-on.

Bias bypass (afe_seq): closed 1.00 µs (36 cycles @ 36 MHz); en_lodiv at 1.33 µs (48 cycles). Wake budget 150 µs: bypass is 1.00 µs of the 83–120 µs model wake.

## Course of the loop

| t (µs) | Pump output vt (V) | V_tune at the VCO (V) | Divider period / reference period − 1 (ppm) | VCO from the divider (GHz) | VCO amplitude (V diff.) |
|---|---|---|---|---|---|
| 0.25 | 1.1822 | 0.5565 | +887443 | 1.8310 | 0.303 |
| 2.05 | 1.0830 | 1.0789 | -2340 | 3.4641 | 0.842 |
| 3.84 | 0.8552 | 0.8525 | -2453 | 3.4645 | 0.852 |
| 5.64 | 0.3025 | 0.3444 | +619 | 3.4539 | 0.859 |
| 7.43 | 0.4207 | 0.4050 | +47 | 3.4558 | 0.870 |
| 9.23 | 0.4620 | 0.3904 | +47 | 3.4558 | 0.880 |
| 11.02 | 0.3465 | 0.3743 | +23 | 3.4559 | 0.889 |
| 12.82 | 0.4207 | 0.3712 | +14 | 3.4560 | 0.898 |
| 14.61 | 0.2942 | 0.3713 | +8 | 3.4560 | 0.906 |
| 16.41 | 0.3690 | 0.3838 | +6 | 3.4560 | 0.914 |
| 18.20 | 0.4537 | 0.3976 | +4 | 3.4560 | 0.922 |
| 20.00 | 0.3262 | 0.4083 | +2 | 3.4560 | 0.929 |

Last µs: divider period 27.7778 ns (reference 27.7778 ns, +2.5 ppm) → **locked**; VCO 3.45599 GHz (target 3.456); pump output 0.3991 V, V_tune at the VCO 0.3981 V; UP 3.16 ns, DN 0.29 ns per cycle (D18: UP ≈ 2.8 + 0.25 ns, DN ≈ 0.25 ns); divider edge 3.01 ns after the reference edge; VCO amplitude 0.929 V differential; bias node pbias 0.716 V.

**V_tune 0.40 V vs the D20 monitor / calibration model:** this run uses a **fixed** band code (125) for the integer-N interface check, not the nearest-code calibrator. With D20, one band step is 0.24–0.29 V of V_tune, so a fixed code can land anywhere in a ~0.25 V slice of the 0.25–0.95 V window. The behavioural model with nearest-code cal lands in **0.34–0.82 V** (≥ 0.09 V inside the window edges). Margin from 0.40 V to the planned low monitor threshold (≈ 0.30 V) is **0.10 V** — about 0.3–0.4 of a band step — so a fixed-code test point can sit near the flag without meaning calibrated channels do. The V_tune monitor design should keep the low threshold at ≈ 0.30 V (below the calibrated floor 0.34 V) and treat 0.40 V as a band-dependent fixed-code case, not a calibration failure.

## Bias bypass (sequencer timing)

vbp high until 1.00 µs; at open: vco_nbf = 0.794 V, vco_nb = 0.961 V (I·Ron drop while charging; Ron ≈ 30 Ω, see `spec/vco-topology.md`); vco_nbf at end of run = 0.839 V. Closed time ≫ 7 τ of the bypassed RC (τ ≈ 1.6 ns).
