Supermagnum/SDR-repeater/analog/vco/step2/out/summary_wake_bank_bypass.txt

# P2.7.1c bank bypass wake timing [SCH]

PDK minW = 0.15 µm (nmos_minW). MSB w=5.0u ng=2. Plate C from step2/out/range.json.

| bit | W (µm) | ng | C_plate (fF) | corner | Ron (Ω) | τ (ns) | nτ @1.00 µs | nτ @1.12 µs |
|---|---|---|---|---|---|---|---|---|
| 0 | 0.15 | 1 | 12.35 | mos_ss/-40 | 3066.4 | 0.038 | 26397 | 29565 |
| 0 | 0.15 | 1 | 12.35 | mos_ff/125 | 3673.5 | 0.045 | 22035 | 24679 |
| 1 | 0.15 | 1 | 23.95 | mos_ss/-40 | 3066.4 | 0.073 | 13619 | 15253 |
| 1 | 0.15 | 1 | 23.95 | mos_ff/125 | 3673.5 | 0.088 | 11368 | 12732 |
| 2 | 0.1562 | 1 | 47.06 | mos_ss/-40 | 3199.2 | 0.151 | 6642 | 7439 |
| 2 | 0.1562 | 1 | 47.06 | mos_ff/125 | 3784.5 | 0.178 | 5615 | 6288 |
| 3 | 0.3125 | 2 | 93.40 | mos_ss/-40 | 1600.1 | 0.149 | 6691 | 7494 |
| 3 | 0.3125 | 2 | 93.40 | mos_ff/125 | 1892.6 | 0.177 | 5657 | 6336 |
| 4 | 0.625 | 2 | 185.96 | mos_ss/-40 | 1250.3 | 0.233 | 4301 | 4817 |
| 4 | 0.625 | 2 | 185.96 | mos_ff/125 | 1420.9 | 0.264 | 3785 | 4239 |
| 5 | 1.25 | 2 | 371.29 | mos_ss/-40 | 608.2 | 0.226 | 4428 | 4960 |
| 5 | 1.25 | 2 | 371.29 | mos_ff/125 | 710.5 | 0.264 | 3791 | 4246 |
| 6 | 2.5 | 2 | 739.53 | mos_ss/-40 | 281.1 | 0.208 | 4810 | 5387 |
| 6 | 2.5 | 2 | 739.53 | mos_ff/125 | 338.3 | 0.250 | 3997 | 4477 |
| 7 | 5 | 2 | 1466.19 | mos_ss/-40 | 131.1 | 0.192 | 5203 | 5827 |
| 7 | 5 | 2 | 1466.19 | mos_ff/125 | 161.9 | 0.237 | 4213 | 4718 |

Worst nτ in 1.00 µs at mos_ss/-40: 4301.0 → PASS (need ≥ 6–7)
Worst nτ in 1.00 µs at mos_ff/125: 3784.5 → PASS (need ≥ 6–7)
Limiting: bit 4 mos_ff/125 τ=0.264 ns, nτ=3784.5

Var / tail bypass unchanged (not re-sized this run).
