Supermagnum/SDR-repeater/analog/pll/step2/out/summary_lin.txt

# P2.5 step 2a — PFD and charge pump

## Linearity around the locked point, with the 8 % offset current (D18) [SCH]

Q / I_cp in ps per reference cycle against the UP lead dt; lock point = where Q = 0; INL = largest deviation from the straight-line fit, in ps of phase (and as % of the ±1 ns range).

| Corner | V_tune | 1 ns | 1.5 ns | 2 ns | 2.5 ns | 3 ns | 3.5 ns | Lock point (ns) | Slope | INL (ps) |
|---|---|---|---|---|---|---|---|---|---|---|
| tt | 0.25 | +125 | +615 | +1104 | +1593 | +2083 | +2572 | 0.87 | 0.979 | 0.3 (0.02 %) |
| tt | 0.6 | +119 | +665 | +1211 | +1756 | +2302 | +2847 | 0.89 | 1.091 | 0.3 (0.01 %) |
| tt | 0.95 | -8 | +547 | +1102 | +1656 | +2211 | +2766 | 1.01 | 1.109 | 0.0 (0.00 %) |
| ss | 0.25 | -27210 | -26765 | -26277 | -25789 | -25301 | -24813 | 29.26 | 0.964 | 20.7 (1.03 %) |
| ss | 0.6 | -58 | +469 | +996 | +1523 | +2049 | +2576 | 1.05 | 1.053 | 0.6 (0.03 %) |
| ss | 0.95 | -29827 | -29343 | +835 | -28279 | +1889 | -27215 | 6.45 | 4.437 | 20600.8 (1030.04 %) |
| ff | 0.25 | +248 | +746 | +1244 | +1742 | +2240 | +2738 | 0.75 | 0.996 | 0.1 (0.01 %) |
| ff | 0.6 | +262 | +830 | +1397 | +1965 | +2532 | +3099 | 0.77 | 1.135 | 0.1 (0.01 %) |
| ff | 0.95 | +175 | +763 | +1351 | +1939 | +2528 | +3116 | 0.85 | 1.177 | 0.0 (0.00 %) |
