Supermagnum/SDR-repeater/analog/pll/p26/step2/out/summary_total.txt

# P2.6 step 2 — noise from the circuits

## Total phase noise at the duplex offset [MODEL]

Inputs: charge pump FoM -203.8 dBc/Hz, 1/f corner 79 kHz (cp, tt, 50 µA); VCO L(1 MHz) per band from P2.3 / D20 (typical); LO floor vhf_tt -154.0, uhf_tt -150.1; loop D19 (60 kHz / 55°); reference TCXO profile and Σ-Δ as P2.2.

| Ref | Band | RF (MHz) | VCO (GHz) | L(1 MHz) VCO | PN at duplex (dBc/Hz, RF) | of which VCO / CP / R / SD | LO floor | Total with floor | Limit | Margin |
|---|---|---|---|---|---|---|---|---|---|---|
| 32 | VHF | 130 | 3.120 | -124.4 | -141.9 | -146.1 / -148.5 / -146.1 / -160.6 | -154.0 | -141.7 | -136 | +5.7 dB |
| 32 | VHF | 175 | 4.200 | -119.9 | -138.9 | -141.6 / -145.9 / -144.8 / -160.6 | -154.0 | -138.8 | -136 | +2.8 dB |
| 32 | UHF | 400 | 3.200 | -124.1 | -147.0 | -147.8 / -168.2 / -155.7 / -162.8 | -150.1 | -145.3 | -136 | +9.3 dB |
| 32 | UHF | 480 | 3.840 | -121.8 | -144.9 | -145.5 / -166.6 / -154.9 / -162.8 | -150.1 | -143.7 | -136 | +7.7 dB |
| 36 | VHF | 130 | 3.120 | -124.4 | -142.3 | -146.1 / -149.0 / -146.6 / -163.2 | -154.0 | -142.0 | -136 | +6.0 dB |
| 36 | VHF | 175 | 4.200 | -119.9 | -139.2 | -141.6 / -146.4 / -145.3 / -163.2 | -154.0 | -139.0 | -136 | +3.0 dB |
| 36 | UHF | 400 | 3.200 | -124.1 | -147.1 | -147.8 / -168.7 / -156.2 / -165.4 | -150.1 | -145.3 | -136 | +9.3 dB |
| 36 | UHF | 480 | 3.840 | -121.8 | -145.0 | -145.5 / -167.1 / -155.4 / -165.4 | -150.1 | -143.8 | -136 | +7.8 dB |
