Supermagnum/SDR-repeater/reports/phase2-review/p26-result-review.md

# P2.6 result review — for owner acceptance

Date: 2026-10-30 (review); **accepted 2026-10-31** (`decisions.md`). Prerequisites: `reports/status-2026-10-30.md`.

Source table: `spec/pll-topology.md` §13 “P2.6 summary”.

## Results vs limits

| Check | Result | Limit | Tag |
|---|---|---|---|
| Loop (D19) | 60 kHz / 55°; C1 30.8 pF, C2 465 pF, R1 22.9 kΩ, R3 108 kΩ, C3 3.1 pF | corrected design | `[MODEL]` |
| Band cal (D20) | 8-bit, nearest code, 38.8 µs; V_tune 0.34–0.82 V all corners | window 0.25–0.95 V | `[MODEL]` |
| Wake | 83–120 µs | ≤ 150 µs | `[MODEL]` |
| Charge-pump noise | FoM −203.8 … −205.6 dBc/Hz; 1/f 79–141 kHz | P2.2 assumed −218 (accepted as-is) | `[SCH]` |
| LO floor VHF | −154.9 / −154.0 / −155.5 dBc/Hz (1–3 / 3–10 / 10–30 MHz) | ≤ −150 | `[SCH]` |
| LO floor UHF | −150.1 dBc/Hz (3–10 MHz; full ÷2+Johnson, noisefmax 5 GHz) | ≤ −150 | `[SCH]` 2026-10-31 |
| Total PN @ duplex | VHF worst −138.8 dBc/Hz (+2.8 dB); UHF −145.3 / −143.8 | ≤ −136 (25 W) | `[MODEL]` |
| Closed loop from power-on | locks; ≤ 7 ppm from 16 µs (5× filter scale) | locks | `[SCH]` |
| Reference spur | −109.3 dBc at RF (worst, 5 µA leakage) | ≤ −67 TX | `[MODEL]` |
| Fractional boundary spur | −123.0 VHF / −126.0 UHF (INL 3.9 ps) | ≤ −95 | `[MODEL]` |

All numeric limits that have a converging method are met. Tightest duplex margin is VHF 175 MHz (+2.8 dB).

## Four open points (status 2026-10-31)

1. **V_tune window monitor (D20).** **Closed** — option B, 0.28 / 0.775 V (`analog/pll/vtune_mon/`).
2. **Start-up bypass.** **Closed** — `afe_seq` + VCO MOS bypass.
3. **UHF LO-chain floor.** **Closed** — full UHF chain (÷2 + Johnson), −150.1 dBc/Hz @ LO at noisefmax 5 GHz (`run_uhf_floor.py`).
4. **Charge-pump in-band noise.** Idle unless an in-band requirement appears.

## Owner decision (2026-10-31)

Accepted. Before P2.7: open point **2** then **1**, then one **3** attempt. Open point **4**: no action unless an in-band requirement appears. Points 1–3 closed 2026-10-31. SCH re-run done same day (`reports/sch-rerun-2026-10-31.md`); UHF floor −150.1 full chain; VCO bank-bypass PSS issue — see that report.
