Supermagnum/SDR-repeater/analog/lo/step2/out/summary_fix.txt

# P2.4 step 2 — VCO buffer and divider chains with the VCO

VCO sizing from step 2: LSB 11.47 fF, fixed 204 fF; tail cap 4 mA.

## UHF, ss (1.08 V, 125 °C), VCO target 3.84 GHz (code 32, 3.93 mA), 90 ns

Stages: buffer ckp-ckn 3.846 GHz (3.846), 1.08 V; CML divider out 1.923 GHz (1.923), 0.27 V; converter x_o2 1.923 GHz (1.923), 0.43 V; clock x_clk 1.923 GHz (1.923), 0.57 V; counter x_q1 0.481 GHz (0.481), 0.68 V.
Clock skew (ckn falling - ckp rising): -4.1 ps (period 260 ps).
VCO 3.8461 GHz. Buffer output: 0.54 / 0.54 V per side (need ≥ 0.5 × 0.90), common mode 0.54 V.
Currents: buffer 0.62 mA, CML divider 1.00 mA, converter 0.62 mA, CMOS logic 0.23 mA.

| Output | Node | f (MHz) | Expected (MHz) | Duty (%) | Phase (°) | Ideal (°) | Error (°) |
|---|---|---|---|---|---|---|---|
| I+ | x_p0 | 480.77 | 480.77 | 21.0 (ideal 25) | 0.0 | 0 | +0.00 |
| Q+ | x_p1 | 480.77 | 480.77 | 21.3 (ideal 25) | 89.9 | 90 | -0.07 |
| I- | x_p2 | 480.77 | 480.77 | 21.3 (ideal 25) | 179.5 | 180 | -0.46 |
| Q- | x_p3 | 480.77 | 480.77 | 20.6 (ideal 25) | 269.6 | 270 | -0.38 |

## VHF, ss (1.08 V, 125 °C), VCO target 4.20 GHz (code 11, 3.59 mA), 154 ns

Stages: buffer ckp-ckn 4.211 GHz (4.211), 0.94 V; CML divider out 2.373 GHz (1.404), 0.16 V; converter x_o2 1.756 GHz (1.404), 0.23 V; clock x_clk 11.583 GHz (1.404), 0.00 V; counter x_q1 12.983 GHz (0.175), 0.00 V.
Clock skew (ckn falling - ckp rising): -6.1 ps (period 237 ps).
VCO 4.2106 GHz. Buffer output: 0.47 / 0.47 V per side (need ≥ 0.5 × 0.90), common mode 0.52 V.
Currents: buffer 0.77 mA, CML divider 2.50 mA, converter 0.30 mA, CMOS logic 0.01 mA.

| Output | Node | f (MHz) | Expected (MHz) | Duty (%) | Phase (°) | Ideal (°) | Error (°) |
|---|---|---|---|---|---|---|---|
| 0° | x_r1 | no output |
| 180° | x_r1b | no output |
| 45° | x_r2 | no output |
| 225° | x_r2b | no output |
| 90° | x_r3 | no output |
| 270° | x_r3b | no output |
| 135° | x_r4 | no output |
| 315° | x_r4b | no output |
