Supermagnum/SDR-repeater/analog/vco/sch/exports/ampcal_det.pdf

# ampcal_det.sch

# cmp

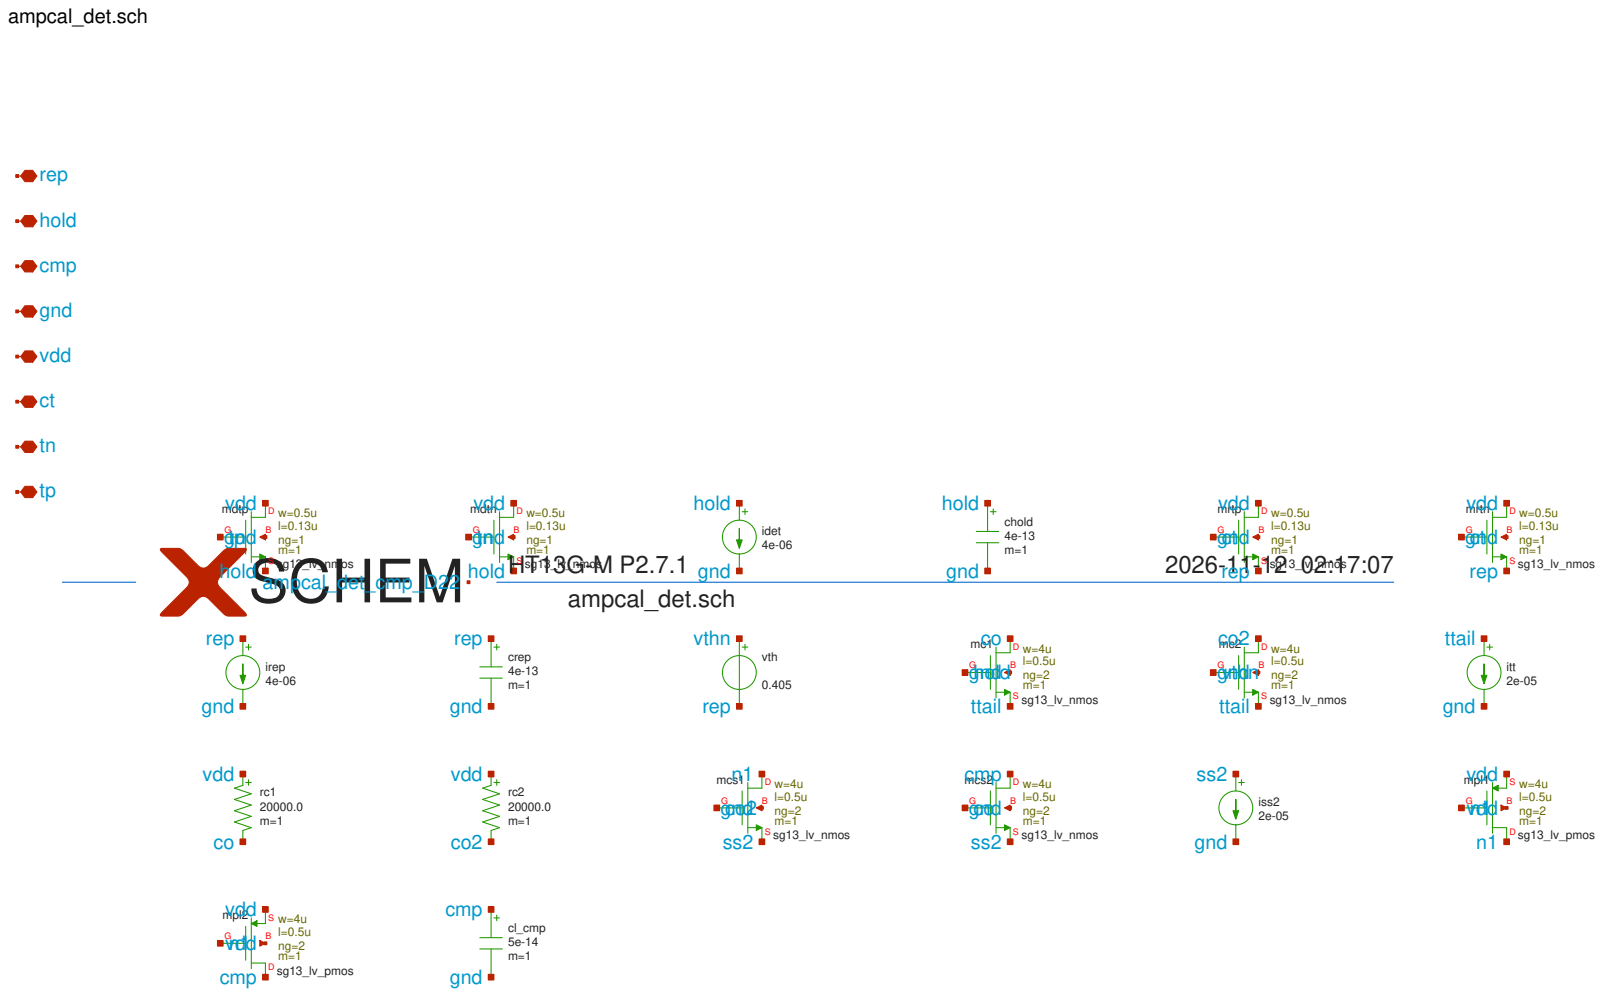
[picture p20: page 1]
vdd; gnd; hold; rep; ampcal_det.sch; 2026-11-12 02:17:07 SCHEM ampcal_det_cmp_D22; mdtp; sg13_lv_nmos; mdtn; idet; chold 4e-13 m=1; mrtp; mrtn; irep 4e-06; crep 4e-13 m=1; vth; vthn; ttail; itt; mcs1; mcs2; cmp; iss2; mpl1; sg13_lv_pmos; mpl2; cl_cmp 5e-14 m=1
