Supermagnum/SDR-repeater/analog/vco/sch/exports/vco_core.pdf

## vco_core.sch

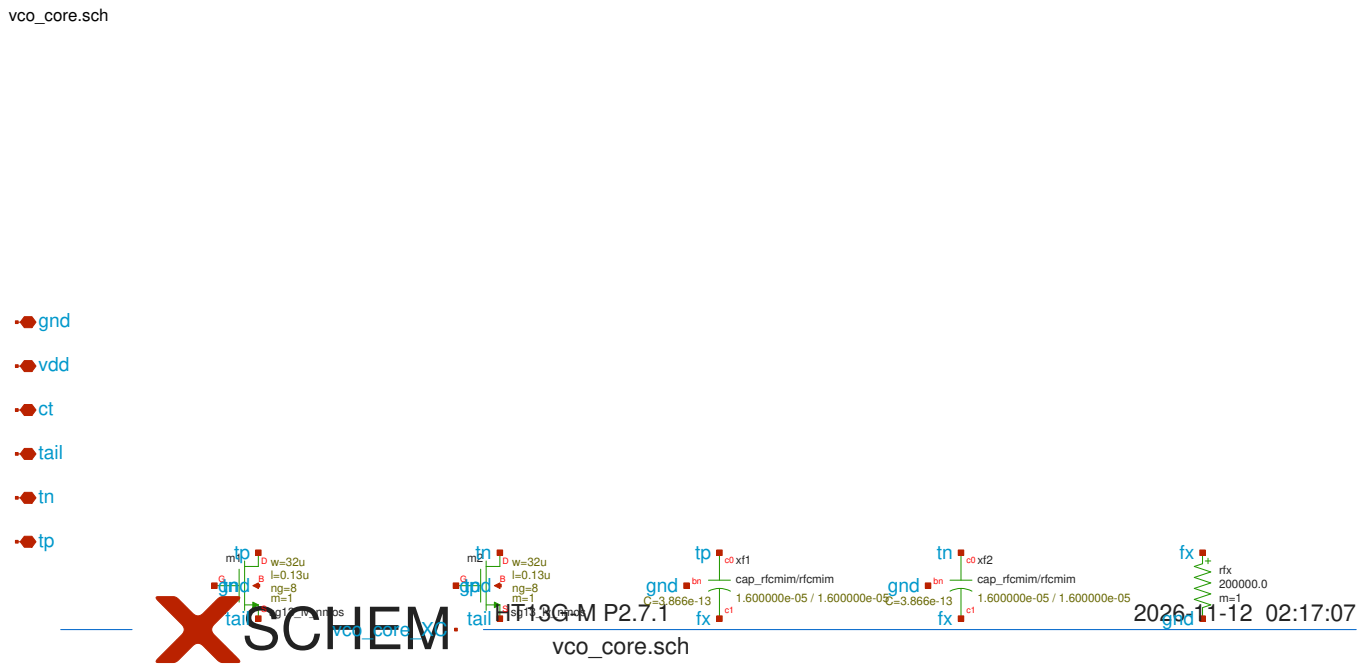
[picture p21: page 1]
tail; vdd; gnd; vco_core.sch; 2026-11-12 02:17:07 SCHEM vco_core_XC; sg13_lv_nmos; cap_rfcmim/rfcmim; rfx 200000.0 m=1
