Supermagnum/SDR-repeater/analog/vco/sch/exports/vco_var.pdf

# vco_var.sch

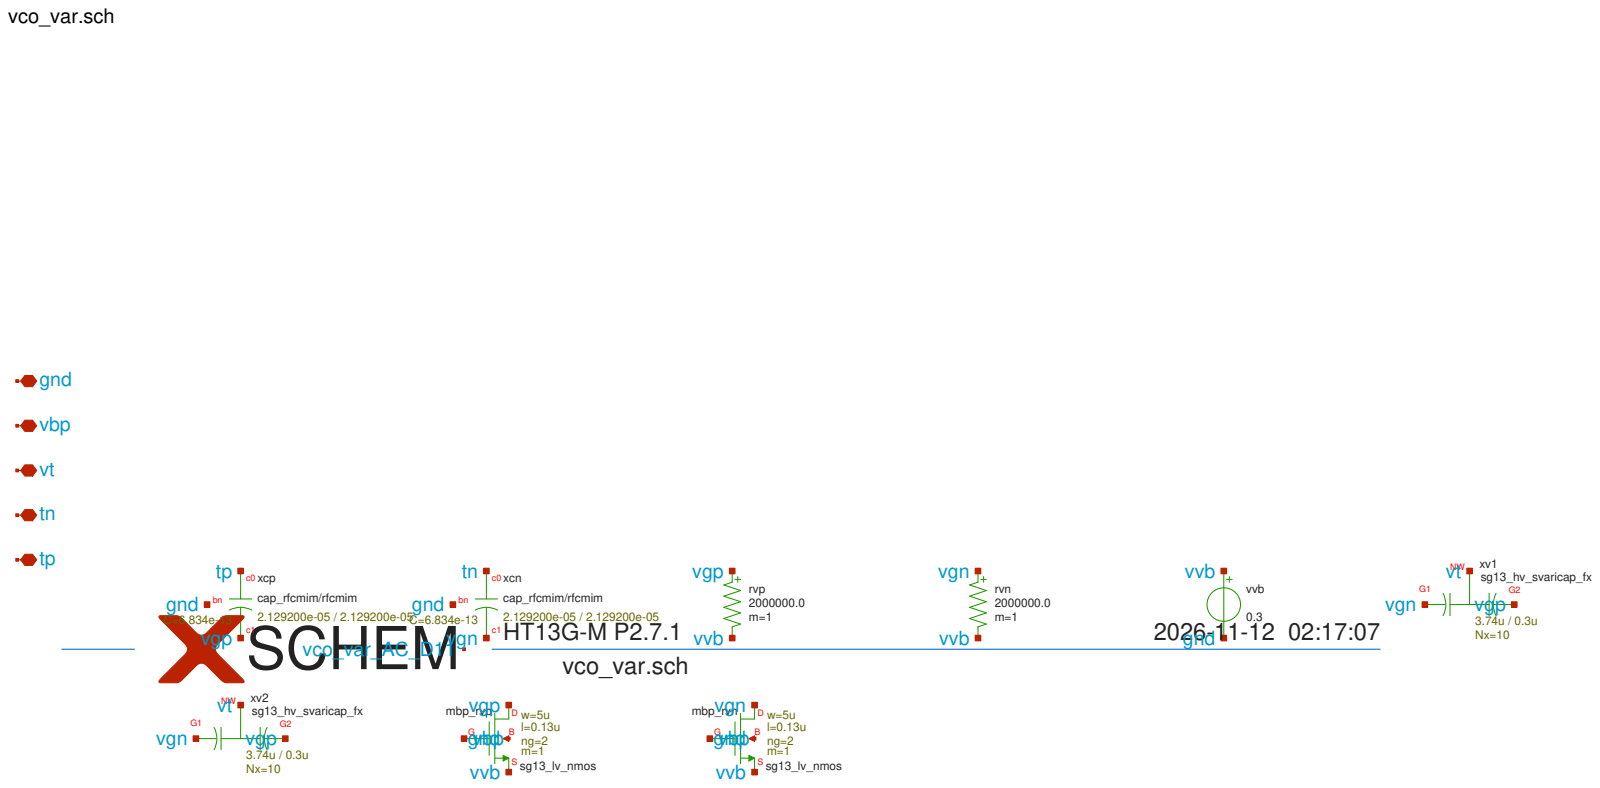
[picture p22: page 1]
vbp; gnd; vco_var.sch; 2026-11-12 02:17:07 SCHEM vco_var_AC_D11; xcp; cap_rfcmim/rfcmim; vgp; xcn; vgn; rvp 2000000.0 m=1; vvb; rvn 2000000.0 m=1; sg13_hv_svaricap_fx vgp; mbp_rvp; sg13_lv_nmos; mbp_rvn
