Supermagnum/SDR-repeater/analog/vco/sch/exports/vrana1_ldo.pdf

# vrana1_ldo.sch

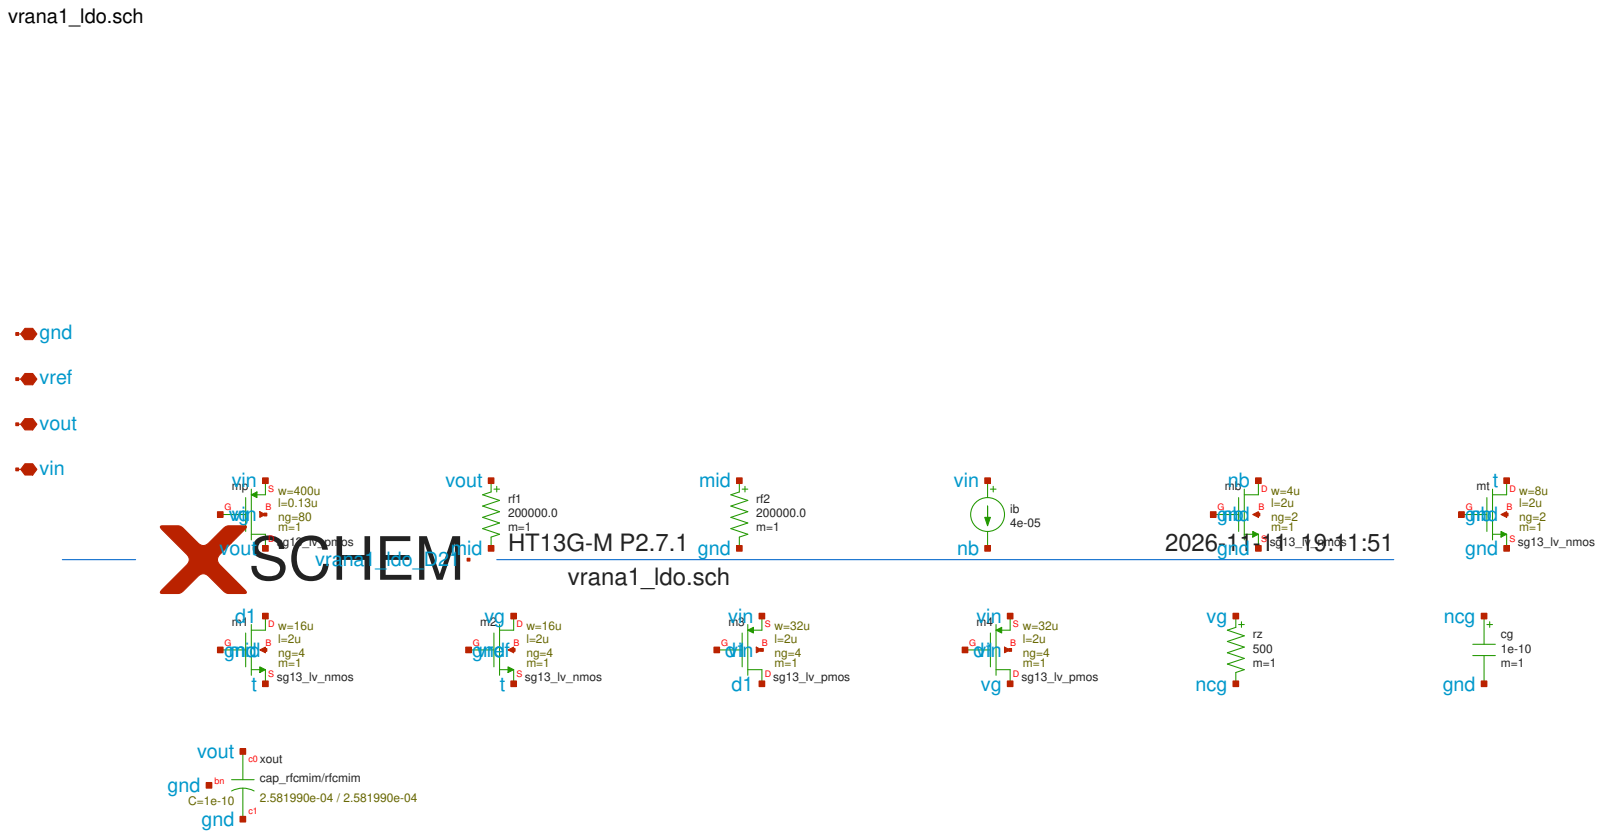
[picture p23: page 1]
vin; vout; vref; gnd; vrana1_ldo.sch; 2026-11-11 19:11:51 SCHEM vrana1_ldo_D21; sg13_lv_pmos; mid; sg13_lv_nmos; ncg; xout; cap_rfcmim/rfcmim
