Supermagnum/SDR-repeater/analog/vco/sch/exports/vco_top.pdf

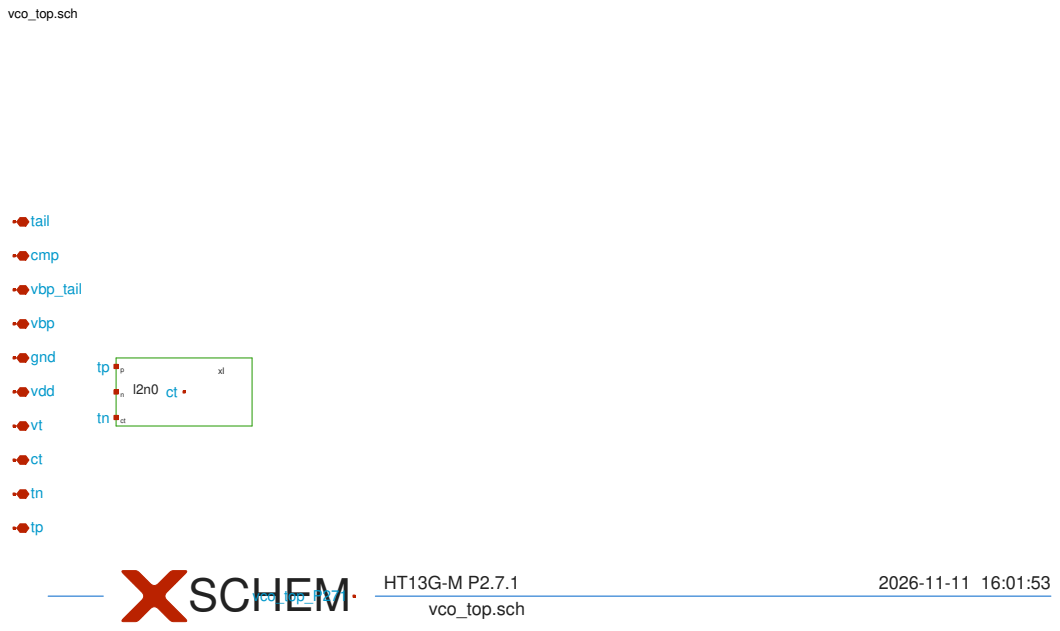
[picture p24: page 1]
vco_top.sch; vdd; gnd; vbp; vbp_tail; cmp; tail; 2026-11-11 16:01:53 SCHEM vco_top_P271
