Supermagnum/SDR-repeater/analog/vco/sch/exports/vco_bank.pdf

# vco_bank.sch

g3

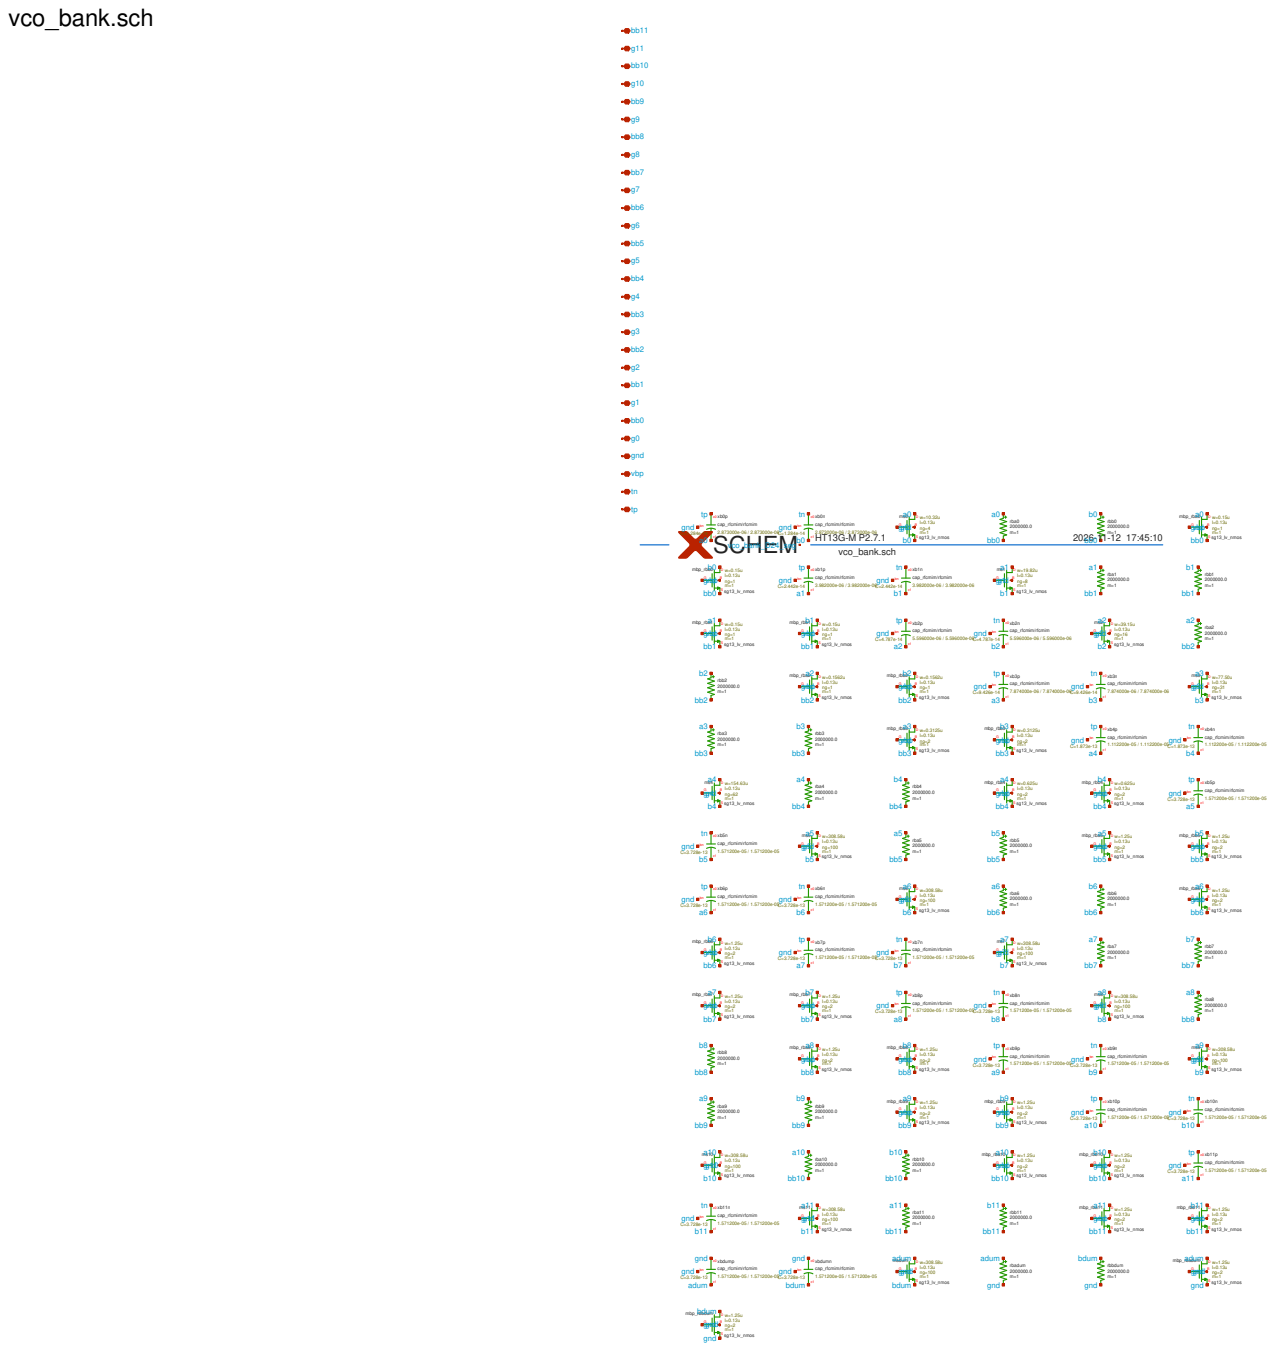
[picture p25: page 1]
vbp; gnd; vco_bank.sch; 2026-11-12 17:45:10 SCHEM vco_bank_D24_seg; cap_rfcmim/rfcmim; sg13_lv_nmos; rba0 2000000.0 m=1; rbb0 2000000.0 m=1; mbp_rba0; mbp_rbb0; rba1 2000000.0 m=1; rbb1 2000000.0 m=1; mbp_rba1; mbp_rbb1; rba2 2000000.0 m=1; rbb2 2000000.0 m=1; mbp_rba2; mbp_rbb2; rba3 2000000.0 m=1; rbb3 2000000.0 m=1; mbp_rba3; mbp_rbb3; rba4 2000000.0 m=1; rbb4 2000000.0 m=1; mbp_rba4; mbp_rbb4; rba5 2000000.0 m=1; rbb5 2000000.0 m=1; mbp_rba5; mbp_rbb5; rba6 2000000.0 m=1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
