Supermagnum/SDR-repeater/analog/vco/sch/exports/l2n0.pdf

## l2n0.sch

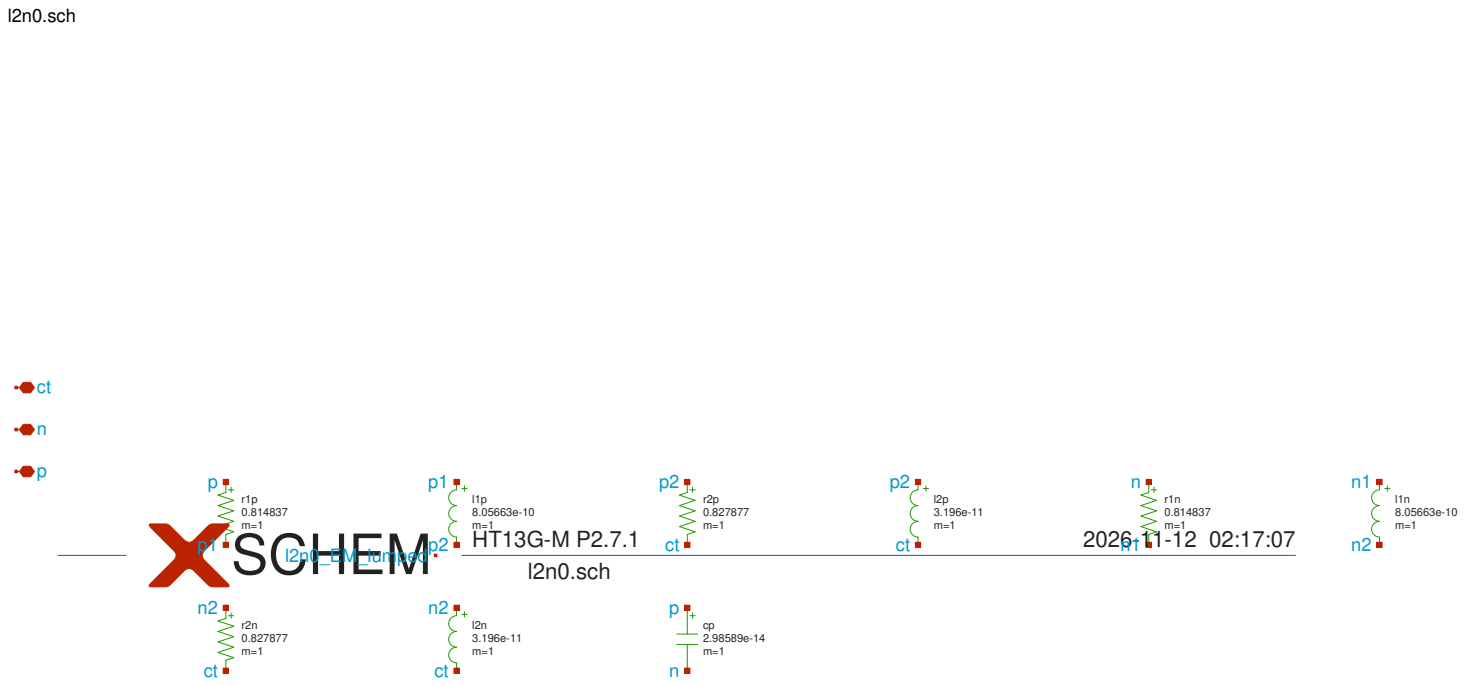
[picture p26: page 1]
l2n0.sch; 2026-11-12 02:17:07 SCHEM l2n0_EM_lumped
