Supermagnum/SDR-repeater/analog/vco/sch/exports/vco_tail_dac.pdf

# vco_tail_dac.sch

# nbf

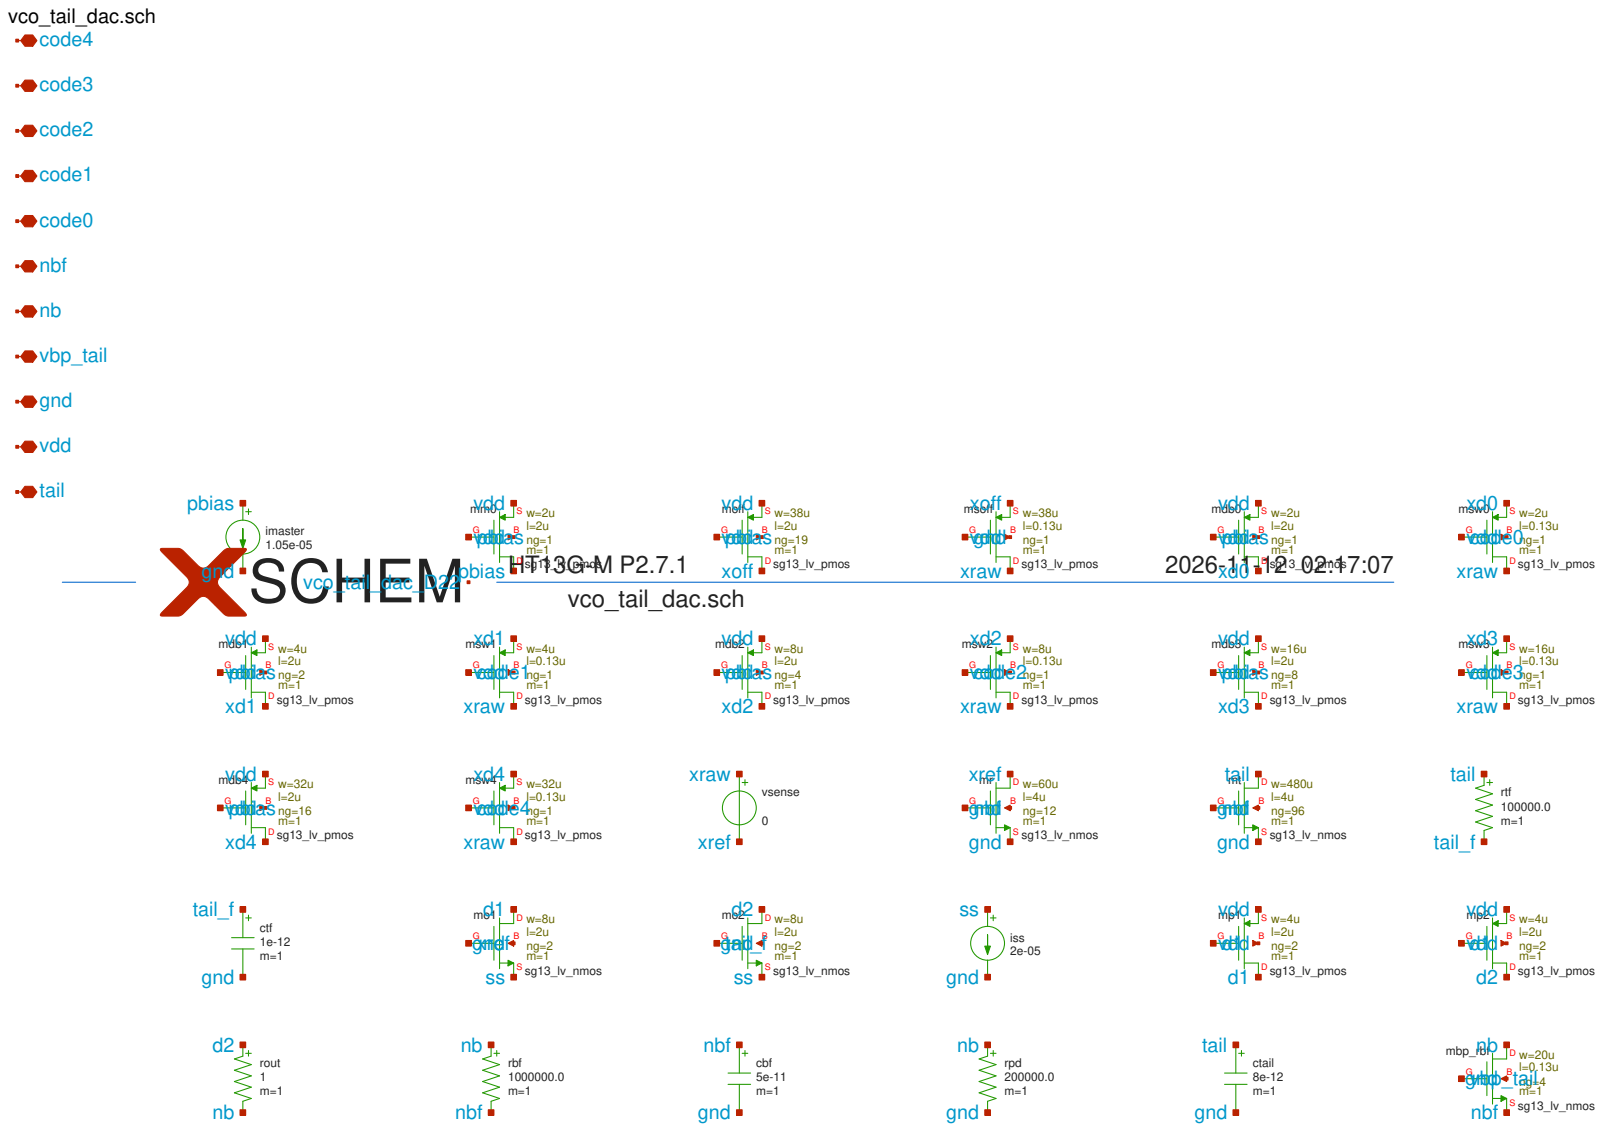
[picture p27: page 1]
tail; vdd; gnd; vbp_tail; code0; code1; code2; code3; code4; vco_tail_dac.sch; 2026-11-12 02:17:07 SCHEM vco_tail_dac_D22; imaster 1.05e-05; pbias; sg13_lv_pmos; moff; xoff; msoff; xraw; mdb0; msw0; mdb1; msw1; mdb2; msw2; mdb3; msw3; mdb4; msw4; vsense; xref; sg13_lv_nmos; nbf; rtf 100000.0 m=1; tail_f; ctf 1e-12 m=1; iss; rout 1 m=1; rbf 1000000.0 m=1; cbf 5e-11 m=1; rpd 200000.0 m=1; ctail 8e-12 m=1; mbp_rbf
