Supermagnum/SDR-repeater/analog/vco/sch/netlists/vco_bank.spice

** sch_path: /foss/designs/analog/vco/sch/vco_bank.sch
**.subckt vco_bank tp tn vbp gnd g0 bb0 g1 bb1 g2 bb2 g3 bb3 g4 bb4 g5 bb5 g6 bb6 g7 bb7 g8 bb8 g9 bb9 g10 bb10 g11 bb11
*.iopin tp
*.iopin tn
*.iopin vbp
*.iopin gnd
*.iopin g0
*.iopin bb0
*.iopin g1
*.iopin bb1
*.iopin g2
*.iopin bb2
*.iopin g3
*.iopin bb3
*.iopin g4
*.iopin bb4
*.iopin g5
*.iopin bb5
*.iopin g6
*.iopin bb6
*.iopin g7
*.iopin bb7
*.iopin g8
*.iopin bb8
*.iopin g9
*.iopin bb9
*.iopin g10
*.iopin bb10
*.iopin g11
*.iopin bb11
Xxb0p tp a0 gnd cap_rfcmim w=2.873000e-06 l=2.873000e-06 wfeed=5.0e-6 m=1 mm_ok=1
Xxb0n tn b0 gnd cap_rfcmim w=2.873000e-06 l=2.873000e-06 wfeed=5.0e-6 m=1 mm_ok=1
Xms0 a0 g0 b0 gnd sg13_lv_nmos w=10.32u l=0.13u ng=4 m=1 mm_ok=1
rba0 a0 bb0 2000000.0
rbb0 b0 bb0 2000000.0
Xmbp_rba0 a0 vbp bb0 gnd sg13_lv_nmos w=0.15u l=0.13u ng=1 m=1 mm_ok=1
Xmbp_rbb0 b0 vbp bb0 gnd sg13_lv_nmos w=0.15u l=0.13u ng=1 m=1 mm_ok=1
Xxb1p tp a1 gnd cap_rfcmim w=3.982000e-06 l=3.982000e-06 wfeed=5.0e-6 m=1 mm_ok=1
Xxb1n tn b1 gnd cap_rfcmim w=3.982000e-06 l=3.982000e-06 wfeed=5.0e-6 m=1 mm_ok=1
Xms1 a1 g1 b1 gnd sg13_lv_nmos w=19.82u l=0.13u ng=8 m=1 mm_ok=1
rba1 a1 bb1 2000000.0
rbb1 b1 bb1 2000000.0
Xmbp_rba1 a1 vbp bb1 gnd sg13_lv_nmos w=0.15u l=0.13u ng=1 m=1 mm_ok=1
Xmbp_rbb1 b1 vbp bb1 gnd sg13_lv_nmos w=0.15u l=0.13u ng=1 m=1 mm_ok=1
Xxb2p tp a2 gnd cap_rfcmim w=5.596000e-06 l=5.596000e-06 wfeed=5.0e-6 m=1 mm_ok=1
Xxb2n tn b2 gnd cap_rfcmim w=5.596000e-06 l=5.596000e-06 wfeed=5.0e-6 m=1 mm_ok=1
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
Xxbdumn gnd bdum gnd cap_rfcmim w=1.571200e-05 l=1.571200e-05 wfeed=5.0e-6 m=1 mm_ok=1
Xmsdum adum gnd bdum gnd sg13_lv_nmos w=308.58u l=0.13u ng=100 m=1 mm_ok=1
rbadum adum gnd 2000000.0
rbbdum bdum gnd 2000000.0
Xmbp_rbadum adum gnd gnd gnd sg13_lv_nmos w=1.25u l=0.13u ng=2 m=1 mm_ok=1
Xmbp_rbbdum bdum gnd gnd gnd sg13_lv_nmos w=1.25u l=0.13u ng=2 m=1 mm_ok=1
**.ends
.end
