Supermagnum/SDR-repeater/analog/vco/layout/p272b_bank/out/bank_cell_b2.spice

* P2.7.2b D24 bank_cell_b2 [SCH sizes; LVS props from extract k=2]
.subckt bank_cell_b2 tp tn g vbp bb gnd
Cxb tp a cap_cmim w=5.53u l=5.53u m=1
Cxn tn b cap_cmim w=5.53u l=5.53u m=1
Mms a g b gnd sg13_lv_nmos w=39.12u l=0.13u
Rrba a bb gnd rhigh w=5.0u l=60.8u m=1
Rrbb b bb gnd rhigh w=5.0u l=60.8u m=1
Mbp_a a vbp bb gnd sg13_lv_nmos w=0.15u l=0.13u
Mbp_b b vbp bb gnd sg13_lv_nmos w=0.15u l=0.13u
.ends
