Supermagnum/SDR-repeater/PCB/sdr-repeater/sdr-repeater.kicad_sch

## KiCad design PCB/sdr-repeater/sdr-repeater.kicad_sch (2026-10-25)

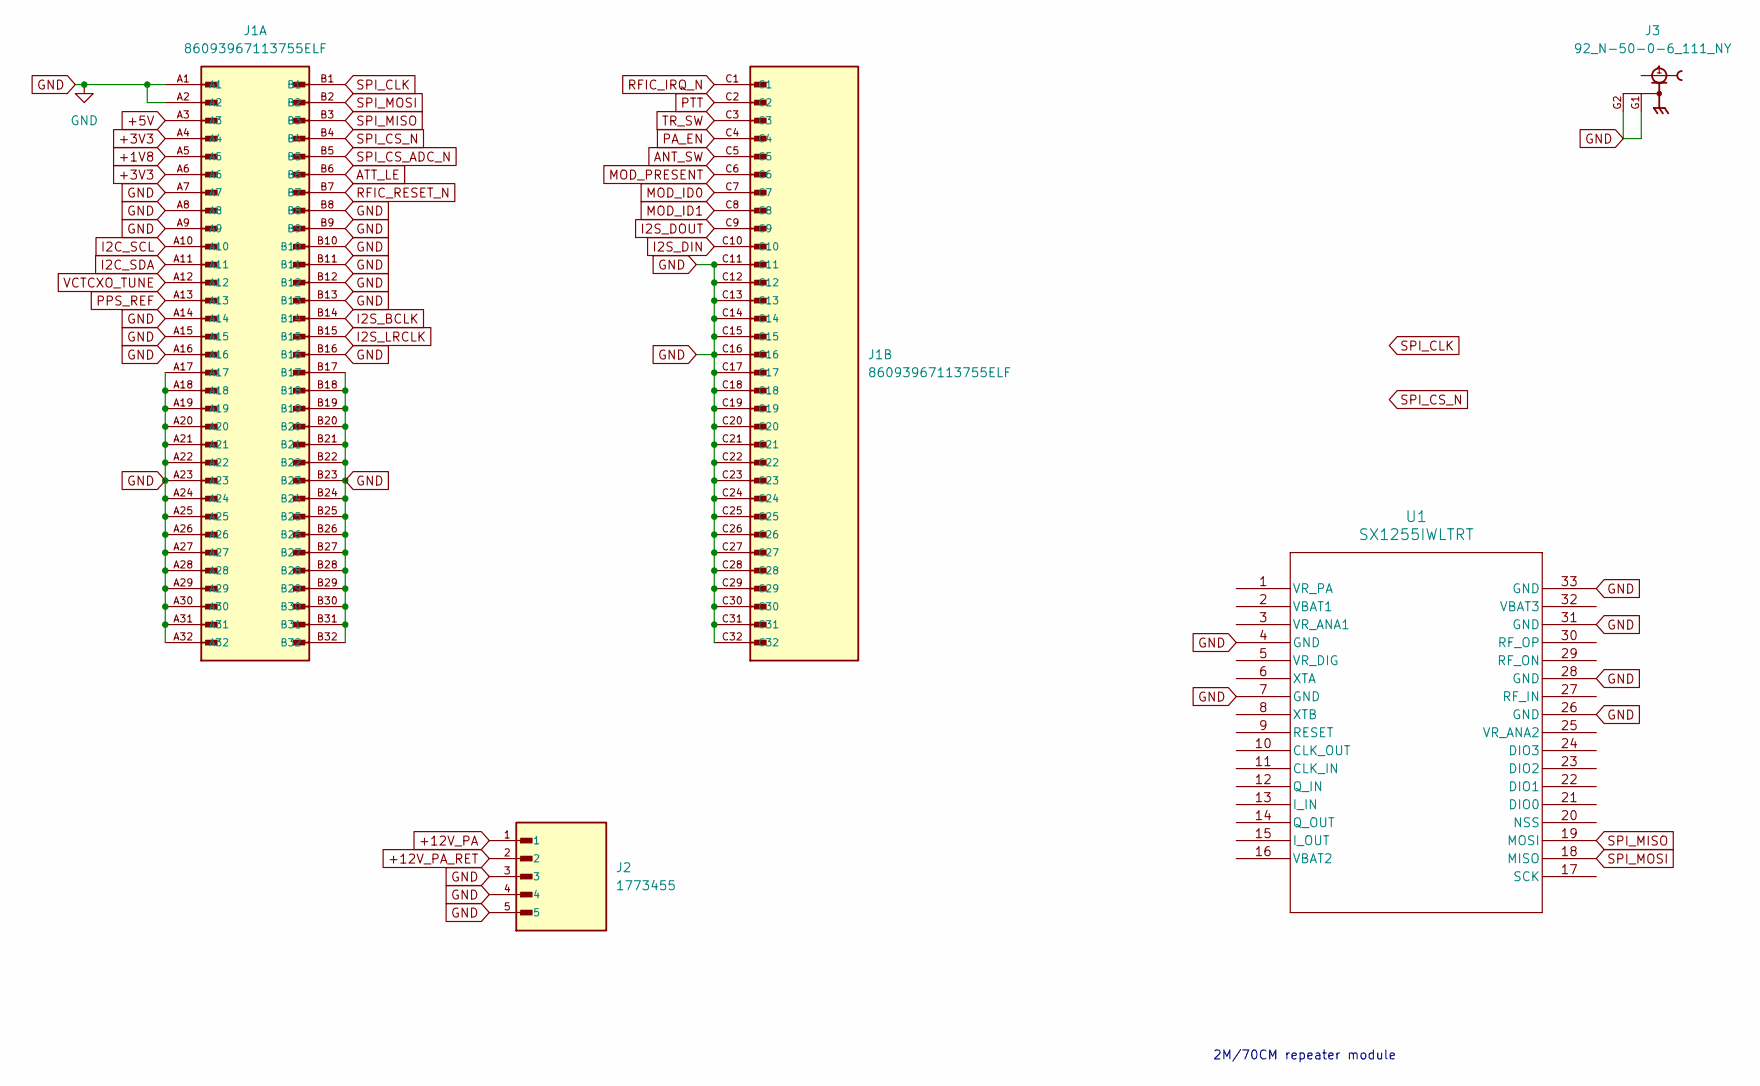
[picture p28: schematic sdr-repeater.kicad_sch]

Parts:
J1: 86093967113755ELF; AMPHENOL_86093967113755ELF; PARTREV F; DigiKey_Part_Number 609-5279-ND
J2: 1773455; PHOENIX_1773455
J3: 92_N-50-0-6_111_NY; HUBER_SUHNER_92_N-50-0-6_111_NY; PARTREV D
U1: SX1255IWLTRT; MLPQW-32_SEM

Connections:
+1V8: J1.A5
+3V3: J1.A4, J1.A6
+5V: J1.A3
+12V_PA: J2.1
+12V_PA_RET: J2.2
ANT_SW: J1.C5
ATT_LE: J1.B6
GND: J1.A1, J1.A2, J1.A7, J1.A8, J1.A9, J1.A14, J1.A15, J1.A16, J1.A17, J1.A18, J1.A19, J1.A20, J1.A21, J1.A22, J1.A23, J1.A24, J1.A25, J1.A26, J1.A27, J1.A28, J1.A29, J1.A30, J1.A31, J1.A32, J1.B8, J1.B9, J1.B10, J1.B11, J1.B12, J1.B13, J1.B16, J1.B17, J1.B18, J1.B19, J1.B20, J1.B21, J1.B22, J1.B23, J1.B24, J1.B25, J1.B26, J1.B27, J1.B28, J1.B29, J1.B30, J1.B31, J1.B32, J1.C11, J1.C12, J1.C13, J1.C14, J1.C15, J1.C16, J1.C17, J1.C18, J1.C19, J1.C20, J1.C21, J1.C22, J1.C23, J1.C24, J1.C25, J1.C26, J1.C27, J1.C28, J1.C29, J1.C30, J1.C31, J1.C32, J2.3, J2.4, J2.5, J3.G1, J3.G2, U1.4 (GND), U1.7 (GND), U1.26 (GND), U1.28 (GND), U1.31 (GND), U1.33 (GND)
I2C_SCL: J1.A10
I2C_SDA: J1.A11
I2S_BCLK: J1.B14
I2S_DIN: J1.C10
I2S_DOUT: J1.C9
I2S_LRCLK: J1.B15
MOD_ID0: J1.C7
MOD_ID1: J1.C8
MOD_PRESENT: J1.C6
PA_EN: J1.C4
PPS_REF: J1.A13
PTT: J1.C2
RFIC_IRQ_N: J1.C1
RFIC_RESET_N: J1.B7
SPI_CLK: J1.B1
SPI_CS_ADC_N: J1.B5
SPI_CS_N: J1.B4
SPI_MISO: J1.B3, U1.19 (MOSI)
SPI_MOSI: J1.B2, U1.18 (MISO)
TR_SW: J1.C3
VCTCXO_TUNE: J1.A12

Notes on the sheet:
2M/70CM repeater module
