Supermagnum/SDR-repeater/rtl/cocotb/run_sim.py

import os
from pathlib import Path

from cocotb_tools.runner import get_runner


def main():
    root = Path(__file__).resolve().parents[1] / "digital"
    sim = os.environ.get("SIM", "icarus")
    sources = [
        root / "spi_regs.sv",
        root / "rate_table.sv",
        root / "bit_front.sv",
        root / "cic4.sv",
        root / "hb_sram.sv",
        root / "fir_seq.sv",
        root / "decim_chain.sv",
        root / "power_ctrl.sv",
        root / "i2s_master.sv",
        root / "sample_fifo.sv",
        root / "i2s_slave.sv",
        root / "clk_gate.sv",
        root / "tx_chain.sv",
        root / "digital_backend.sv",
    ]
    runner = get_runner(sim)
    build_args = []
    if sim == "verilator":
        build_args = ["--timing", "-Wno-LATCH", "-Wno-WIDTHEXPAND", "-Wno-WIDTHTRUNC"]
    runner.build(
        sources=sources,
        hdl_toplevel="digital_backend",
        build_dir=Path(__file__).resolve().parent / "sim_build" / sim,
        always=True,
        build_args=build_args,
    )
    if os.environ.get("ONLY"):
        os.environ["COCOTB_TEST_FILTER"] = os.environ["ONLY"]
    runner.test(
        hdl_toplevel="digital_backend",
        test_module="test_backend",
        build_dir=Path(__file__).resolve().parent / "sim_build" / sim,
    )


if __name__ == "__main__":
    os.environ.setdefault("COCOTB_REDUCED_LOG_FMT", "1")
    main()
