Supermagnum/SDR-repeater/(commit log)

2026-05-27 Document ZMQ control plane and per-module commands.
    Clarify ctrl versus IQ sockets, add SET_SQUELCH and SET_TX_TIMEOUT examples with band tokens, and align Section 8 remote commands.
2026-05-27 Add zeromq-messages.md as canonical ZMQ wire-format reference.
    Document repeater IQ/control/status, gr-ident integration, and LinHT compatibility; link from README and RF-modules.
2026-05-30 Document optional Type-N antenna connectors as RP-SMA alternative.
    Prefer Type-N on fixed-site modules when panel space and coax plan allow; clarify this is front-panel RF only, not a VITA change.
2026-05-31 Use slot letters A-D for per-module control and IQ addressing.
    Commands and ZMQ sockets target physical module slots so two modules on the same band (e.g. 70 cm in B and C) can be controlled individually; band names remain metadata from EEPROM.
2026-06-04 Revise RF module spec and add SWR bridge details
    Updated revision, date, and related design version in RF module specification. Added SWR bridge and ADC details to the RF chain block and component specifications.
2026-06-04 Update README to clarify design concept and power sources
2026-06-04 Clarify power supply description in README
    Removed '230 V' from the power supply description for clarity.
2026-06-05 Add general ZeroMQ transport security reference and link from README.
    Introduce ZMQ_TRANSPORT_SECURITY.md as a standalone guide to plain ZMQ, CURVE, TLS wrapping, and Unix sockets; add table of contents entry 12 in README.
2026-06-06 Replace VITA 46 backplane with DIN 41612 Eurocard architecture.
    Document DIN 41612/har-bus interconnect, 1 MHz max IQ bandwidth, mandatory PCB layout standards, and align ADR 001 with README v1.5.
2026-06-06 Adopt Milk-V Megrez as primary compute platform in README v1.8.
    Document ECP5 backplane card, 5-slot architecture, compute board comparison, and Megrez computational overhead with NPU offload.
2026-06-06 Document inter-rack GbE linking and add TOC entries in README.
    Clarify that DIN 41612 is intra-chassis only; rack units link over copper GbE or optional fiber for site networking.
2026-06-18 Revise RF module specification to v0.3
    Updated RF module specification to revision 0.3, including changes to PA output power levels, component ratings, and operational notes for 5 W and 20 W configurations.
2026-10-17 Record the Phase 0 toolchain pin and the L2n0 EM baseline.
    The image PDK commit is accepted, and the inductor regression is stored so a later rerun can see the Palace and openEMS disagreement.
2026-10-17 Add the Phase 1 digital back end and its review gate.
    SPI, configurable I2S, and the RX power and duty-cycle logic are in RTL, with cocotb covering the host-facing behavior.
2026-10-17 Resubmit the Phase 1 digital back end for review.
    Replace the boxcar with an exact-rate CIC and FIR chain, make the RFIC the I2S master, and record the pre-place synthesis result. The review is not an approval.
2026-10-17 Resubmit the Phase 1 digital back end with the transmit path and a frozen register map.
    The shared MAC and normalized decimator fit the 36 MHz clock at the typical corner after placement, and the review records the area, power, and I2S duty results that are still open.
2026-10-18 WIP from agent (unfinished): SRAM half-band, 1-bit front end, SCLK SPI, RX/TX sharing; split setup/hold uncertainty; hb_sram lint fix
2026-10-18 fir_seq: write new samples at age wp-1 (fixes TX image, RX scrambled delay line)
2026-10-18 phase1f: SRAM power via Metal5 macro grid, ref_36 false path; LVS/antenna/KLayout DRC clean, timing met
2026-10-18 Vertical macro halo 13.78 um (one row) to move row cuts to ground boundaries; fixes NW.d at keep-out corners (pending phase1g check)
2026-10-18 phase1g: IHP full DRC clean, LVS/antenna clean, timing met; NW.d fixed by vertical macro halo
2026-10-18 SPI mode 0: MISO on SCLK falling edge; tests sample at rising edge and assert reset with a real edge (Verilator 13/13); i2s_master width fixes; remove debug print; PL_TARGET_DENSITY_PCT
2026-10-18 Record SPI mode 0 fix and power-up reset requirement
2026-10-18 HANDOFF: SPI mode-0 fix, Verilator, decisions; record CACE and 500 kHz decisions
2026-10-18 Reset synchroniser for the clk domain (async assert, release after 2 clk); SPI keeps raw reset
2026-10-18 SDC: SPI ports vs sclk, I2S-slave ports vs bclk_i, false paths for rst_n and clk_req
2026-10-18 phase1i: new reference layout, IHP full DRC/LVS/antenna/max-cap clean, timing met
2026-10-18 SPI: CS asynchronously clears the bit counter (aborted frames recover) + test; band_sel output; lint 0 (dead code removed, intentional cases waived with reasons); CLK_GATE[1] reserved
2026-10-18 Continuous I2S BCLK at all rates (counter-based master, per-pair slot/cell); 36 MHz/500 kHz enabled; frame-edge and duty tests
2026-10-18 Area: calibration to host, FIFO 4, TX 28-bit, one RAM address generator
    Co-Authored-By: Claude Opus 5.5 <noreply@anthropic.com>
    Claude-Session: https://claude.ai/code/session_01DDLsS4YGwNbvTGTCq3dpdi
2026-10-19 ANT_SW (c5) becomes VHF/UHF band-path select; PE4259 on the low-power side
    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
2026-10-19 RF-modules.md rev 0.4: single-chain HT13G-M on SX1255 pin-out, -5 dBm TX, active-high reset, host calibration, ANT_SW band select
    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
2026-10-19 RF parts: correct T/R switch (SKY13351 is 1 W), filter power limits, 100 W external note, parts survey
    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
2026-10-19 Close RF open items: ref_36 strap, c1/c2 to DIO1/DIO3, LinHT I2S confirmed, duplex module, five slots, 130-175 MHz VHF filter, 100 W parts
    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
2026-10-19 Pin-map RTL (ref_36 strap, PTT gate, IRQ), 100B ESR at 100 W, PLL spur limits
    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
2026-10-19 P2.0 stage 1: Palace surface model converged but reads Q high; stage 2 = filled metals + openEMS 0.7 um
    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
2026-10-20 P2.0 done: EM tank Q (stage 2) and pnoise validated in the flicker region
    - EM stage 2: filled-metal Palace converged; agrees with openEMS 0.7 um within
    1.6 % in Q. Design Q 15.3 at 3.5 GHz, L 1.69 nH +- 3 % (reports/phase2-review/p20-stage2.md)
    - pnoise flicker region: level 3 (exact) 0.2 dB, level 4b (SG13G2 real tail,
    tone injection) 0.48 dB (reports/phase2-review/p20-flicker.md)
    - Transient noise impractical on transistor circuits (14 fs steps); tran_diag.sh,
    rawprogress.py, level4_inject.py added
    - P2.3 design items: tail/varactor-bias low-pass, 2 f0 tail filter
    Claude-Session: https://claude.ai/code/session_01DDLsS4YGwNbvTG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
2026-10-20 P2.3: VCO topology memo, decisions D8-D10, step 1 device checks
    - spec/vco-topology.md: topology, tank budget, estimates; step 1 results (section 8), D11 open
    - analog/vco/tank_budget.py, analog/vco/step1/ (device checks), analog/vco/models/l2n0_lumped.inc
    - D8 7-bit bank, D9 filtered NMOS tail, D10 VCO LDO; VCO_BAND 7 bits, VCO_BIAS register
    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
2026-10-20 P2.3: VCO schematic simulated across bands, corners and temperature
    - analog/vco/step2: generated VCO netlist, automatic bank sizing, tuning range, pss/pnoise, noise contributions
    - analog/vco/step3: pss tolerance check, range at 15 corner/temperature cases, phase noise in 5 bands and at ss/85 degC
    - spec/vco-topology.md section 9: 2.95-4.41 GHz, covered at all corners; worst phase-noise margin +3.6 dB;
    open points for the result review (4 mA cap, bottom-edge margin, amplitude calibration)
    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
2026-10-20 P2.3 result review: 5 % more bank range; VCO schematic phase closed
    - Bank sizing target 955 -> 1003 fF; range 2.90-4.41 GHz, bottom-edge margin 73-84 MHz at the MIM best-case corner
    - Phase noise within limits in all bands and corners, worst margin +3.6 dB (4.20 GHz, ss, 85 degC)
    - Open points listed in spec/vco-topology.md section 9
    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
2026-10-20 P2.4: divider topology (D12-D14), step 1 speed checks
    - spec/lo-divider-topology.md: topology, D12 (VCO <= 4 mA), D13 (UHF 25 % quadrature), D14 (TSPC)
    - analog/lo/step1: CML /2 and /3, TSPC, CML-to-CMOS converter, clock-swing sweep across corners
    - Result: TSPC confirmed; CML dividers need >= 0.4 V/side clock at the slow corner -> buffer spec >= 0.5 V
    - VCO tail current capped at 4 mA (analog/vco/step2, step3)
    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
2026-10-20 P2.4 step 2 results; VCO rerun with the 4 mA cap
    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
2026-10-20 P2.4 step 2: buffer gain stage default, last-inverter size option
    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
2026-10-20 P2.4 step 2: final buffer (gain stage, last inverter 4/8 um)
    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
2026-10-21 P2.4 step 3: first results, stage diagnostics and swing check
    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
2026-10-21 P2.4 step 3: third-run results, clock-driver option and clock diagnostics
    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
2026-10-21 P2.4 step 3: ÷3 and buffer fixes as defaults, AC-coupled converter
    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
2026-10-21 P2.4 step 3 results: corners, Monte Carlo, circuit fixes
    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
2026-10-21 P2.5: D16-D18 accepted; step 1 device and block checks
    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
2026-10-21 P2.5 step 1: first results; tuning window corrected; long-channel charge-pump check
    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
2026-10-21 P2.5 step 2a: PFD and charge pump schematic and test
    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
2026-10-21 P2.5 step 2a: matched switch drivers, clamped replica amplifier, shorter reset
    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
2026-10-21 P2.5 step 2a: DC current check, buffered PFD outputs
    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
2026-10-21 P2.5 step 2a: transient node and current statistics
    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
2026-10-21 P2.5 step 2a: Miller-compensated replica loop
    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
2026-10-21 P2.5 step 2a: linearity check with the D18 offset current
    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
2026-10-21 P2.5 step 2a: PFD power-on reset, larger offset current with probe
    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
2026-10-21 P2.5 step 2a core done: PFD and charge pump pass all corners
    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
2026-10-22 P2.5 step 2a: symmetric rail-to-rail amplifiers, stronger dummy buffer
    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
2026-10-25 P2.5 step 2a: mirrors from unit fingers, matched offset pair
    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
2026-10-25 P2.5 step 2a done: transistor-level PFD and charge pump
    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
2026-10-25 P2.5 step 2c: Sigma-Delta, lock detector and band calibration (RTL and tests)
    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
2026-10-25 P2.5 step 3: charge-pump Monte Carlo, spur model, PLL current
    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
2026-10-25 Added some preliminary PCB files from Kicad.
2026-10-25 P2.5 step 3: re-seed mismatch per run so one sample is one chip
    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
2026-10-25 P2.5 step 3 results; repository-contents rule; ignore build output and KiCad backups
    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
2026-10-25 P2.5 step 4: bias generator, window delay cell, two-sided lock detector, hold switch
    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
2026-10-25 P2.5 step 4: start-up circuit turns off; supply in the hold test
    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
2026-10-25 P2.6 step 1: closed-loop model; loop-filter 2pi fix; D19, D20; 8-bit nearest-code calibration, in-phase MMD start
    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
2026-10-25 D20: 8-bit VCO bank in the P2.3 scripts, band-step check; hold result with the D19 filter
    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
2026-10-25 8-bit VCO bank: trimmed, even band steps (0.24-0.29 V of V_tune)
    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
2026-10-25 D20 bank done; P2.6 step 2: charge-pump and LO-chain noise, total phase noise
    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
2026-10-25 P2.6 step 2: LO noise third try; charge-pump noise breakdown and decision
    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
2026-10-25 P2.6 step 3: start-up bypass on every VCO bias resistor
    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
2026-10-25 P2.6 step 3: VCO starts; band two codes lower, pump output printed
    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
2026-10-31 Accept P2.6 and close open point 2 (VCO bias start-up bypass).
    Record the owner gate and P2.7 LVS notes; add afe_seq wake timing, MOS bypasses on all VCO bias resistors, and a closed-loop lock with sequencer-driven bypass (not the old hand tsw).
2026-10-31 Note V_tune 0.40 V as fixed-code landing and bypass Ron/tau.
    Confirm the low monitor threshold (~0.30 V) stays below the calibrated 0.34–0.82 V floor; record MOS bypass on-resistance so the 1 us wake window is justified at ss/-40 C.
2026-10-31 Record pre-P2.7 SCH re-run and close P2.6 open points 1–3.
    Capture VCO/LO/PLL re-run summaries, V_tune monitor option B, UHF LO floor
    (÷2+converter method), and the VCO pnoise PSS non-convergence as a known gap.
2026-11-01 Record UHF full-chain floor and VCO bank-bypass PSS stop.
    UHF LO floor is the full ÷2+Johnson chain at −150.1 dBc/Hz (optimistic noisefmax 5 GHz); bank-omitted VCO PN clears layout while the linear off-state bank equivalent still fails PSS.
2026-11-01 Bound bank-bypass switch noise and close pre-layout VCO checks.
    Switch-noise bound vs bank bias R stops at tt (+0.591 dB); draft VACASK PSS repro/issue; real LO buffer and supply-push/LDO budget recorded for P2.7.
2026-11-01 Add tapped L2n0 GDS review PNGs after CT via DRC.
    North-track CT via lands fully on L134; minimum DRC only hits TV2.a on EM via aggregates (same as two-port baseline).
2026-11-01 Record D21 LDO compensation fix and Cg=100 pF area.
    Replace Miller-to-mid with Rz+Cg; mark prior 9.5 nV unverified; re-verified noise/PM/HOLD in summaries.
2026-11-01 Move tapped L2n0 CT to outer-turn bottom mid; pass net/R checks.
    North crossover via and long stub removed (¼/¾ tap + underpass short). Short TM1 stub to CT; R(P–CT)≈R(N–CT)≈R(P–N)/2 within 2 %.
2026-11-01 Record tapped L2n0 EM pass and fix Palace dB/deg extract.
    Centre-tap L/Q within 2% of untapped with V(CT)≈0; mark P2.7 tapped done and note ~0.1 dB PN impact at ss85.
2026-11-02 Record D22 VCO amplitude control acceptance.
    Option C with offset DAC (1.52 mA + code×0.08 mA), target-not-reached flag, and interim A2; update memo and register map note.
2026-11-02 D22 step 1: amp-cal RTL, wake, ideal DAC; detector accuracy miss.
    SF+replica detector chosen (≤10 fF) but A_est fails ±0.10 V gate; search Amp≤1.40 on tt; interim A2 remains. Owner review before detector redesign.
2026-11-02 D22 step 1b: fix amplitude detector, unit-cell DAC, full corner search.
    Diagnose step-1 under-read as diode-Vth vs DC-replica; replace with
    differential max detector (V_LOSS=0.22 V). Unit-cell PMOS DAC mono/DNL
    PASS. Search with tail-only bypass reaches 1.25 V on top; bottom tnr
    expected. Interim A2 unchanged.
2026-11-11 D22 step 1c: V_DS-matched DAC full scale, tail-only bypass, SE cmp.
    Restore code-31 = 4.0 mA ±3% across corners; separate en_vco_tail_bp for
    search; second-stage comparator; record Amp_peak hard-limit misses and PN [HAND].
2026-11-11 D22 step 1d: end-to-end SAR on SE comparator; retire interim A2.
    Wire search to v(cmp); 30-corner PASS under steady 1.40 / transient 1.50 V;
    close D22 step 1 and record owner 1c decisions.
2026-11-11 P2.3 real LO load: band shift 0.285 %, [HAND] ΔL ≤ 0.5 dB.
    Full VCO+buffer+CML load vs stand-in; scaled-bank landing OK; CML PSS still aborts.
2026-11-11 P2.3 D1: HBT core comparison — keep NMOS.
    On D21/D12 HBT Amp ~1 V, fair Leeson wash, top band 4.10 GHz; VACASK HBT PSS L untrusted.
2026-11-11 P2.7.1: xschem capture of VCO, D22 amp-cal and D21 LDO.
    Hierarchical sch/sym under analog/vco/sch with SVG/PDF exports, netlist
    inventory and VACASK checks. Die-area tally added to the floorplan memo
    (1.6 mm core does not fit). Range vs archived range.json fails on a pure
    step2 re-run as well — owner decision on re-baseline before P2.7.2.
2026-11-11 P2.7.1b: explain VCO range shift, re-baseline, coverage finding.
    Off-state bank/var start-up bypass C caused the miss vs the 25-Oct
    range.json. Re-baselined sizing/trims; 15-corner coverage of 3.12-4.20 GHz
    passes (39 MHz top margin). Band steps fail at 1.06 V on the MSB carry —
    hold layout until fixed.
2026-11-11 P2.7.1c: binary-size bank bypass, re-trim, and re-check coverage.
    Equal-size plate bypasses broke MSB carries; scale W with bit weight
    (floor PDK minW), keep MSB wake size, re-trim, and gate layout on the
    0.296 V LSB-step margin vs the 0.29 V ceiling.
2026-11-11 P2.7.2 gate: D20 corner landing fails; record finding, no layout.
    ss/ff V_tune land outside the D20 windows with the accepted bank; stop before KLayout.
2026-11-12 P2.7.2b: D24 segmented bank and offset-off hold; landing gate still fails.
    Thermometer MSBs fix the ss85 MSB carry, but ss/ff V_tune still overshoot the high window — no layout.
2026-11-12 P2.7.2c: re-run landing gate at VR_ANA1 pad supplies; PASS.
    Pad corners 1.108/1.200/1.295 V; compliance and holds re-measured; D20
    landing inside the window at tt/ss/ff without bias or K=512.
2026-11-12 P2.7.2: pump linearity at landing extremes fails ss-high spur gate.
    ss 0.897 V VHF boundary spur −102.9 dBc vs ≤ −105; INL/ΔI_cp/lock pass.
    Finding recorded; VCO layout not started.
2026-11-12 P2.7.2: first VCO KLayout floorplan; DRC/LVS finding (not clean).
    Record pump-linearity gate acceptance; place EM inductor + D24 bank + core/var/tail/ampcal under D23. Commit gds.gz, renders, and reports. Density/TV2.a waivers proposed; Cnt.b/M1.b/M5.b and LVS mismatch remain open (unrouted). No PEX.
2026-11-12 P2.7.2a: LVS flow on dac_unit, hierarchy, via arrays, area finding (stop).
    Hierarchical vco_top.sch + equiv; PDK netgen/KLayout LVS proven on dac_unit
    (PASS) while bank_unit still fails; TopVia2 arrays clear TV2.a but EM Q drops
    ~3–4 % vs tapped record; compact VCO area 0.22–0.28 mm² exceeds D23 0.15–0.20
    so P2.7.2b waits on the D23 decision.
2026-11-12 P2.7.2a2: dac_unit DRC+LVS PASS; bank_unit FAIL; D23≤0.30 die tally.
    Record P2.7.2a result (D23 VCO island ≤0.30 mm², Q/LVS gates). Proof-cell
    respin with PDK via_stack and upward gate pads; dac_unit clean; bank_unit
    still shorted — root causes in layout notes. Stop before P2.7.2b.
2026-11-12 P2.7.2b: core+tank routed GDS; DRC/LVS FAIL (tn|tp merge).
    First sub-block layout with via-fixed L2n0, XC pair, fixed MIM, CT supply;
    area 0.107 mm². Pass criteria not met — record FINDING and HAND RC only.
2026-11-12 P2.7.2b re-spin: pair LVS PASS; assemble stage-a PASS; MIM/fx STOP.
    Bottom-up XC pair is DRC/LVS/netgen clean (even=D). Inductor+CT stage passes
    with LVS black-box spiral. Stage b+ rfcmim MINUS merges with gnd — FINDING.
2026-11-12 P2.7.2b re-spin 2: stages b–d LVS PASS; rfcmim fx on M2.
    Root cause was rfcmim solid M1 shield (=TIE); MINUS routes on M2 outside
    the shield. Fab/LVS GDS differ only by l2n0_em; next is D24 bank.
2026-11-12 P2.7.2b D24 bank: stages a–d DRC/LVS PASS; area 0.151 mm².
    Bottom-up from bank_unit: 5 binary + 7 thermo common-centroid; tp TM1 /
    tn TM2 corridors; island with core 0.261 mm² of ≤ 0.30.
2026-11-12 P2.7.2b bank fix: ng=100, centroid dummy, denser pack; LVS PASS.
    Area forecast fits ≤0.30 mm² without D23. Thermo sch/layout agree at
    ng=100; dummy in slot D tied to gnd; bank 0.1514 mm² (island 0.2616).
2026-11-12 P2.7.2b D9 finding: MIM no-fit; MOS fails 0.2 dB PN gate.
    Tail layout stopped. Owner must pick D9 option A–D before next sub-block.
